culturalheritagedigital/Cindymill/README.md

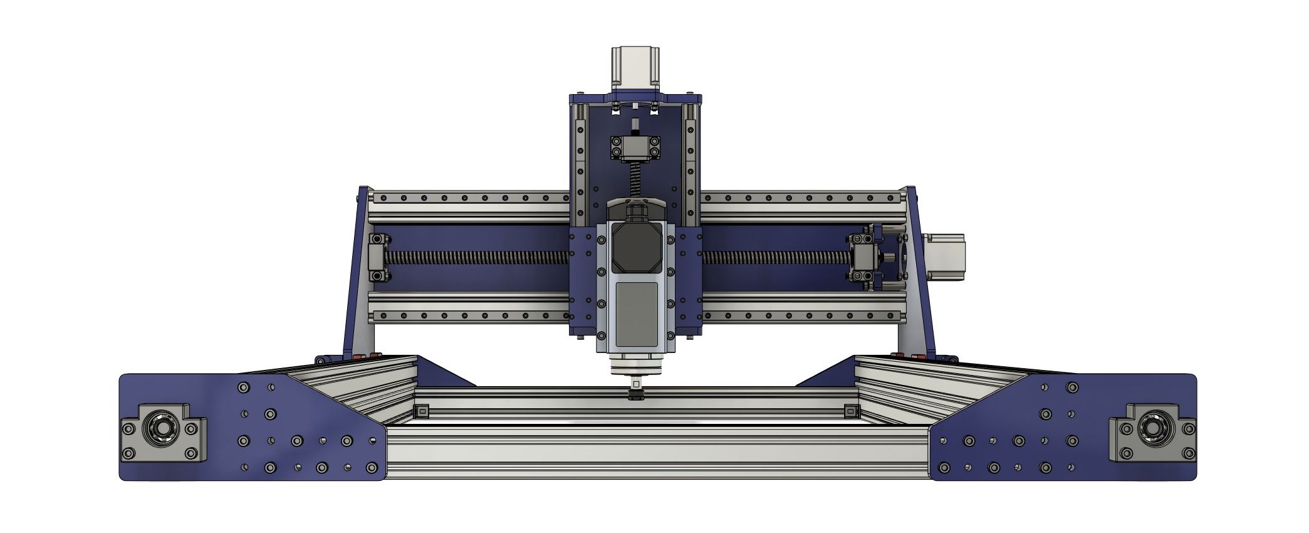
[picture p1: cindymill_front_1.jpg]
Cindymill


# Cindymill
**A gentle way to start CNC milling.**

Cindymill is a DIY CNC milling machine. It is supposed to be a good introduction to the world of milling. As you build the machine, you learn how it works. Cindymill is open source, so you can easily adapt it to your needs. The components are affordable, but the machine is rigid enough to comfortably mill aluminum (as well as wood and plastic, of course). 

## Short Specs
- Ball screws SFU1605 on X and Y,  SFU1204 on Z.
- Extruded profile: based on 20x20 Item type.
- Rails: MGN12
- Motors: NEMA23
- Work area: 750 x 475 x 120 mm, can easily be adapted to other sizes.
- Price: approx. 1500€/$.

You will find all relevant information about parts and assembly here [www.cindymill.xyz](http://www.cindymill.xyz).

If you like the project you can tip me via . Thanks. 

This work is licensed under a
[Creative Commons Attribution-NonCommercial-ShareAlike 4.0 International License][cc-by-nc-sa].

[][cc-by-nc-sa]

[cc-by-nc-sa]: http://creativecommons.org/licenses/by-nc-sa/4.0/
[cc-by-nc-sa-image]: https://licensebuttons.net/l/by-nc-sa/4.0/88x31.png
[cc-by-nc-sa-shield]: https://img.shields.io/badge/License-CC%20BY--NC--SA%204.0-lightgrey.svg

Cite the project in academics:
