culturalheritagedigital/Cindymill/Accessories/Readme.md

## Accessories

This section covers various (mostly printed) accessories which make the machine more convenient to use.

You will find descriptions about the individual parts here:

[http://www.cindymill.xyz/accessories](http://www.cindymill.xyz/addons)
