culturalheritagedigital/Cindymill/Tools/Readme.md

## Tools

These tools help you to align the portal and Z axis rails.

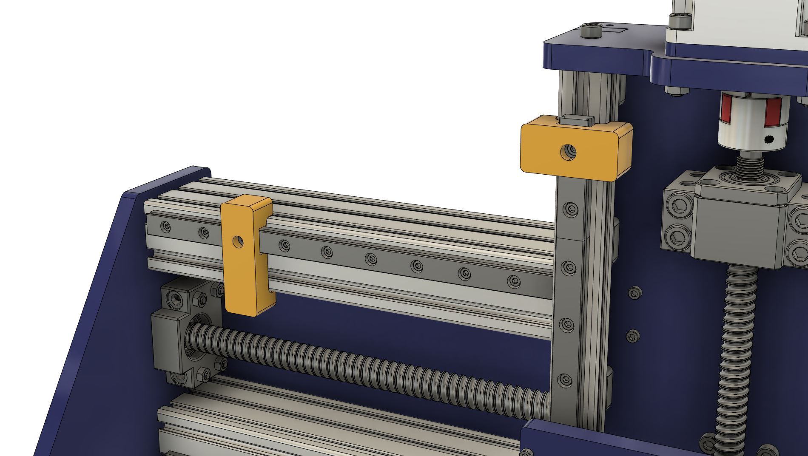
[picture p2: Tools/alignment_tools.jpg]
alignment_tools


[www.cindymill.xyz](http://www.cindymill.xyz)
