culturalheritagedigital/Cindymill/model/Accessories/Readme.md

## Accessories

This section covers various (mostly printed) accessories which make the machine more convenient to use.

You will find descriptions about the individual parts here:

[Accessories page on the Cindymill website](https://culturalheritagedigital.github.io/Cindymill/accessories.html)
