culturalheritagedigital/Cindymill/10mm_Milled_Aluminum_Version/Spacers/Readme.md

## Spacers

These are spacers you can print if not possible otherwise.
If so, print them really heavy. I did 5 perimeters in all directions, 25% infill.

[www.cindymill.xyz](http://www.cindymill.xyz)
