culturalheritagedigital/Cindymill/files.md

---
title: "Files"
layout: page
introduction: |
  You can download or fork all project files for the Cindymill from Github: 
actions:
  - label: "Download project files"
    icon: github
    url: "https://github.com/culturalheritagedigital/Cindymill"
---

In case you are new to Github:
- To download the project click the green "Code" button,
- click "Download ZIP".

download

---

If you want to adapt Cindymill to your needs you can download the __complete model as one step file__ here: 

<!-- <a href="{{ '/assets/cad/2021_09_22_Cindymill_Complete_Model.zip' | relative_url }}">Download Model</a> -->

<a href="{{ '/assets/cad/2021_09_22_Cindymill_Complete_Model.zip' | relative_url }}">
Step File
</a>

Current version: 2021_09_22

---

If you want to compare the target and actual dimensions of your machined plates, you can download __drawings with marked dimensions__ [here]({{ '/assets/cad/Cindymill_Drawings.zip' | relative_url }}).

<br>

<a rel="license" href="https://creativecommons.org/licenses/by-nc-sa/4.0/">Creative Commons License</a><br />This work is licensed under a <a rel="license" href="https://creativecommons.org/licenses/by-nc-sa/4.0/">Creative Commons Attribution-NonCommercial-ShareAlike 4.0 International License</a>.
