culturalheritagedigital/Cindymill/gallery.md

---
title: "Gallery"
layout: page

image: 
  path: /assets/images/gallery/frame_bw.jpg
  thumbnail: /assets/images/gallery/frame_bw.jpg

introduction: |
  A growing collection of Cindymill related images and videos. Enjoy!
---

## Frame

<figure class="align-center">
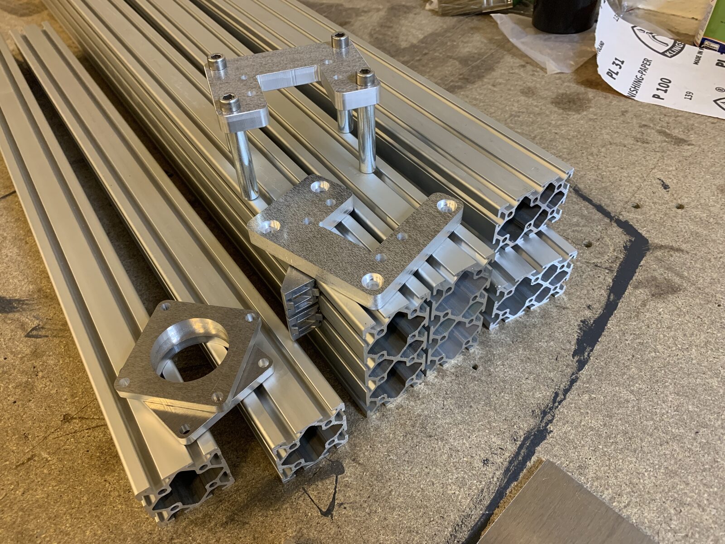
[picture p3: assets/images/gallery/frame/frame2.jpg]
  
  <figcaption>Frame profiles</figcaption>
</figure> 

<figure class="align-center">
  
  <figcaption>Thread cutting</figcaption>
</figure> 

<figure class="align-center">
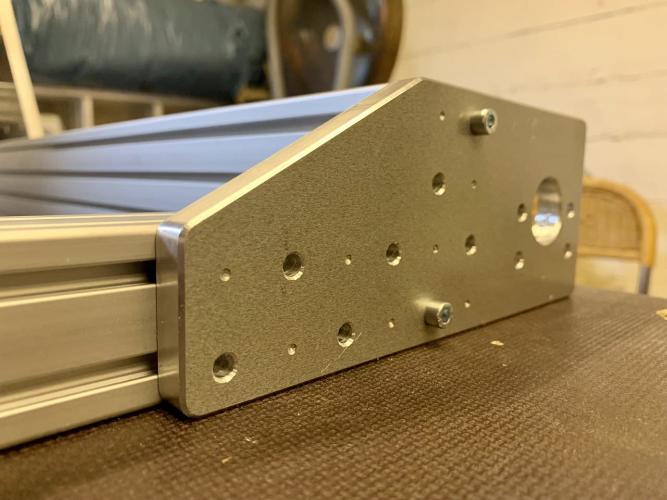
[picture p4: assets/images/gallery/frame/frame10.jpg]
  
  <figcaption>Frame assembly</figcaption>
</figure> 

<figure class="align-center">
  
  <figcaption>Indymill comparison</figcaption>
</figure> 

<figure class="align-center">
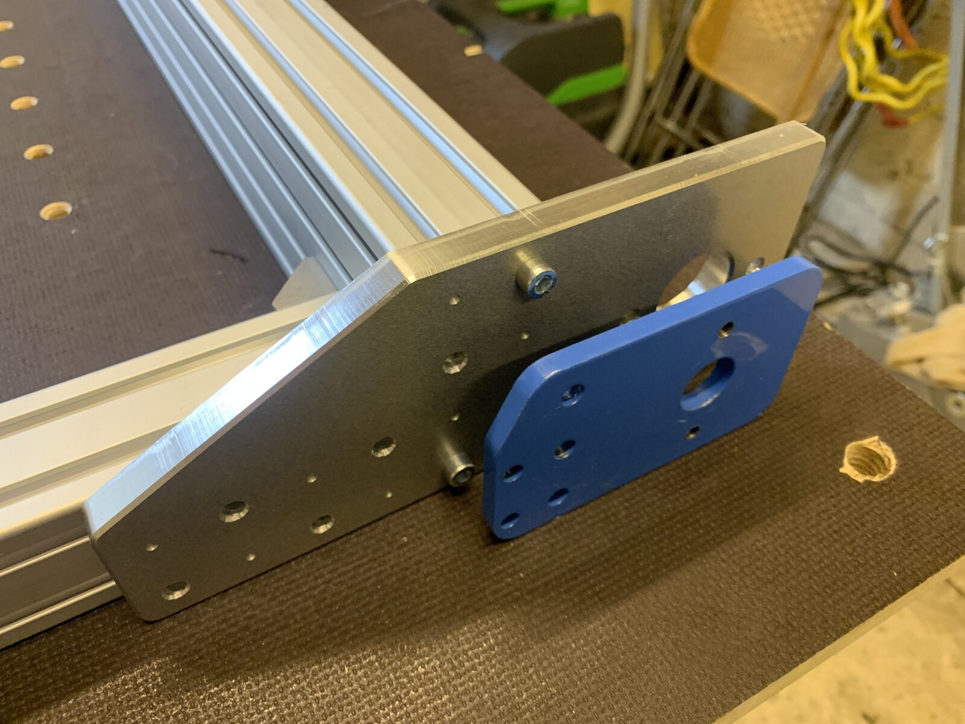
[picture p5: assets/images/gallery/frame/frame12.jpg]
  
  <figcaption>Indymill comparison</figcaption>
</figure> 

<figure class="align-center">
  
  <figcaption>Frame assembly</figcaption>
</figure> 

<figure class="align-center">
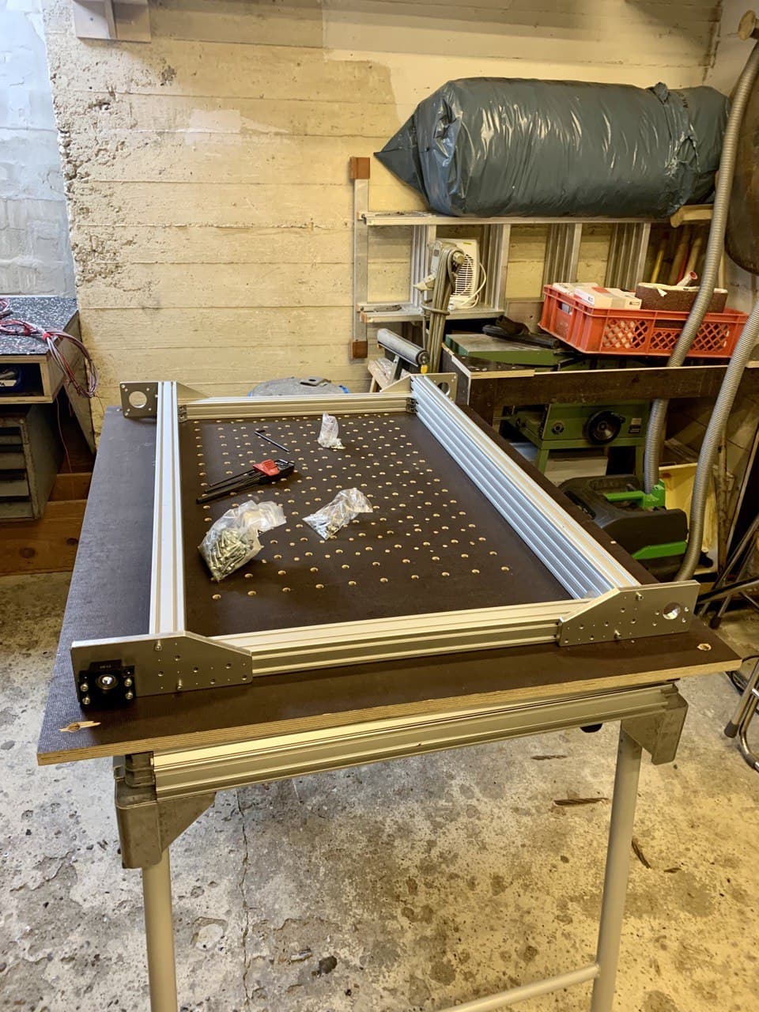
[picture p6: assets/images/gallery/frame/frame8.jpg]
  
  <figcaption>Frame assembly</figcaption>
</figure> 

<figure class="align-center">
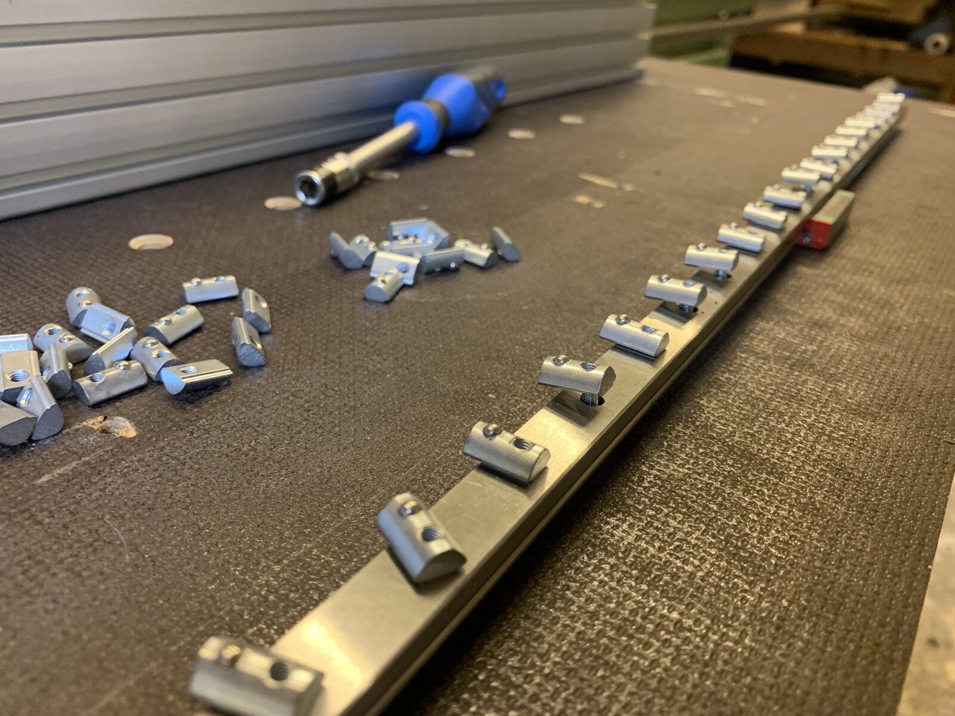
[picture p7: assets/images/gallery/frame/frame14.jpg]
  
  <figcaption>Frame assembly</figcaption>
</figure> 

<figure class="align-center">
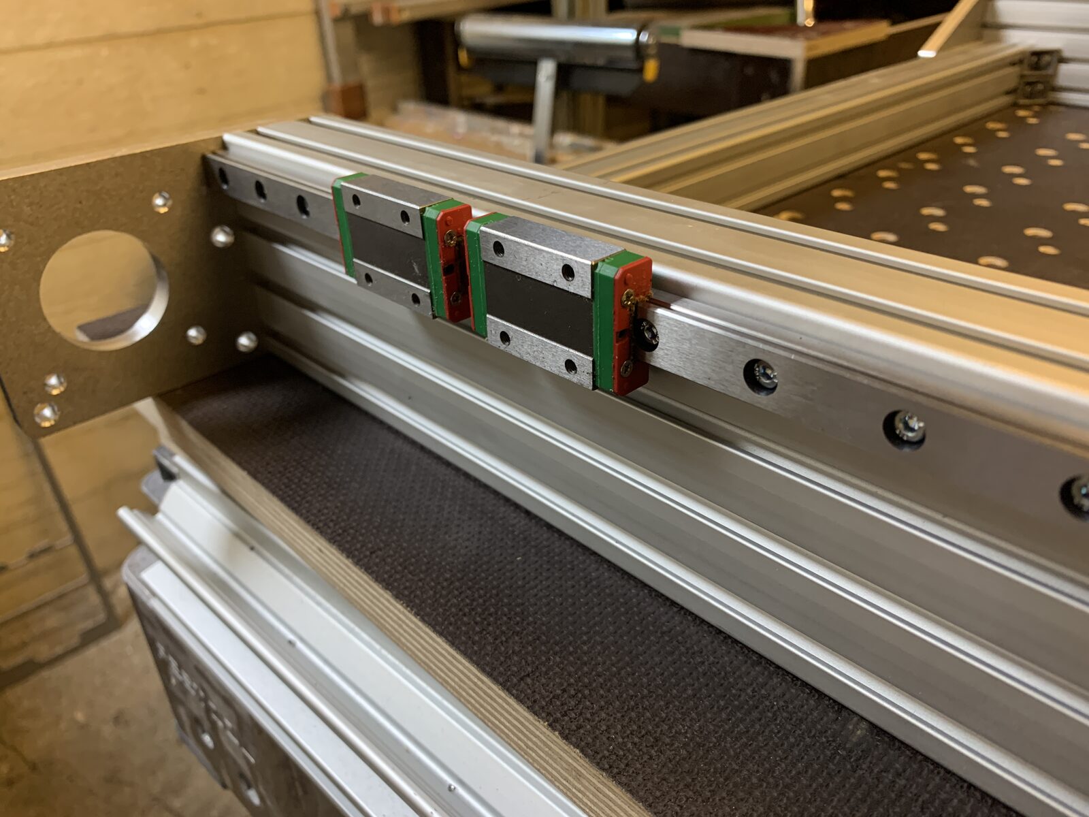
[picture p8: assets/images/gallery/frame/frame15.jpg]
  
  <figcaption>Frame assembly</figcaption>
</figure> 

<figure class="align-center">
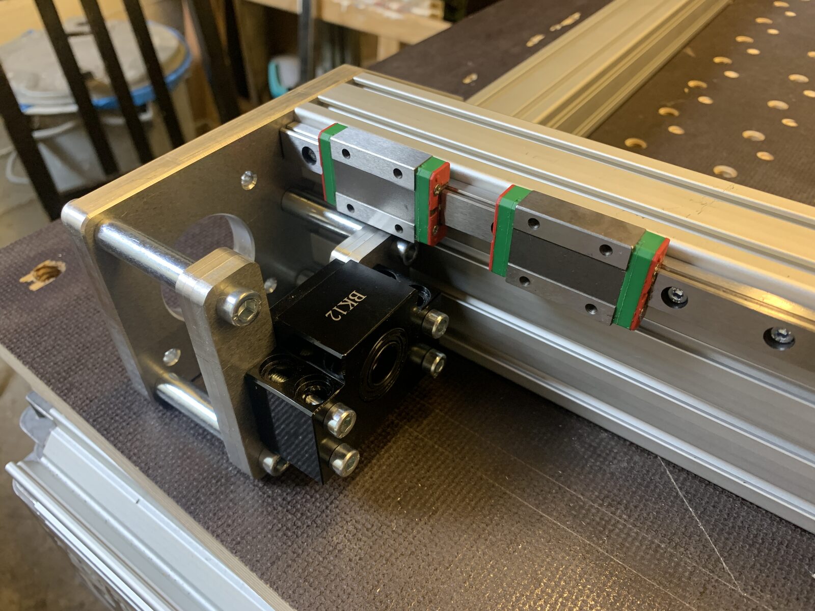
[picture p9: assets/images/gallery/frame/frame18.jpg]
  
  <figcaption>Frame assembly</figcaption>
</figure> 

<figure class="align-center">
  
  <figcaption>Frame assembly</figcaption>
</figure> 

<figure class="align-center">
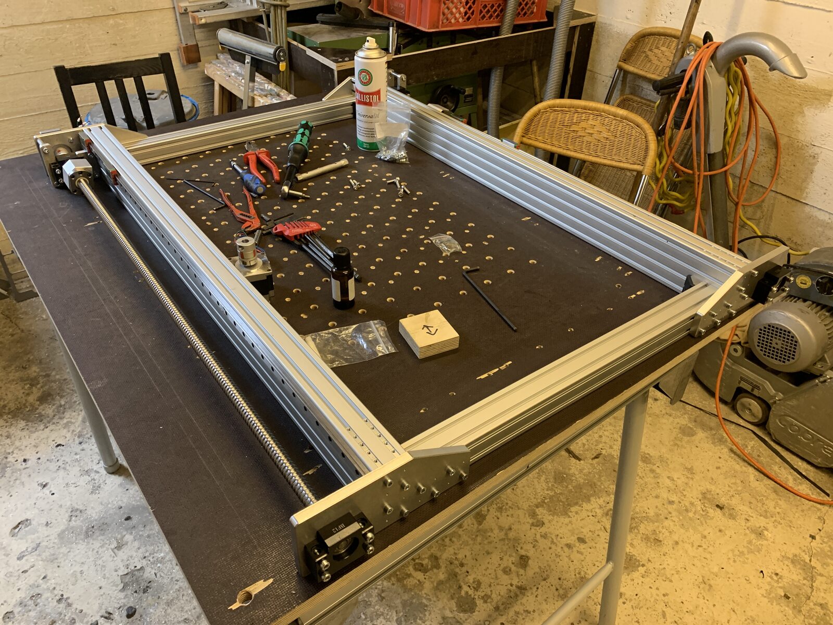
[picture p10: assets/images/gallery/frame/frame22.jpg]
  
  <figcaption>Frame assembly</figcaption>
</figure> 

<figure class="align-center">
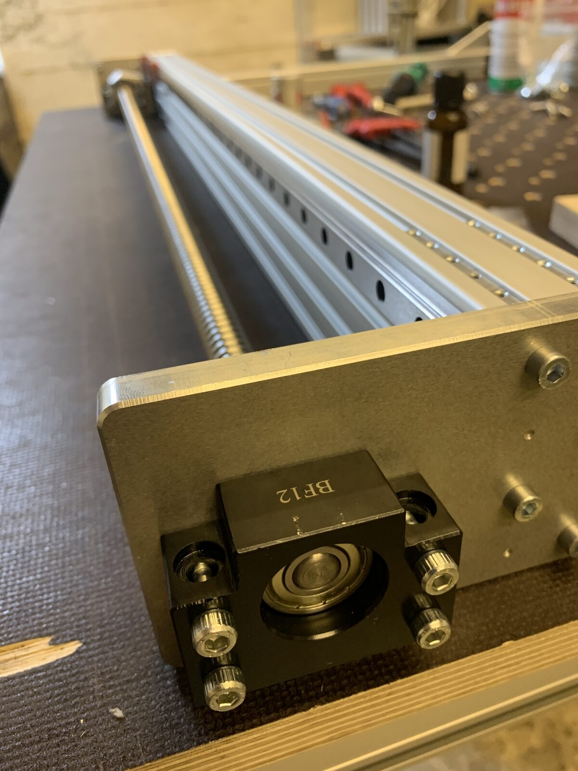
[picture p11: assets/images/gallery/frame/frame23.jpg]
  
  <figcaption>Frame assembly</figcaption>
</figure> 

<figure class="align-center">
  
  <figcaption>Frame assembly</figcaption>
</figure> 

<figure class="align-center">
  
  <figcaption>Frame assembly</figcaption>
</figure> 

<figure class="align-center">
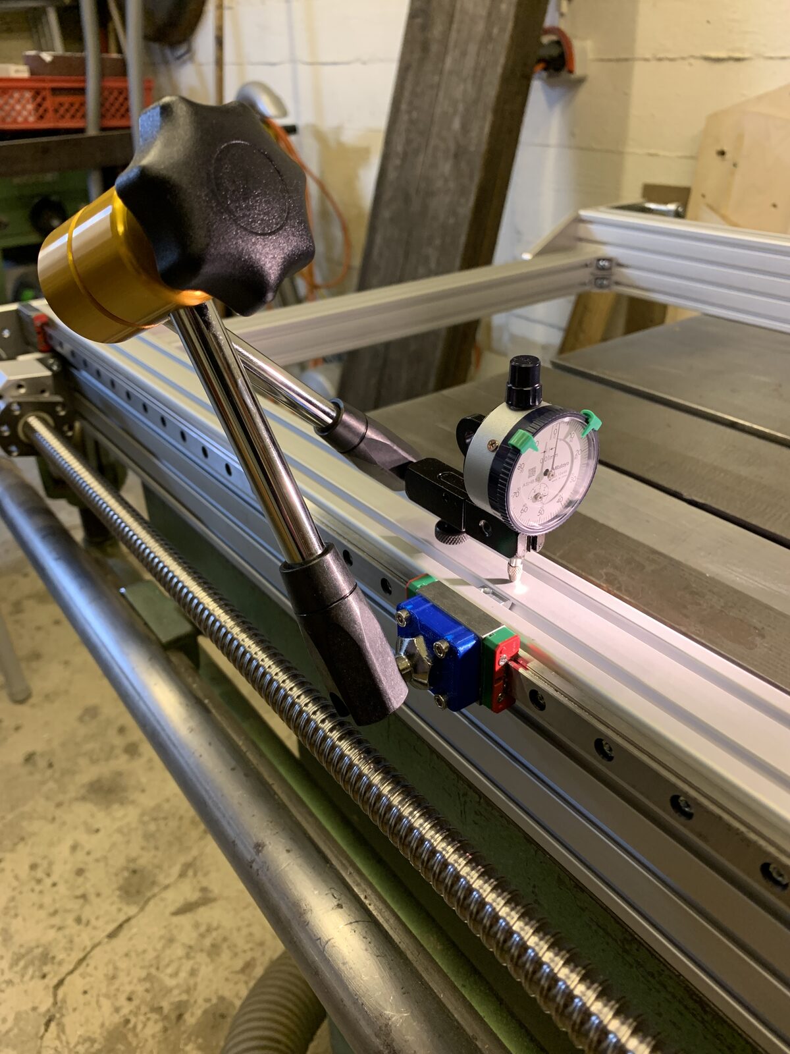
[picture p12: assets/images/gallery/frame/frame_alignment1.jpg]
  
  <figcaption>Rail alignment</figcaption>
</figure> 

<!-- <figure class="align-center">
  <a href="#"><img src="{{ '/assets/images/gallery/frame/plates2.jpg' | relative_url }}" alt=""></a>
  <figcaption>Testing threaded steel sockets</figcaption>
</figure>  -->

<!-- <figure class="align-center">
  <a href="#"><img src="{{ '/assets/images/gallery/frame/frame3.jpg' | relative_url }}" alt=""></a>
  <figcaption>Testing threaded steel sockets</figcaption>
</figure>  -->

<!-- ################################################################################################################ -->

## Portal

<figure class="align-center">
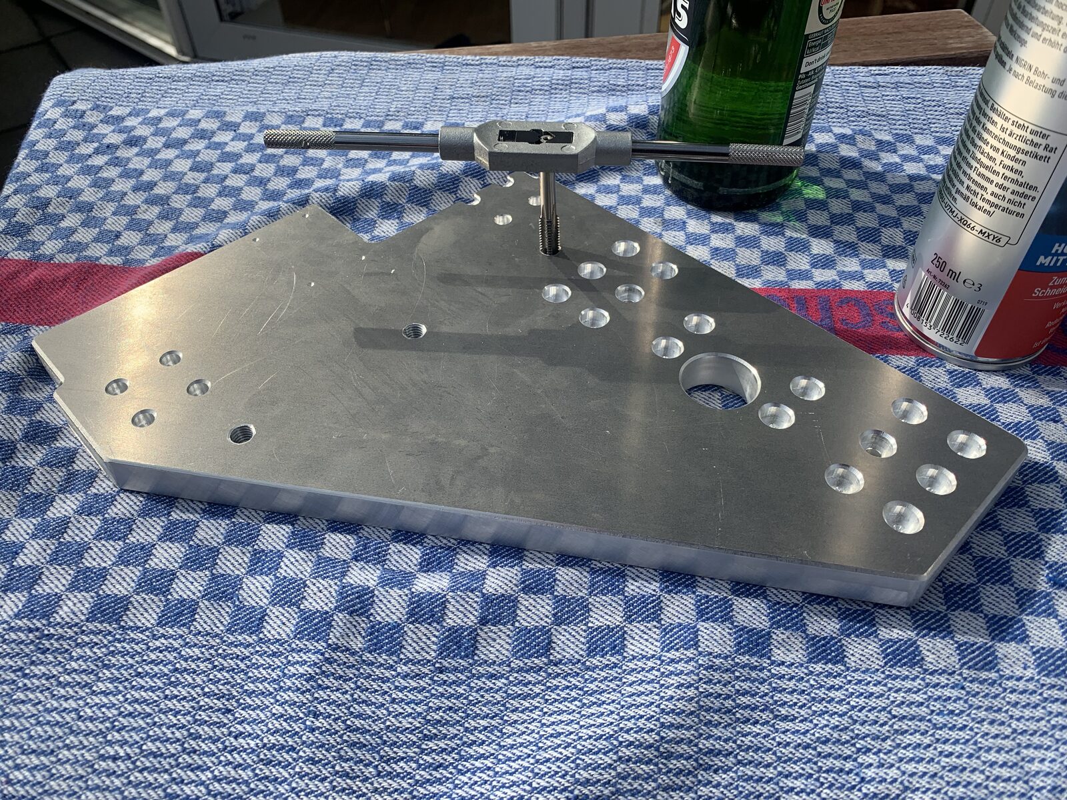
[picture p13: assets/images/gallery/portal/plates8.jpg]
  
  <figcaption>Thread cutting</figcaption>
</figure> 

<figure class="align-center">
  
  <figcaption>Portal assembly</figcaption>
</figure> 

<figure class="align-center">
  
  <figcaption>Portal assembly</figcaption>
</figure> 

<figure class="align-center">
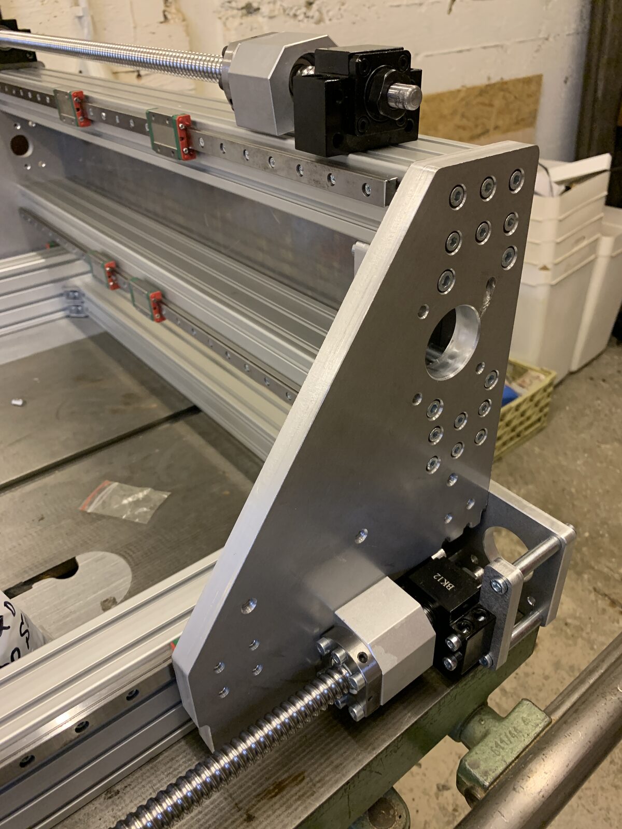
[picture p14: assets/images/gallery/portal/IMG_3700.JPG]
  
  <figcaption>Portal assembly</figcaption>
</figure> 

<figure class="align-center">
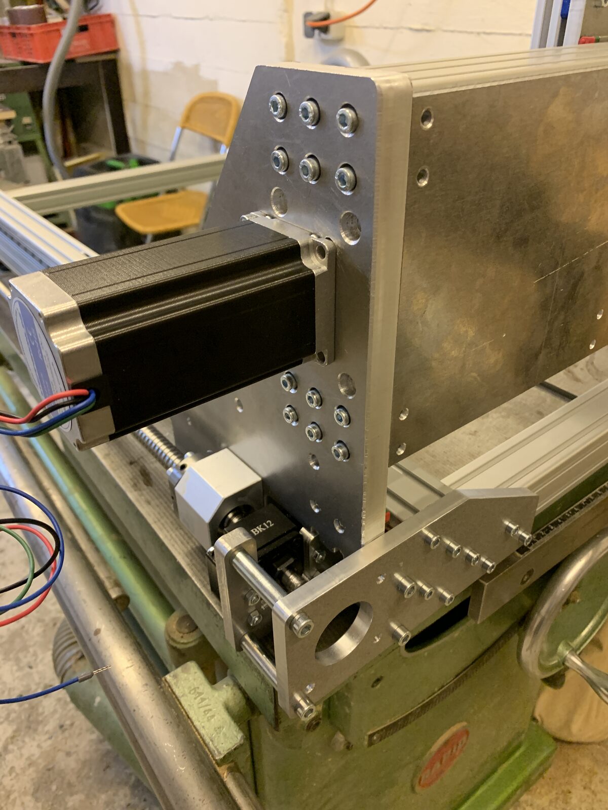
[picture p15: assets/images/gallery/portal/IMG_3696.JPG]
  
  <figcaption>Portal assembly</figcaption>
</figure> 

<!-- <figure class="align-center">
  <a href="#"><img src="{{ '/assets/images/gallery/portal/IMG_3702.JPG' | relative_url }}" alt=""></a>
  <figcaption>Portal assembly</figcaption>
</figure>  -->

<figure class="align-center">
  
  <figcaption>Portal assembly</figcaption>
</figure> 

<figure class="align-center">
  
  <figcaption>Portal assembly</figcaption>
</figure> 

<figure class="align-center">
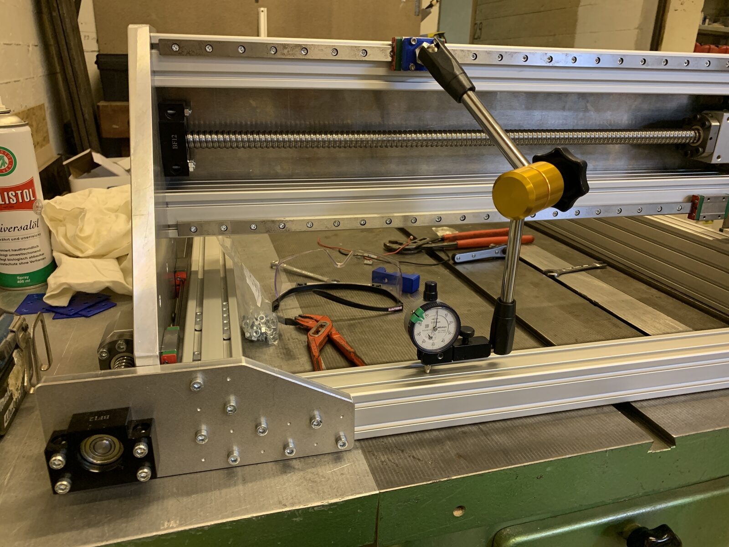
[picture p16: assets/images/gallery/portal/IMG_3705.JPG]
  
  <figcaption>Portal rail alignment</figcaption>
</figure> 

<!-- <figure class="align-center">
  <a href="#"><img src="{{ '/assets/images/gallery/portal/portal1.jpg' | relative_url }}" alt=""></a>
  <figcaption>Portal assembly</figcaption>
</figure> 

<figure class="align-center">
  <a href="#"><img src="{{ '/assets/images/gallery/portal/portal2.jpg' | relative_url }}" alt=""></a>
  <figcaption>Portal assembly</figcaption>
</figure> 

<figure class="align-center">
  <a href="#"><img src="{{ '/assets/images/gallery/portal/portal3.jpg' | relative_url }}" alt=""></a>
  <figcaption>Portal assembly</figcaption>
</figure>  -->

<figure class="align-center">
  
  <figcaption>Comparison with Indymill</figcaption>
</figure> 

<!-- ################################################################################################################ -->

## Z Axis

<figure class="align-center">
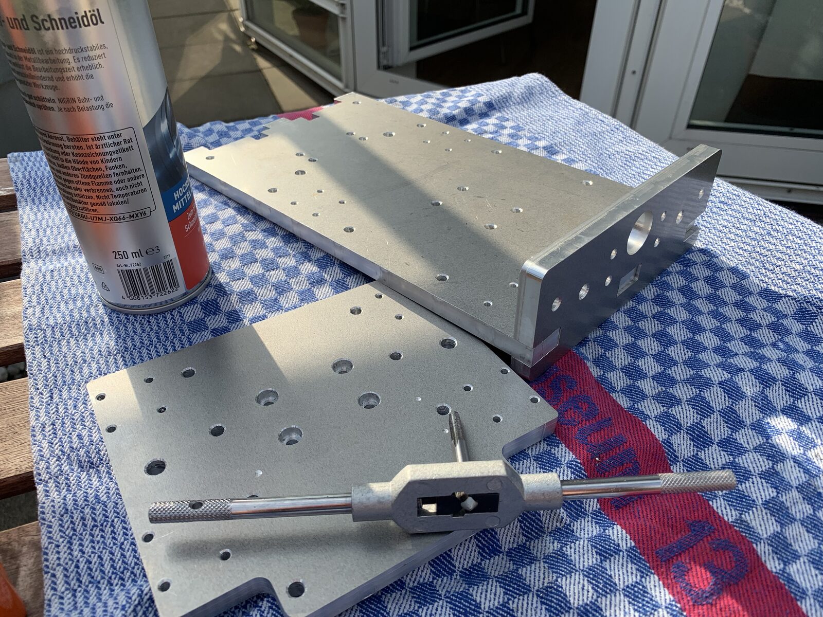
[picture p17: assets/images/gallery/zaxis/plates7.jpg]
  
  <figcaption>Thread cutting</figcaption>
</figure> 

<figure class="align-center">
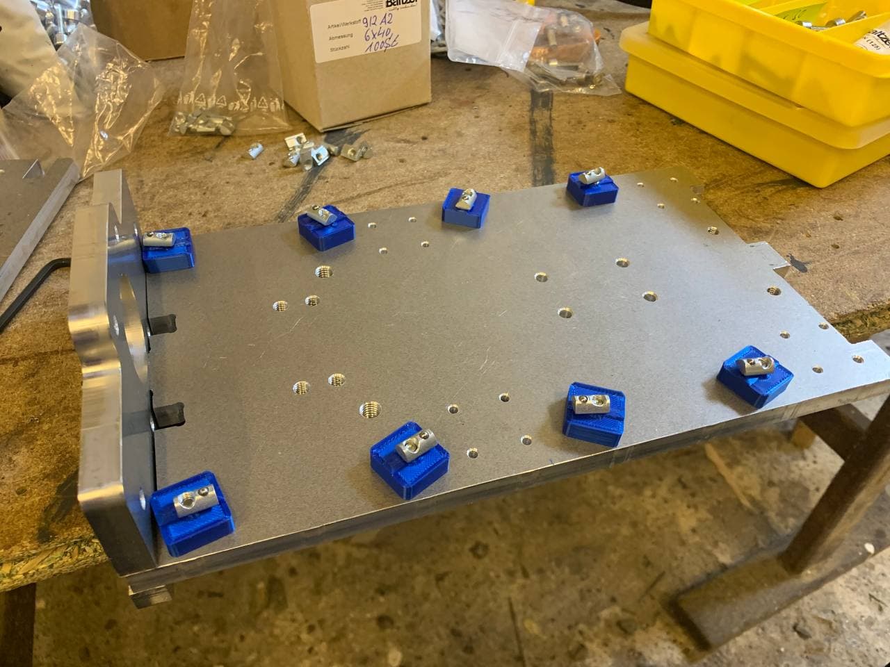
[picture p18: assets/images/gallery/zaxis/zaxis4.jpg]
  
  <figcaption>Z axis assembly</figcaption>
</figure> 

<figure class="align-center">
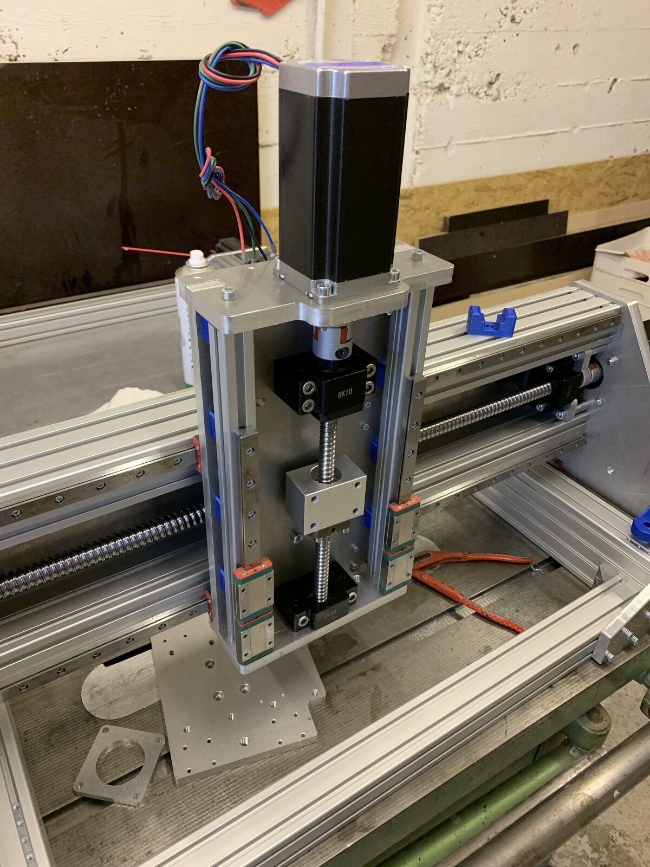
[picture p19: assets/images/gallery/zaxis/IMG_3723.JPG]
  
  <figcaption>Z axis assembly</figcaption>
</figure> 

<figure class="align-center">
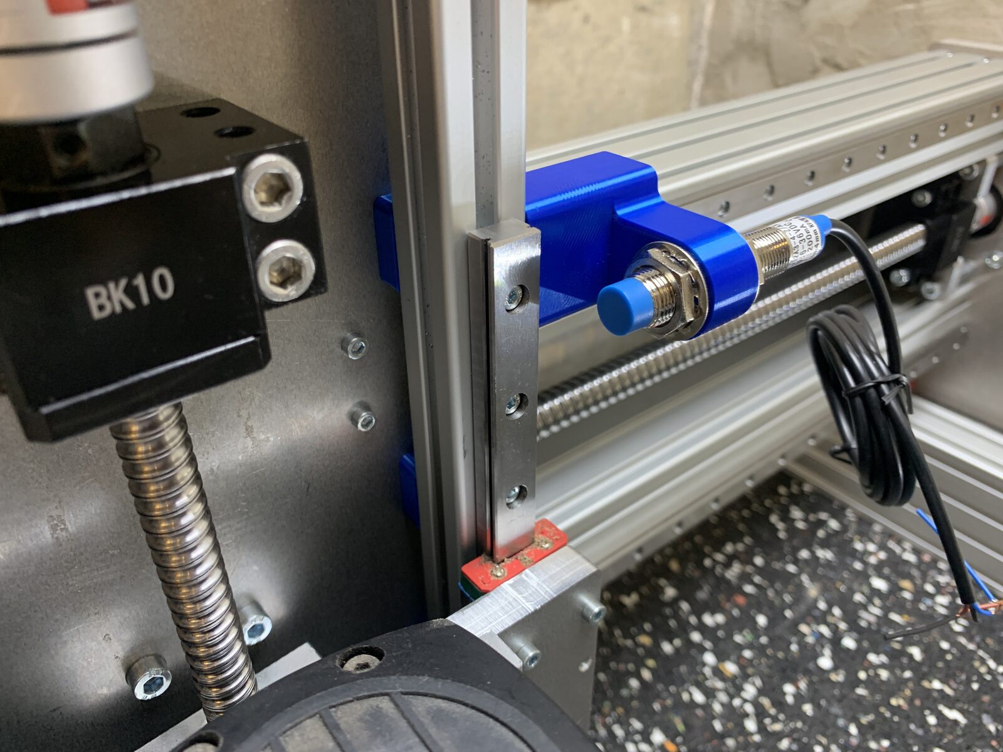
[picture p20: assets/images/gallery/zaxis/IMG_3743.JPG]
  
  <figcaption>Z axis limit switch</figcaption>
</figure> 

<figure class="align-center">
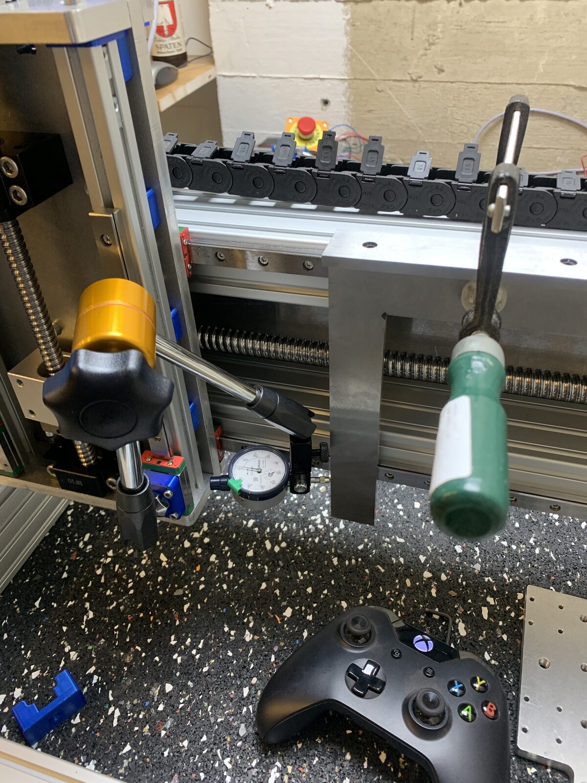
[picture p21: assets/images/gallery/zaxis/IMG_3753.JPG]
  
  <figcaption>Z axis alignment</figcaption>
</figure> 

<figure class="align-center">
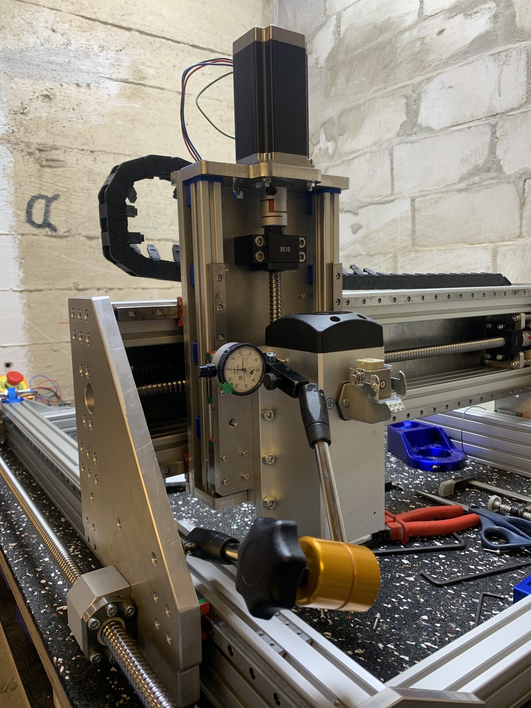
[picture p22: assets/images/gallery/zaxis/IMG_3757.JPG]
  
  <figcaption>Spindle alignment</figcaption>
</figure> 

<figure class="align-center">
  
  <figcaption>Yeah!</figcaption>
</figure> 

<figure class="align-center">
  
  <figcaption>Yeah!</figcaption>
</figure> 

<!-- <figure class="align-center">
  <a href="#"><img src="{{ '/assets/images/gallery/zaxis/zaxis1.jpg' | relative_url }}" alt=""></a>
  <figcaption>Z axis assembly</figcaption>
</figure> 

<figure class="align-center">
  <a href="#"><img src="{{ '/assets/images/gallery/zaxis/zaxis3.jpg' | relative_url }}" alt=""></a>
  <figcaption>Z axis assembly</figcaption>
</figure>  -->

<!-- ################################################################################################################ -->

## Electronics

<figure class="align-center">
  
  <figcaption>Finished soldering the shield</figcaption>
</figure> 

<figure class="align-center">
  
  <figcaption>Backside of the shield</figcaption>
</figure> 

<figure class="align-center">
  
  <figcaption>It works!</figcaption>
</figure> 

<!-- ################################################################################################################ -->

## Ball Screw Preparation

<figure class="align-center">
  
  <figcaption>Degreasing ball screw nuts</figcaption>
</figure> 

<figure class="align-center">
  
  <figcaption>Degreasing ball screw nuts</figcaption>
</figure> 

<figure class="align-center">
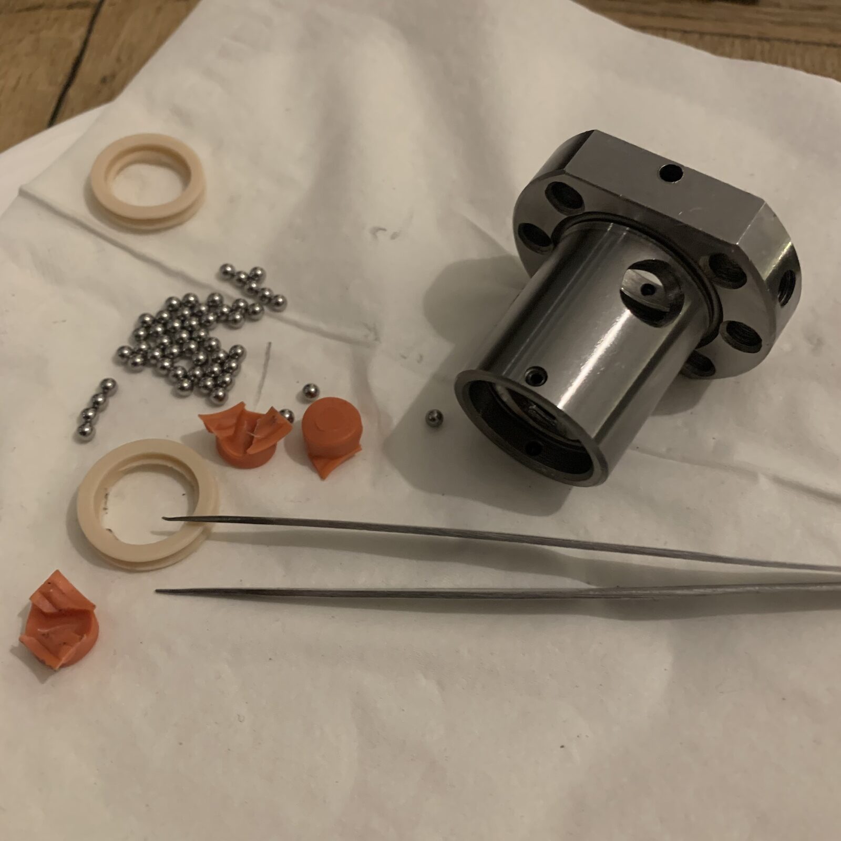
[picture p23: assets/images/gallery/ballscrew/ballscrew1.jpg]
  
  <figcaption>Ball screw nut parts</figcaption>
</figure> 

<figure class="align-center">
  
  <figcaption>Nut assembly</figcaption>
</figure> 

<figure class="align-center">
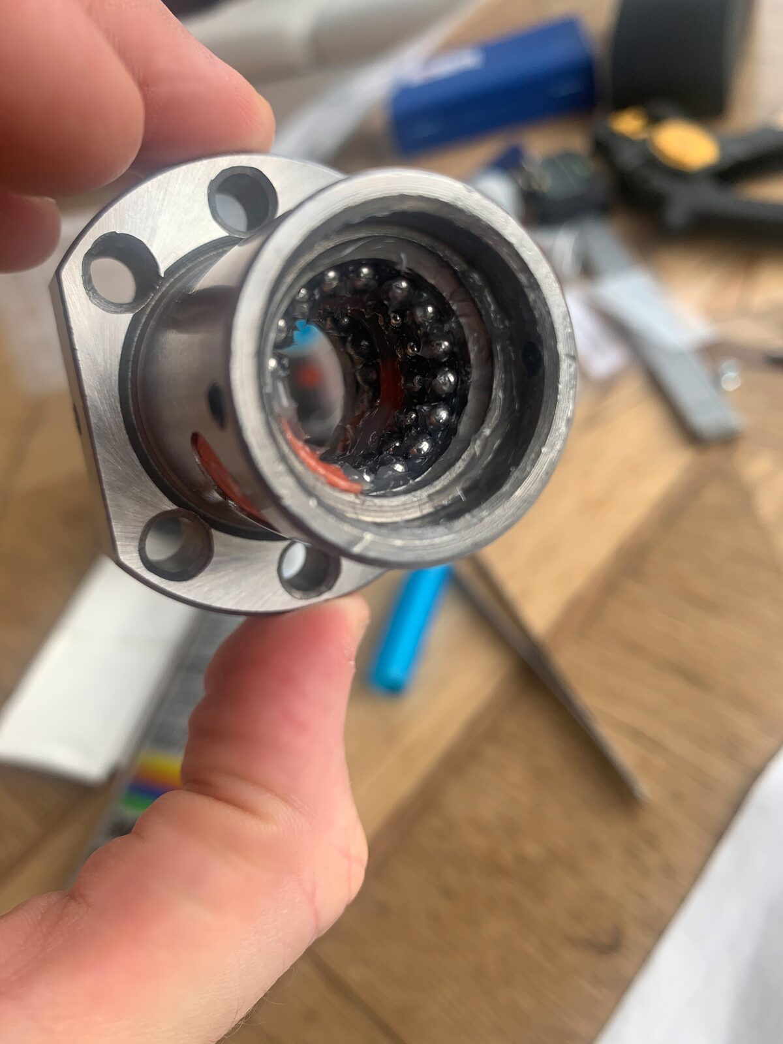
[picture p24: assets/images/gallery/ballscrew/ballscrew2.jpg]
  
  <figcaption>Fresh!</figcaption>
</figure> 

<!-- ################################################################################################################ -->

## Milling

<figure class="align-center">
  
  <figcaption>Milling frame plates</figcaption>
</figure> 

<figure class="align-center">
  
  <figcaption>Milling frame plates</figcaption>
</figure> 

<figure class="align-center">
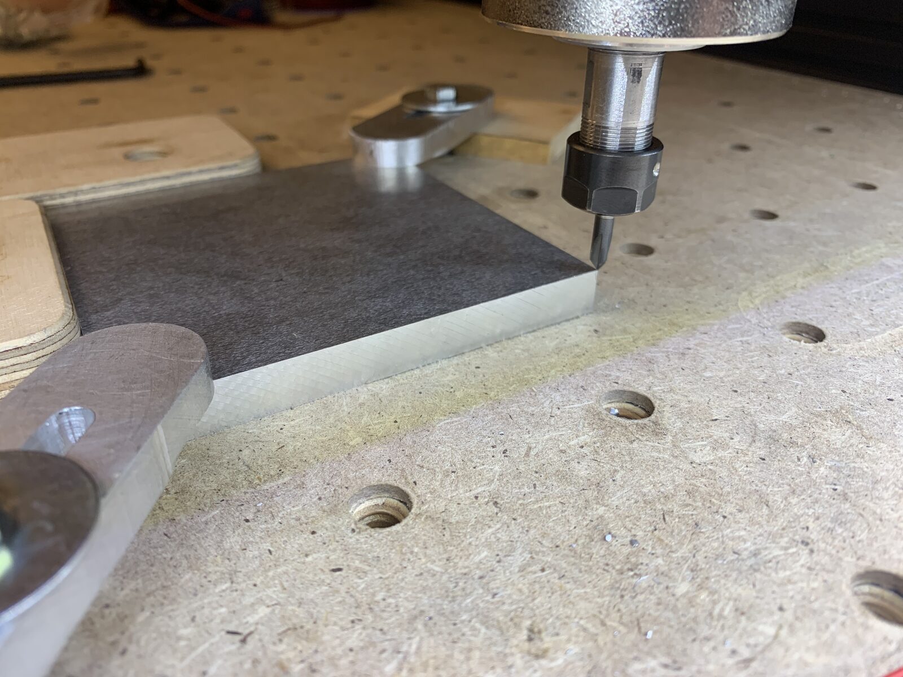
[picture p25: assets/images/gallery/milling/milling1.jpg]
  
  <figcaption>Milling aluminum</figcaption>
</figure> 

<figure class="align-center">
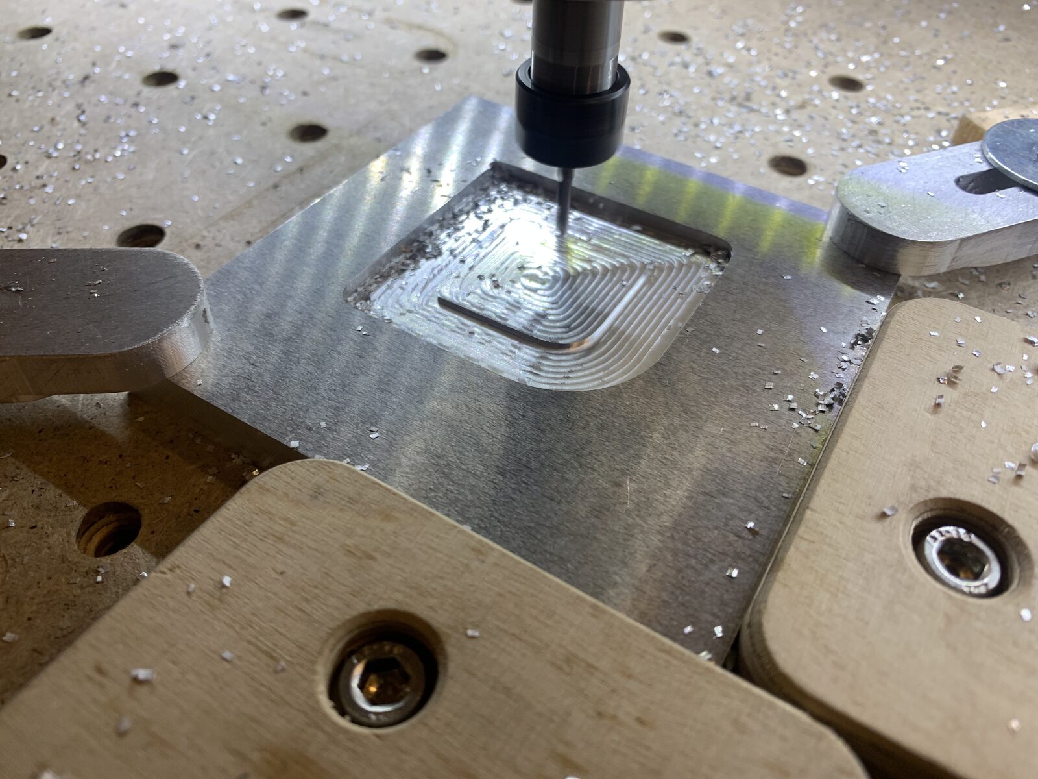
[picture p26: assets/images/gallery/milling/milling2.jpg]
  
  <figcaption>Milling aluminum</figcaption>
</figure> 

<figure class="align-center">
  
  <figcaption>Milling aluminum</figcaption>
</figure> 

<figure class="align-center">
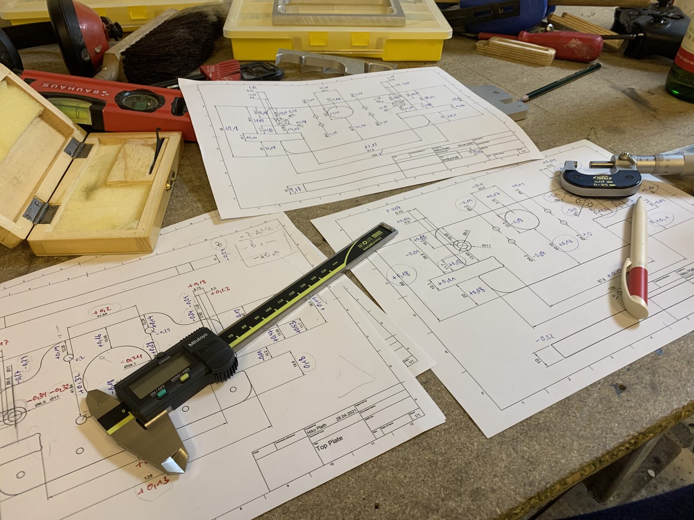
[picture p27: assets/images/gallery/milling/measurements5.jpg]
  
  <figcaption>Measurements</figcaption>
</figure> 

<figure class="align-center">
  
  <figcaption>Milling acrylic</figcaption>
</figure> 

<figure class="align-center">
  
  <figcaption>Milling acrylic</figcaption>
</figure> 

<figure class="align-center">
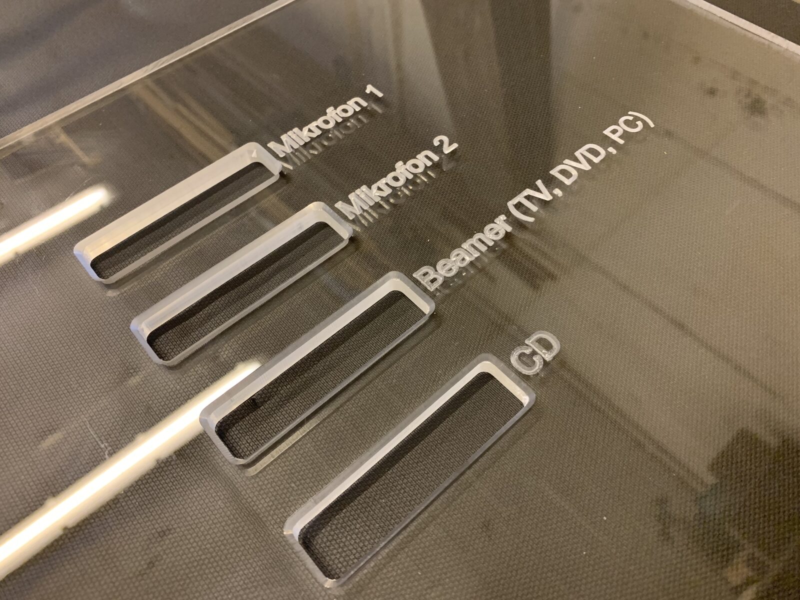
[picture p28: assets/images/gallery/milling/acrylic3.jpg]
  
  <figcaption>Milling acrylic</figcaption>
</figure> 

<!-- ################################################################################################################ -->

## Stuff

<figure class="align-center">
  
  <figcaption>Inductive limit switches</figcaption>
</figure> 

<figure class="align-center">
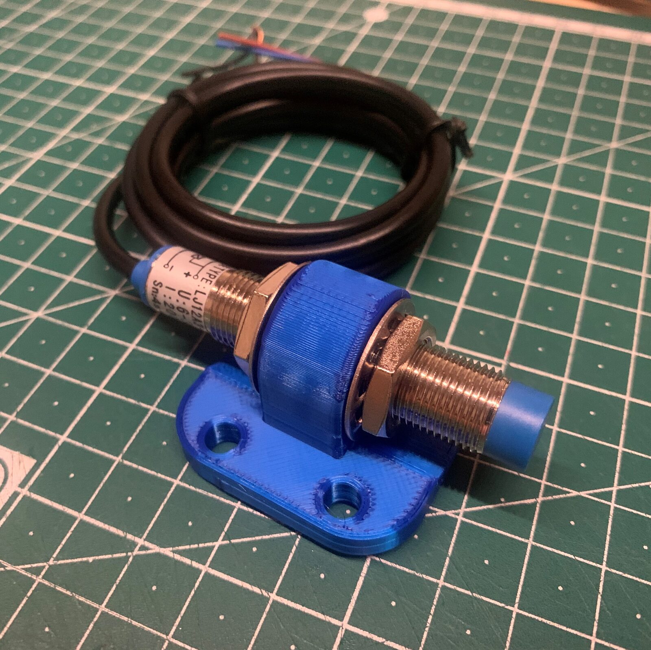
[picture p29: assets/images/gallery/stuff/limitswitches2.jpg]
  
  <figcaption>Limit switch holder</figcaption>
</figure> 

<figure class="align-center">
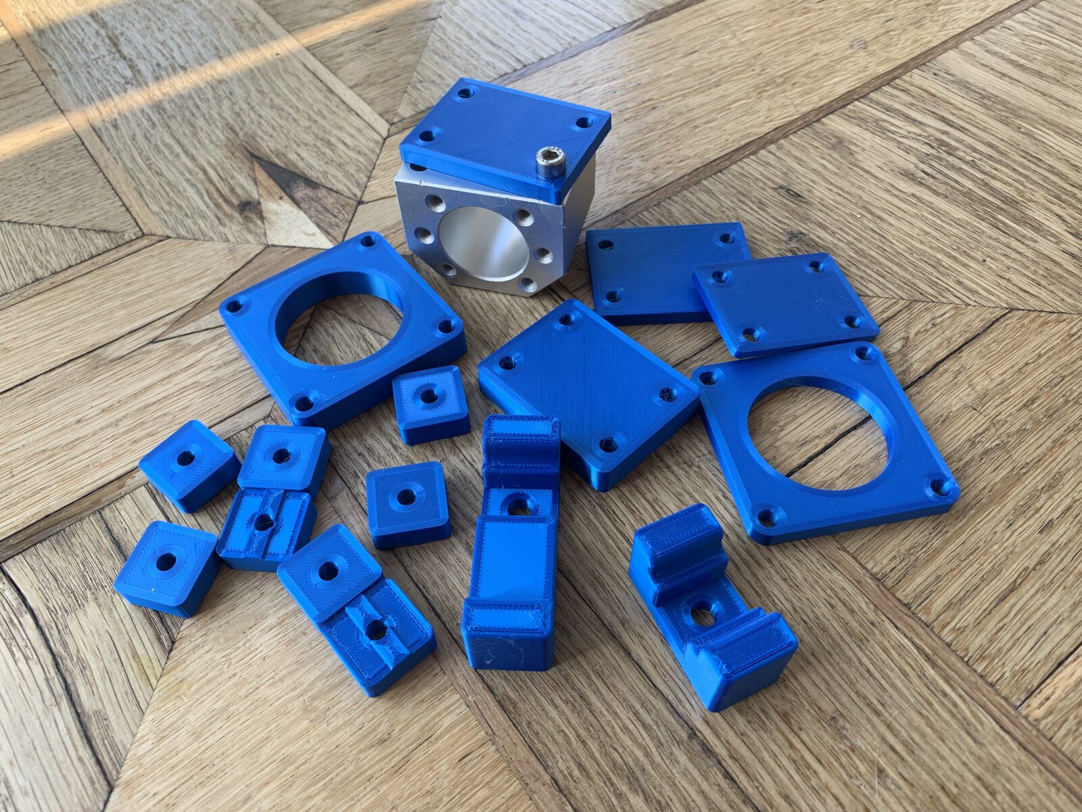
[picture p30: assets/images/gallery/stuff/printed1.jpg]
  
  <figcaption>Printed parts</figcaption>
</figure> 

<figure class="align-center">
  
  <figcaption>Table for the machine</figcaption>
</figure> 

<figure class="align-center">
  
  <figcaption>Table for the machine</figcaption>
</figure> 

<figure class="align-center">
  
  <figcaption>Vacuum cleaner holder for 1.5kW spindle</figcaption>
</figure> 

<figure class="align-center">
  
  <figcaption>Vacuum cleaner holder for 1.5kW spindle</figcaption>
</figure> 

<figure class="align-center">
  
  <figcaption>Vacuum cleaner holder for 1.5kW spindle</figcaption>
</figure>
