culturalheritagedigital/Cindymill/_posts/2021-08-15-Gallery.md

---
title: "Gallery added!"
read_time: true
layout: post
categories:
  - start
tags:
  - content
image: "/assets/images/frame_bw.jpg"
---
I added a gallery with a (growing) collection of Cindymill related images: assembly process, tools, parts, measurements, failures and successes. [Feel free to take a look around!]({{ '/gallery.html' | relative_url }}){:target="_blank"}
