culturalheritagedigital/Cindymill/_posts/2021-09-27-Accessories.md

---
title: "Accessories section added!"
read_time: true
layout: post
categories:
  - start
tags:
  - content
image: "/assets/images/Accessories_Post_Title1.jpg"
---
I added a new section with accessories for the Cindymill: limit switches, cable chains, and a vacuum cleaner holder so far.
All files can be downloaded (in stl and step format) from Github.
[Take a look around!]({{ '/accessories.html' | relative_url }}){:target="_blank"}
