culturalheritagedigital/Cindymill/assets/images/badges/README.txt

Badges — lokal ausgeliefert statt von Fremdservern (AP 5, Befund L)
==================================================================

Diese drei Dateien wurden am 30.07.2026 einmalig von ihren Ursprungs-Hosts
geladen und liegen seitdem im Repository. Der Grund ist Datenschutz: jeder
Abruf eines Bildes von einem fremden Host uebertraegt die IP-Adresse der
Besucherin oder des Besuchers dorthin — ohne Einwilligung und ohne dass es
im Seiteninhalt sichtbar waere. Es ist dieselbe Ueberlegung, aus der in
AP 4 die Google Fonts self-hosted wurden.

Die verlinkten Ziele (PayPal, Creative Commons, Zenodo-DOI) sind unveraendert
geblieben — nur die Bilder kommen jetzt aus dem eigenen Repo.

  paypal-tip-me.svg
    https://img.shields.io/badge/PayPal-tip%20me-green.svg?logo=paypal
    109x20 px. shields.io stellt seine Badges unter CC0 1.0 bereit.
    Das PayPal-Logo steckt als data:-URI im SVG, es gibt keine
    externen Referenzen darin.

  cc-by-nc-sa-4.0-88x31.png
    https://licensebuttons.net/l/by-nc-sa/4.0/88x31.png
    88x31 px. Byte-identisch mit dem Button von
    https://i.creativecommons.org/l/by-nc-sa/4.0/88x31.png (SHA-256
    c15eb6363ffed47e2913229559af9d19974d4dc35e97a84bac0bb3e25bdc87c8),
    deshalb bedient diese eine Datei beide bisherigen Einbindungen
    (index.html und files.md). Creative Commons stellt die Lizenz-Buttons
    ausdruecklich zur Kennzeichnung der eigenen Werke bereit; die
    CC-Marken bleiben Eigentum von Creative Commons.

  zenodo-doi-5118794.svg
    https://zenodo.org/badge/DOI/10.5281/zenodo.5118794.svg
    184x20 px. Zeigt den DOI 10.5281/zenodo.5118794.

Der Preis dieser Entscheidung: die Badges sind jetzt Standbilder. Der
Zenodo-Badge wuerde eine neue DOI-Version nicht mehr selbst nachziehen —
bei einem neuen Release ist diese Datei zu ersetzen. Genutzt wurde diese
Aktualisierbarkeit ohnehin nie: die DOI steht seit 2021 unveraendert im
Quelltext.
