culturalheritagedigital/Cindymill/MODERNISIERUNG_UND_GITHUB_PAGES.md

# Cindymill — Technische Modernisierung & Umzug zu GitHub Pages

**Stand:** 30.07.2026 (Rev. 11 — AP 0–6 ausgeführt, AP 7.1/7.2/7.3-Readmes erledigt. **Die Site ist live:** https://culturalheritagedigital.github.io/Cindymill/)
**Arbeitsordner (Jekyll-Quellcode):** `/Users/nikoplath/Code/2026_Website_Cindymill`
**Backup des Ionos-Servers:** `/Users/nikoplath/Code/2026_Backup_Website_Cindymill_Ionos` (FTP-Spiegel inkl. `logs/`, 995 MB)

> Der frühere Quellordner `/Users/nikoplath/Daten/Website/Cindymill/work/` ist leer — der Quellcode liegt jetzt vollständig im Arbeitsordner. Der FTP-Spiegel ist ins Backup ausgelagert. Damit ist die Ausgangslage sauber getrennt.

## Rahmenbedingungen (Entscheidungen vom 29.07.2026)

| Entscheidung | Konsequenz |
|---|---|
| **Inhalt bleibt 1:1 erhalten**, die Seite wird **nicht erweitert** | Rein technischer Umzug. Keine neuen Seiten, keine neuen Medien, kein Reaktivieren auskommentierter Inhalte (Videos, Suche). |
| **Ionos-Webspace *und* Domain `cindymill.xyz` werden gekündigt** | Kein Custom-Domain-Setup, kein DNS, kein CNAME. Zieladresse ist dauerhaft `https://culturalheritagedigital.github.io/Cindymill/`. Siehe Risiken. |
| **Die Website zieht in das bestehende Repo `culturalheritagedigital/Cindymill`** | Das Repo wird umgewidmet: Website im Root, Modelldaten im Unterordner `model/`. Sterne, Forks, Issues und die 54 Commits Historie bleiben erhalten. `baseurl` ist `/Cindymill` (Groß-/Kleinschreibung beachten). |
| **Nicht genutzte Assets werden gelöscht** | 346 Dateien / 708 MB entfallen ersatzlos, inkl. **aller Videos**. |
| **Google Analytics wird ersatzlos entfernt** | Keine Cookies, kein Consent-Banner, Analytics-Abschnitt der Datenschutzerklärung entfällt. |

---

## 1. Ist-Zustand

### 1.1 Hosting (Ionos) — wird abgelöst

| Merkmal | Befund |
|---|---|
| Server | Apache, `217.160.0.21` / `2001:8d8:100f:f000::200` |
| Protokoll | nur HTTP/1.1, kein HTTP/2 |
| Letzte Änderung | `Last-Modified: Sun, 09 Oct 2022` — die Seite ist seit ~3,8 Jahren unverändert |
| Kompression | **keine** (kein `Content-Encoding: gzip/br`) |
| Caching | **keine** `Cache-Control`/`Expires`-Header |
| HTTPS | **defekt** — Port 443 offen, aber TLS-Handshake bricht bei SNI ab (`tlsv1 alert internal error`). Dem vHost ist kein Zertifikat zugeordnet. |

Da Webspace und Domain gekündigt werden, ist an keinem dieser Punkte etwas zu reparieren. GitHub Pages liefert HTTP/2, Kompression, Caching und ein Let's-Encrypt-Zertifikat für `*.github.io` ab Werk.

### 1.2 Technologie-Stack

Ausgangslage (vor AP 3) und Stand nach AP 3:

| Komponente | vorher | nachher (AP 3) |
|---|---|---|
| Jekyll | 4.2.1 (Okt 2021) | **4.4.1**, gepinnt auf `~> 4.4` |
| Theme | `jekyll-theme-basically-basic` 1.4.5 — seit ~2019 nicht gepflegt, **lokal nicht installiert** | **vendort im Repo**, kein Gem mehr |
| jekyll-seo-tag | 2.7.1 | 2.9.0 |
| jekyll-sass-converter | 2.1.0 (via `sassc`) — **kritisch**, native Extension, baut auf Ruby 3.4 / arm64 nicht mehr | **3.1.0 via `sass-embedded` 1.102** |
| `Gemfile.lock` | Plattform `x64-mingw32` (Windows) | neu aufgelöst, `arm64-darwin`/`ruby` |
| jekyll-algolia | im Gemfile, ungenutzt (`search: false`) | entfernt |
| `wdm` | Windows-Only | entfernt |
| html-proofer | nicht vorhanden | 5.2.2 in der Test-Gruppe |

Lokal: Ruby 3.4.1, Bundler 2.6.6, `gh` 2.96.0 (seit AP 0 installiert). Der Arbeitsordner ist seit AP 0 ein Klon von `culturalheritagedigital/Cindymill` auf dem Branch `website-migration`.

> ✅ **Der Build läuft seit AP 3.** Vorher fehlte das Theme-Gem lokal und damit `_layouts/` und `_sass/` komplett — im Projekt lagen nur 70 überschriebene `_includes/`. Das Gem wurde einmal von rubygems.org geholt und sofort vendort (AP 3.4); danach besteht keine Abhängigkeit von ihm mehr.

### 1.3 Technische Fehler — verifiziert

#### 🔴 A) Galerie und CAD-Download sind live kaputt (Windows-Backslashes)

**73 Pfade in 3 gebauten Quelldateien** verwenden Windows-Trenner:

| Datei | Backslash-Pfade |
|---|---:|
| `gallery.md` | 68 |
| `files.md` | 3 |
| `community.md` | 2 |

```html
<a href="#"><img src="../assets\images\gallery\frame/frame2.jpg" alt=""></a>
```

Verifiziert:

```
http://cindymill.xyz/assets%5Cimages%5Cgallery%5Cframe/frame2.jpg  → 404
http://cindymill.xyz/assets/images/gallery/frame/frame2.jpg        → 200
```

Betroffen: die **komplette Galerie** sowie der Download `2021_09_22_Cindymill_Complete_Model.zip` auf `files.html`. Schwerwiegendster inhaltlicher Defekt der Seite.

> **Korrektur gegenüber Rev. 1:** Dort war von „171 Pfaden in 4 Dateien" die Rede. 98 davon liegen in `_gallery_fancy.md` — siehe Befund F, diese Datei wird gar nicht gebaut. Live kaputt sind 73 Pfade.

#### 🔴 B) MathJax von einem seit 2017 abgeschalteten CDN

In `_includes/head.html`, dadurch auf **allen 27 Seiten**:

```html
<script async src="http://cdn.mathjax.org/mathjax/latest/MathJax.js?config=TeX-AMS-MML_HTMLorMML">
```

`cdn.mathjax.org` existiert nicht mehr (Abschaltung 2017), zusätzlich `http://` → unter HTTPS Mixed-Content-Blockade. Die Seite enthält keine Formeln: ersatzlos streichen.

#### 🔴 C) `url`/`baseurl` leer → SEO-Metadaten unbrauchbar

`_config.yml` hat `url: ""` und `baseurl: ""`. Folgen im Build:

```html
<link rel="canonical" href="/" />
<meta property="og:url" content="/" />
<meta property="og:image" content="/assets/images/front.jpg" />
```

`sitemap.xml` enthält `<loc>/assembly/…/</loc>` (relativ = ungültig), `robots.txt` verweist auf `Sitemap: /sitemap.xml` (ungültig).

#### 🔴 D) NEU: Absolute Asset-Pfade brechen unter dem `/Cindymill/`-Unterpfad

Weil die Domain entfällt, läuft die Seite unter einem **Projekt-Unterpfad** (`baseurl: "/Cindymill"`). Damit werden alle Pfade der Form `/assets/…` und `../assets/…` ungültig — sie zeigen dann auf `culturalheritagedigital.github.io/assets/…` statt in das Projekt.

Betroffen sind **185 Asset-Referenzen in 23 gebauten Quelldateien**:

| Pfadform | Vorkommen | Problem |
|---|---:|---|
| `assets\…` (Backslash) | 73 | schon heute tot (Befund A) |
| `/assets/…` (absolut) | 106 | bricht unter `baseurl` |
| `../assets/…` (relativ) | 66 | bricht zusätzlich bei `permalink`-Änderungen |

Die drei Kategorien überlappen sich teilweise (`../assets\images\…`). Alle müssen in einem Durchgang auf `relative_url` normalisiert werden — das ist jetzt ein **Blocker**, nicht mehr nur eine Aufräumarbeit. Hinzu kommen 8 Referenzen in `_includes/head.html` und `author.picture`/`logo` in `_config.yml`.

#### 🟠 E) Google Analytics — wird entfernt

- `_includes/head.html` lädt **hart codiert** GA4 `G-6J78SX32JE` — ohne Consent, ohne Opt-out.
- `_config.yml` enthält zusätzlich `google_analytics: G-EFN1CTB4WB`.
- `legal_notice.md` beschreibt **Universal Analytics** mit `_gat._anonymizeIp` und Opt-out-Add-on — beschreibt weder GA4 noch die Realität.

Entscheidung: beides ersatzlos entfernen, Rechtstext entsprechend kürzen (AP 5). ✅ Technik in AP 4 entfernt, Rechtstext in AP 5 gestrichen.

> 🔴 **Korrektur (bei AP 3 belegt): `G-EFN1CTB4WB` ist keine Leiche.** Rev. 4 hielt die ID für nicht ausgeliefert. Das galt nur, weil bisher ohne `JEKYLL_ENV=production` gebaut wurde: `_includes/scripts.html` zieht `google-analytics.html` unter der Bedingung `jekyll.environment == 'production' and site.google_analytics`. Gegengeprüft mit einem Produktionsbuild:
>
> ```
> JEKYLL_ENV=production bundle exec jekyll build
>   → 2× G-6J78SX32JE  (hart codiert in head.html)
>   → 1× G-EFN1CTB4WB  (aus _config.yml via scripts.html)
> ```
>
> Der geplante Actions-Workflow setzt `JEKYLL_ENV=production` (AP 6). Die Seite hätte also **zwei** Analytics-Properties ohne Consent ausgeliefert — mehr als die alte Seite je hatte, ausgelöst durch den Umzug selbst. AP 4 muss deshalb **beide** Stellen entfernen; das Löschen des `head.html`-Snippets allein genügt nicht.

#### 🟠 F) NEU: Zwei tote Quelldateien im Projekt

`_gallery_fancy.md` (16 KB) und `_about_us.md` beginnen mit einem Unterstrich. Jekyll ignoriert solche Dateien im Root — sie erzeugen **keine Seite**, bestätigt gegen `_site/`. Es sind unfertige Entwürfe. Sie sind zu löschen; Assets, die *nur* dort referenziert werden, gelten als verwaist.

#### 🟠 G) Weitere Befunde

- `legal_notice.md`: `href="www.cindymill.xyz"` ohne Schema → wird als relativer Pfad interpretiert, tot. Muss ohnehin auf die neue Adresse. ✅ Link behoben (AP 2), Fließtext in AP 5 (25 Nennungen)
- `assets/stylesheets/main.css.map` (218 KB) öffentlich abrufbar — unnötig. ✅ AP 3 (`sourcemap: never`)
- Ungültiges HTML: `<meta name='ir-site-verification-token' value='276008534' />` — `value` statt `content`. ✅ AP 4
- IE-Altlasten: `<meta http-equiv="X-UA-Compatible">`, „cut the mustard"-Script, `no-js`-Klasse. ✅ alle drei in AP 4 entfernt
- Bilder ohne `loading="lazy"`, ohne `width`/`height` → Layout-Shift und langsames Laden. ✅ AP 4 (`_plugins/image_attributes.rb`)
- Google Fonts (Fira Sans) vom Google-Server → DSGVO-Thema (LG München 2022) und Render-Blocking. ✅ AP 4 (self-hosted)
- Lunr-Suchdateien werden ausgeliefert, obwohl `search: false` — tote Fracht. ✅ AP 3
- `_config.yml` deklariert eine Collection `gallery`, ein Ordner `_gallery/` existiert nicht. ✅ AP 3
- Auskommentierter `<video>`-Block in `gallery.md` (Zeile 591) — bleibt auskommentiert bzw. wird gelöscht (Inhalt wird nicht erweitert). ✅ AP 2 (Block gelöscht)

#### 🟠 H) NEU (bei AP 2 gefunden): Icon-Pfade in `site.webmanifest` und `browserconfig.xml`

Beide Dateien liegen unter `assets/images/favicons/` und enthalten absolute `/assets/…`-Pfade auf die App-Icons. Da sie **kein Front Matter** haben, behandelt Jekyll sie als statische Dateien und kopiert sie unverändert — Liquid wird darin nicht ausgewertet. Unter `/Cindymill/` hätten sie damit auf tote Pfade gezeigt, ohne dass es im HTML sichtbar geworden wäre. Behoben in AP 2.

#### 🟠 I) NEU (bei AP 3 gefunden): `_includes/image-gallery.html` — toter Include mit Fremd-Proxy

Ein lokal hinzugefügter Include (nicht Teil des Themes), der **von keiner Seite eingebunden** wird. Er hätte auch nicht funktioniert: die Bild-URLs laufen über den externen Proxy `images.weserv.nl` mit **fest verdrahteter Fremddomain** `jekyllcodex.org/{{ file.path }}` — also über eine Seite, die die Cindymill-Bilder nie hatte. Gelöscht in AP 3.

#### 🟠 J) NEU (bei AP 3 gefunden): leerer Markdown-Link in `_parts/mechanical_parts.md`

`[Amazon](){:target="_blank"}` in Zeile 179 baute zu `<a href="" target="_blank">` — ein Link auf die Seite selbst. Vorbestehender Inhaltsfehler, der einzige seiner Art im Projekt. Behoben in AP 3 nach der im Dokument selbst etablierten Konvention: fehlt ein Amazon-Link, bleibt die Tabellenzelle leer (so wie in Zeile 182). Es wurde **kein** Link erfunden.

#### 🔴 K) NEU (bei AP 3 gefunden): `.gitignore` hätte 38 Theme-Dateien verschluckt

Der Eintrag `vendor/` aus AP 0 war **nicht verankert**. Git-Ignore-Muster ohne führenden Slash greifen auf *jeder* Ebene — der Eintrag war für Bundlers `vendor/bundle` gedacht, hätte aber auch `_sass/basically-basic/vendor/` erfasst: die 38 Sass-Dateien von **susy** und **breakpoint**, die das vendorte Theme zum Bauen braucht.

Das ist die unangenehmste Fehlerklasse dieses Umzugs: **lokal wäre nichts aufgefallen** (die Dateien liegen ja im Arbeitsordner), erst der CI-Build hätte mit „Can't find stylesheet to import" abgebrochen — nach dem Push, ohne lokal reproduzierbar zu sein. Verifiziert mit `git check-ignore -v`, behoben durch Verankerung auf `/vendor/` und `/.bundle/`. `logs/`, `*.log` und `.htaccess` bleiben **bewusst unverankert**: sie sollen auf jeder Ebene greifen.

#### 🟠 L) NEU (bei AP 4 gefunden): fünf Badges laden von Fremdservern

Nach dem Self-Hosting der Schrift holt der Browser noch **vier Bilder von Fremdservern**, an fünf Stellen eingebunden — die einzigen verbliebenen Drittserver-Requests der Seite:

| Host | Vorkommen | Wo |
|---|---:|---|
| `img.shields.io` (PayPal-Badge) | 2 | `index.html`, `_assembly/z_axis_assembly.md` |
| `licensebuttons.net` (CC-Button) | 1 | `index.html` |
| `i.creativecommons.org` (CC-Button) | 1 | `files.md` |
| `zenodo.org` (DOI-Badge) | 1 | `index.html` |

Es ist dieselbe Fehlerklasse, die AP 4 bei Google Fonts behoben hat: Der Aufruf einer fremden Ressource überträgt die Besucher-IP dorthin. Alle vier sind statische Bilder und ließen sich verlustfrei mit ausliefern (dann bekämen sie auch `width`/`height`, siehe AP 4). **Zugeordnet zu AP 5**, weil es eine Datenschutzentscheidung ist und nicht Aufräumarbeit — außerdem verlieren die Badges dabei ihre (hier ohnehin nie genutzte) Aktualisierbarkeit. Die Links selbst bleiben in jedem Fall unverändert.

> **Korrektur der Tabelle (bei AP 5 gegen den Build geprüft).** Die Spalte „Wo" war in zwei Zeilen falsch: der zweite PayPal-Badge steht nicht in `files.md`, sondern am Ende der Z-Achsen-Montageanleitung; der `licensebuttons.net`-Button steht in `index.html`, nicht in `files.md`. `files.md` bindet den CC-Button von `i.creativecommons.org` ein. Die Gesamtzahl (5 Einbindungen, 4 Hosts) stimmte. Zusätzlich fand sich in `index.html` eine **fünfte, nie gerenderte** `img.shields.io`-URL: die Markdown-Referenzdefinition `[cc-by-nc-sa-shield]` wird von keiner Stelle benutzt und erzeugt daher keinen Request — deshalb tauchte sie in der Build-Zählung nicht auf. In AP 5 gelöscht, sonst bliebe sie als irreführender Treffer bei jeder künftigen Suche nach Fremdhosts stehen. ✅ Befund L insgesamt erledigt in AP 5.

#### 🔴 M) KORREKTUR (bei AP 4 aufgefallen): der AP-3-Bericht hat 4 html-proofer-Fehler übersehen

Der Ergebnisbericht zu AP 3 nennt „HTML-Proofer finished successfully". Beim Nachstellen des Commit-Stands `7efd49f` in einem eigenen Worktree (html-proofer 5.2.2, identische Kommandozeile) meldet derselbe Lauf **4 Fehler**:

```
http://creativecommons.org/licenses/by-nc-sa/4.0/ is not an HTTPS link
  ./_site/files.html:323  (2x)
  ./_site/index.html:301, 303
→ HTML-Proofer found 4 failures!
```

Die vier Links standen schon vor AP 3 im Quelltext (`index.html`, `files.md`) und haben mit AP 2/AP 3 nichts zu tun — `enforce_https` ist in html-proofer 5 standardmäßig aktiv und greift auch unter `--disable-external`. Der AP-3-Bericht war an dieser Stelle also **zu optimistisch**; die dortige Kernaussage („die Seite bricht unter `/Cindymill` nicht") bleibt davon unberührt, denn kein einziger der vier Fehler ist ein Pfad- oder `baseurl`-Fehler.

Behoben in AP 4 durch Umstellung auf `https://` (gleiches Ziel, Creative Commons liefert seit Jahren HTTPS). Lehre für AP 6: Im CI zählt der **Exit-Code**, nicht die letzte Zeile der Ausgabe.

#### 🔴 N) NEU (bei AP 5 gefunden): vier Sketchfab-`<iframe>` — die eigentlichen Drittserver-Aufrufe

Befund L nannte die Badges „die einzigen verbliebenen Drittserver-Requests der Seite". Das war falsch, und zwar systematisch: die Zählung sah nur `<img>`. Vier Seiten binden je ein interaktives 3D-Modell per `<iframe>` von **`sketchfab.com`** ein:

| Seite | Modell |
|---|---|
| `_assembly/frame_assembly.md` | Cindymill Frame |
| `_assembly/portal_assembly.md` | Cindymill Portal |
| `_assembly/z_axis_assembly.md` | Cindymill Z Axis |
| `_parts/mechanical_parts.md` | Cindymill Screws |

Datenschutzrechtlich ist das die **gewichtigere Einbindung**: ein iframe lädt eine komplette Fremdseite mit eigenem JavaScript und eigenen Cookies, nicht bloß ein Bild. Betreiber ist Sketchfab, Inc. (Epic Games, USA) — Drittlandtransfer, ausgelöst beim Seitenaufruf ohne jede Nutzerhandlung.

Anders als die Badges lassen sie sich **nicht lokal ausliefern**: das Modell ist der Inhalt der Seite, kein Dekor. Damit kollidiert der Befund mit der Rahmenbedingung „Inhalt bleibt 1:1 erhalten". Gewählt in AP 5: **Einbindung bleibt, wird aber in der Datenschutzerklärung offengelegt** (neuer Abschnitt 5, inkl. Hinweis, welche vier Seiten betroffen sind und dass die übrigen 23 es nicht sind). Die strengere Variante — Klick-zum-Laden mit Vorschaubild — ist als offene Entscheidung in AP 5 dokumentiert, weil sie das Ladeverhalten der Seite ändert.

Die Zahl aus AP 4 ist damit zu korrigieren: nach AP 5 lädt die Seite **kein einziges Bild** mehr von fremden Servern, aber **vier iframes** von einem.

#### 🟠 O) NEU (bei AP 5 gefunden): drei Fehler im Rechtstext, die nichts mit dem Umzug zu tun haben

1. **Der LinkedIn-Abschnitt beschreibt eine Komponente, die es nicht gibt.** Abschnitt 8 der Datenschutzerklärung erklärte über fünf Absätze das LinkedIn-Plug-in. Im gesamten Projekt gibt es **keine** LinkedIn-Einbindung und nicht einmal einen LinkedIn-Link — die 28 Treffer für „LinkedIn" im Build stammten alle aus diesem Abschnitt selbst. Er stand also da wie die Google-Analytics-Beschreibung: als Textbaustein ohne Bezug zur Seite. Gestrichen.
2. **Die sichtbare E-Mail-Adresse im Impressum stimmte nicht mit dem Link.** `<a href="mailto:cindymill@culturalheritage.digital">info@culturalheritage.digital</a>` — Linkziel und Anzeigetext waren verschiedene Postfächer. Im Impressum ist das keine Kleinigkeit: die Pflichtangabe ist der sichtbare Text. Auf `cindymill@…` vereinheitlicht (das ist das Postfach, das auch Abschnitt 2 nennt).
3. **Vier von acht Seiten mit Affiliate-Links trugen keinen Hinweis** — siehe AP 5.6.

Zum Gegenstück Facebook (in AP 5.6 mitzuprüfen): Es gibt **kein** Facebook-Plug-in. Die Gruppe wird an fünf Stellen als gewöhnlicher Link genannt, das Logo in `community.md` liegt seit AP 2 lokal. Ein Facebook-Abschnitt war in der Erklärung nicht vorhanden und wäre auch nicht nötig — ein Link überträgt nichts, solange er nicht geklickt wird.

#### 🟠 P) NEU (bei AP 5 gefunden): Front Matter `introduction:` war nicht `baseurl`-fest

AP 2 hat 27 Front-Matter-Pfade bewusst nur normalisiert, weil die zuständigen Includes `relative_url` selbst anwenden (`page.image`, `post.image.thumbnail`, …). Für **`introduction:`** gilt das nicht: das Feld enthält freien Markdown-Text mit eigenen Bild-Einbindungen, und `_includes/page-intro.html` gab ihn nur durch `markdownify` — was **kein Liquid auswertet**. Ein `{{ … | relative_url }}` im Front Matter wäre wörtlich im HTML gelandet.

Aufgefallen ist das erst, als die Badges lokal wurden: solange sie absolute Fremd-URLs waren, gab es dort nichts zu präfixen. Eine relative Schreibweise (`assets/…` ohne führenden Slash) wäre auf `index.html` zufällig richtig gewesen, hätte aber `_plugins/image_attributes.rb` die Maße verschluckt — dessen `local_path` löst nur Pfade mit führendem Slash auf. Gelöst in `page-intro.html`, siehe AP 5.

#### 🟢 Q) NEU (bei AP 5 gefunden): relative Pfade im JSON-LD von `jekyll-seo-tag` — folgenlos

Der JSON-LD-Block enthält auf 10 Seiten ein `"thumbnail":"/assets/…"` **ohne** `baseurl`. Quelle ist `jekyll-seo-tag`, das den Front-Matter-Hash `image:` durchreicht; `og:image` und `twitter:image` daneben sind korrekt absolut. Folgenlos, weil `thumbnail` keine gültige schema.org-Eigenschaft für `WebPage` ist (die heißt `thumbnailUrl`) und von Auswertern ignoriert wird. Nicht angefasst: ein `baseurl` im Front Matter würde in `_includes/entry.html` doppelt präfixiert. Hier notiert, damit der Fund nicht ein drittes Mal gemacht werden muss.

**Warum html-proofer das nicht meldet, obwohl es ein `baseurl`-Fehler wäre:** Der Prüfer löst `/assets/…` gegen die Wurzel von `_site/` auf — dort existiert die Datei. Live liegt die Wurzel aber unter `/Cindymill/`. `--swap-urls '^/Cindymill/:/'` normalisiert nur die korrekt präfixierten Pfade und lässt die unpräfixierten stehen, wo sie ebenfalls aufgehen. **Ein vergessener `baseurl` in einem `src` fällt html-proofer damit nicht auf** — das ist die Grenze der Absicherung aus AP 2/3 und der Grund, warum in AP 5 zusätzlich stumpf nach `(src|href)="/assets/` im Build gesucht wurde.

### 1.4 Assets — neu vermessen

Referenzen wurden gegen das **gebaute `_site/`** geprüft (maßgeblich, weil Entwurfsdateien nicht zählen) und Backslash-Pfade normalisiert:

| | Dateien | Größe |
|---|---:|---:|
| Assets gesamt | 513 | **955,6 MB** |
| davon **referenziert** | 167 | **247,8 MB** |
| davon **verwaist** | 346 | **707,7 MB** |

**Videos: 11 Dateien, 196 MB — davon 0 referenziert.** Die einzige Einbindung steht im auskommentierten Block. Da die Seite nicht erweitert wird, werden **alle Videos gelöscht**:

| Typ | Dateien | Größe |
|---|---:|---:|
| `.mov` | 2 | 111 MB (größte: `gallery/milling/milling1.mov`, 94 MB) |
| `.mp4` | 2 | 63 MB |
| `.avi` | 7 | 17 MB (im Browser ohnehin nicht abspielbar) |

**CAD-ZIPs:**

| Datei | Größe | Status |
|---|---:|---|
| `assets/cad/2021_09_22_Cindymill_Complete_Model.zip` | 21,1 MB | referenziert (`files.md`) |
| `assets/cad/Cindymill_Drawings.zip` | 1,0 MB | referenziert (`files.md`) |
| `assets/cad/Cindymill_Plates.zip` | 24 KB | **verwaist** → löschen |

**71 referenzierte Dateien sind größer als 1 MB** (unkomprimierte Handy-Originale, größte 5,8 MB), zusammen 231 MB.

**GitHub-Pages-Limits nach der Diät:**

| Limit | Wert | Prognose |
|---|---|---|
| Größe der veröffentlichten Site | 1 GB (hart) | ~50 MB — unkritisch |
| Einzeldatei | 100 MB (hart), Warnung ab 50 MB | max. 21 MB (CAD-ZIP) — unkritisch |
| Bandbreite | 100 GB/Monat (weich) | unkritisch |
| Builds | 10/Stunde (weich) | unkritisch |

### 1.5 Was nicht ins Repository gehört

Diese Dateien liegen jetzt **nur noch im Backup** (`2026_Backup_Website_Cindymill_Ionos/logs/`, 1,6 MB) und dürfen nie ins Repo:

- `logs/access.log.*` — Rohlogs mit **Besucher-IP-Adressen** (personenbezogene Daten)
- `logs/.htaccess` — enthält einen Ionos-Serverpfad zur `htpasswd` samt Kundennummer und den Systembenutzernamen des Webspace (hier bewusst nicht zitiert, da dieses Dokument im öffentlichen Repository liegt; Original im Backup)
- `logs/info.php5`, `logs/info.pl`, `logs/info.py`, `logs/traffic.db`, `logs/sftp.log`

Im Arbeitsordner sind sie bereits nicht mehr vorhanden — beim Anlegen des Repos ist das zu verifizieren, nicht zu unterstellen. Ebenfalls draußen bleiben: `_site/`, `.DS_Store`, `jekyll-theme-basically-basic.gemspec` (Theme-Artefakt).

---

## 2. Zielarchitektur

```
culturalheritagedigital/Cindymill (public)  ──►  GitHub Actions (Jekyll 4.4)  ──►  GitHub Pages
        │                                                                             │
   Root:   Jekyll-Quellcode                        culturalheritagedigital.github.io/Cindymill/
           + vendortes Theme                       HTTPS automatisch (*.github.io-Wildcard)
           + optimierte assets/ (inkl. fonts/,      kein DNS, keine Domain, kein Zertifikatsthema
             badges/)
           + _plugins/ (Bildmasse, nur mit Actions)
           + .github/workflows/
   model/: CAD-/Modelldaten (per exclude: nicht Teil des Builds)
   Root:   README.md, LICENSE, cindymill_front_1.jpg (ebenfalls excluded)
```

**Warum GitHub Actions und nicht der klassische Pages-Jekyll-Build?**
`jekyll-theme-basically-basic` steht **nicht** auf GitHubs Liste unterstützter Themes, und die Pages-Build-Umgebung ist auf Jekyll 3.9 festgenagelt. Mit einem Actions-Workflow läuft aktuelles Jekyll 4.4 mit beliebigen Gems. Seit AP 4 kommt ein zweiter, härterer Grund hinzu: Der klassische Pages-Build ignoriert `_plugins/` und würde die Bildmaße stillschweigend weglassen.

**Kosten:** GitHub Pages ist für **öffentliche** Repositories kostenlos. Pages aus einem *privaten* Repo erfordert GitHub Pro/Team — das Repo muss also public sein. Bei einem CC-BY-NC-SA-Projekt ohnehin stimmig. **Laufende Kosten nach dem Umzug: 0 €** (Ionos-Webspace und Domain gekündigt).

**Repo-Name = sichtbare URL.** Ohne eigene Domain wird der Repository-Name Teil der Adresse. Entschieden: **das bestehende `culturalheritagedigital/Cindymill` wird umgewidmet** → `https://culturalheritagedigital.github.io/Cindymill/`.

Das hat drei Konsequenzen, die im weiteren Plan berücksichtigt sind:

1. **`baseurl: "/Cindymill"`** — mit großem C. GitHub Pages bildet den Repo-Namen unverändert auf den Pfad ab; ein kleingeschriebenes `/cindymill` liefert 404.
2. **Die Modelldaten liegen jetzt unter `model/`.** Bestehende Links auf CAD-Dateien (Forks, Foren, das alte README) zeigen ins Leere und müssen umgebogen werden, soweit sie in eigener Hand sind. Die 14 Forks behalten die alte Struktur — das ist unvermeidbar.
3. **Der Repo-Root ist die Jekyll-Wurzel.** Alles, was nicht zur Website gehört (`model/`, `README.md`, `LICENSE`, `cindymill_front_1.jpg`, die Projektdoku), muss in `_config.yml` unter `exclude:` stehen, sonst landet es im Build und im Pages-Deployment. Ausgenommen sind Namen, die mit `.` beginnen: `.github/` überspringt Jekyll von sich aus — in AP 6 gegen den Build geprüft, nicht unterstellt.

---

## 3. Arbeitspakete

### AP 0 — Repository vorbereiten ✅ weitgehend erledigt (29.07.2026)

| # | Schritt | Status |
|---|---|---|
| 1 | Vollbackup des Ionos-Webspace | ✅ `2026_Backup_Website_Cindymill_Ionos` (995 MB) |
| 2 | Arbeitsordner auf Server-Artefakte prüfen | ✅ `logs/`, `.htaccess`, Rohlogs, `info.php5` etc. **nicht vorhanden**; 4× `.DS_Store` gelöscht |
| 3 | `.gitignore` anlegen | ✅ inkl. `logs/`, `*.log`, `.htaccess`, `_site/`, `.DS_Store`, `vendor/`, `.bundle/` |
| 4 | Bestehendes Repo anbinden statt neu initialisieren | ✅ `origin` = `culturalheritagedigital/Cindymill`, 54 Commits geholt (`.git` nur 11 MB) |
| 5 | Arbeitsbranch `website-migration` | ✅ angelegt — `main` bleibt bis zum Livegang unangetastet |
| 6 | Modelldaten nach `model/` verschieben | ✅ Commit `178fca3`, 81 Dateien, von Git als reine Renames erkannt (0 Insertions/Deletions) → Historie bleibt nachvollziehbar |
| 7 | Website-Quellcode aufnehmen | ✅ Commit `74e6bbf`, 116 Dateien, **ohne `assets/`** |
| 8 | `exclude:` in `_config.yml` setzen | ✅ `model/`, `README.md`, `LICENSE`, `cindymill_front_1.jpg`, Projektdoku + Jekyll-Standardliste |
| 9 | GitHub CLI installieren | ✅ `gh` 2.96.0 via Homebrew |
| 10 | `gh auth login` | ✅ 30.07.2026 — Konto `culturalheritagedigital`, Scopes `repo`, `workflow`, `read:org`, `gist` |
| 11 | Ionos-Vertragsdaten sichern | ⬜ **offen** — Paket, Domain-Auth-Code, Kündigungsfristen, Rechnungen ins Backup. Nach der Kündigung ist der Zugang weg. |

**Wichtige Abweichung von Rev. 2:** Dort war ein frisches `git init` vorgesehen. Da die Website in das *bestehende* Repo zieht, wäre das falsch gewesen — es hätte die 54 Commits, die Sterne und die Forks verworfen. Stattdessen wurde das vorhandene Repo als `origin` angebunden und die Historie fortgeschrieben.

**`assets/` fehlt bewusst im Commit.** Erst AP 1 ausführen, dann `git add assets/`. Andernfalls lägen die 708 MB verworfener Dateien dauerhaft in der Historie und jeder Clone — auch jeder der 14 Forks — zöge sie mit. Der Rollback-Punkt ist das Backup, nicht ein Initial-Commit.

~~**Noch nicht gepusht.**~~ ✅ **Gepusht am 30.07.2026**, nach AP 6 und damit lange nach AP 1 — die Bedingung „erst wenn AP 1 durch ist" war eingehalten, ein Zwischenstand mit halb aufgeräumten Assets war nie öffentlich. Der Push ist der erste nach außen sichtbare Schritt; die dafür verlangte Kontrolle auf personenbezogene Daten steht im Nachtrag zu AP 6. `main` bleibt bis AP 7.1 unangetastet.

### AP 1 — Asset-Diät (Blocker, vor dem Commit von `assets/`)

Ziel: von 955,6 MB auf **< 50 MB**.

1. **Tote Quelldateien löschen:** `_gallery_fancy.md`, `_about_us.md` (Befund F) — sonst zählt die Referenzprüfung 98 Backslash-Pfade fälschlich als „in Benutzung".
2. **Verwaiste Assets entfernen** (346 Dateien, 707,7 MB). Das Prüfskript muss Backslash-Pfade normalisieren und URL-dekodieren, sonst wird die halbe Galerie fälschlich als verwaist erkannt. Referenzen gegen das gebaute `_site/` prüfen, nicht gegen die Quelldateien.
3. **Alle Videos löschen** (11 Dateien, 196 MB) — 0 davon sind eingebunden, die Seite wird nicht erweitert. Die Originale bleiben im Backup.
4. **`Cindymill_Plates.zip`** löschen (verwaist).
5. **Bilder optimieren** (71 referenzierte Dateien > 1 MB, 231 MB):
   - Längste Kante auf max. 1600 px (Galerie) bzw. 2000 px (Detailfotos) begrenzen.
   - JPEG mit Qualität ~82 neu kodieren, EXIF strippen.
   - Erwartetes Ergebnis: 226 MB Bilder → **ca. 25–35 MB**.
   - WebP zusätzlich erzeugen und via `<picture>` ausliefern: **optional** — bringt weitere ~30 %, kostet aber Umbauten in allen Galerie-Templates. Bei „Inhalt bleibt wie er ist" vertretbar, aber nicht zwingend.
6. **CAD-ZIPs (22 MB) bleiben im Repo** — bei 1 GB Pages-Limit unkritisch, und der Download-Link bleibt stabil. Alternative bei künftigem Wachstum: als GitHub **Release-Assets** ablegen (zählen nicht gegen das Pages-Limit).
7. `main.css.map` nicht mehr ausliefern; Lunr-Dateien entfallen mit dem Vendoring (AP 3).
   ✅ Beides in AP 3 erledigt: `sass: sourcemap: never` in `_config.yml`, und die 21 Lunr-JS-Dateien wurden beim Vendoring gar nicht erst mitkopiert.

**Ergebnis AP 1 (29.07.2026):** `assets/` von 913 MB auf **62 MB**, 172 Dateien — davon 41 MB Bilder und 21 MB CAD-ZIPs. Commit `72ee937`.

> Stand nach AP 5: **63 MB, 187 Dateien**. Hinzugekommen sind die 8 WOFF2 der Schrift samt Lizenztext (AP 4, 228 KB) und die 3 Badges samt Herkunftsnotiz (AP 5, 5 KB). Das gebaute `_site/` ist 64 MB groß — weit unter dem 1-GB-Limit.

Das Ziel „< 50 MB" ist damit knapp verfehlt, dominiert vom 20-MB-CAD-ZIP. Bei 1 GB Pages-Limit ist das folgenlos; zwei Hebel bleiben, falls es doch stören sollte:

- `2021_09_22_Cindymill_Complete_Model.zip` als **GitHub-Release-Asset** ablegen → Site fällt auf 41 MB (Release-Assets zählen nicht gegen das Pages-Limit).
- Die fünf PNG-Renderings (`rend5`–`rend11`, zusammen ~6 MB) mit `pngquant` verlustbehaftet quantisieren → ca. 4 MB weniger.

### AP 2 — Asset-Pfade reparieren und `baseurl`-fest machen ✅ ausgeführt (29.07.2026)

Alle 185 Asset-Referenzen in einem automatisierten Durchgang normalisieren (Befunde A und D):

1. Alle `\` in Asset-Pfaden durch `/` ersetzen (73 live betroffene Vorkommen in `gallery.md`, `files.md`, `community.md`).
2. Alle absoluten (`/assets/…`, 106×) und relativen (`../assets/…`, 66×) Pfade auf Jekyll-Filter umstellen — **zwingend**, weil die Seite unter `/Cindymill/` läuft:
   ```liquid
   {{ '/assets/images/gallery/frame/frame2.jpg' | relative_url }}
   ```
   In Markdown funktioniert das auch in der Bild-Kurzschreibweise:
   ```markdown
   ![limit]({{ '/assets/images/addons/limitswitches/limitswitch1.jpg' | relative_url }})
   ```
3. Gleiches für `_includes/head.html` (8 Referenzen) sowie `author.picture` und `logo` in `_config.yml`.
4. Alle internen Seitenlinks (`href="/gallery.html"` o. ä.) ebenfalls auf `relative_url` prüfen — sie brechen unter `baseurl` genauso.
5. `legal_notice.md`: `href="www.cindymill.xyz"` → neue Adresse (AP 5).
6. **Zwei vorbestehende tote Links in `gallery.md` beheben** (bei der Prüfung in AP 1 gefunden): `assets/images/gallery/milling1.mp4` und `assets/images/gallery/stuff1.jpg` existieren weder im Projekt noch im Ionos-Backup — sie waren schon live kaputt. Entweder Referenz entfernen oder auf eine vorhandene Datei zeigen lassen.
7. Nach dem Build mit **html-proofer** verifizieren: 0 gebrochene interne Links.

> Der letzte Punkt ist der eigentliche Test dieses Arbeitspakets. Ohne ihn merkt man den `baseurl`-Bruch erst live.

#### Ergebnis AP 2 (29.07.2026) — Commit `dc92a38`

23 Dateien geändert, **199 Asset-Referenzen** plus **17 interne Seitenlinks** normalisiert.

| Kategorie | Anzahl | Behandlung |
|---|---:|---|
| Body-Asset-Referenzen (`.md`/`.html`) | 172 | → `{{ '/assets/…' \| relative_url }}` |
| davon vorher mit Windows-Backslash | 75 | zusätzlich `\` → `/` |
| Front-Matter-Pfade (`image`, `path`, `thumbnail`) | 27 | nur normalisiert (führender `/`), **kein** Liquid |
| Interne Seitenlinks | 17 | → `{{ '/parts/' \| relative_url }}` usw. |
| Favicon-Referenzen in `_includes/head.html` | 7 | → `relative_url` |
| Referenzen in `site.webmanifest` / `browserconfig.xml` | 3 | Front Matter ergänzt + `relative_url` (neuer Befund H) |

**Warum Front Matter anders behandelt wird.** Jekyll wertet in Front Matter kein Liquid aus — `image: "{{ … | relative_url }}"` wäre wirkungslos. Die maßgeblichen Includes liegen bereits lokal im Projekt und wenden den Filter selbst an:

| Include | Zeile |
|---|---|
| `_includes/page-intro.html` | `page.image.path \| default: page.image \| relative_url` |
| `_includes/entry.html` | `post.image.thumbnail \| relative_url` |
| `_includes/author` | `author_picture \| relative_url` |
| `_includes/masthead.html` | `site.logo \| relative_url` |

Damit sind auch **`author.picture` und `logo` in `_config.yml` bereits `baseurl`-fest** — Punkt 3 der Liste oben erledigt sich dort ohne Änderung. `_includes/navigation.html` und `masthead.html` waren schon korrekt.

**Neuer Befund H: `site.webmanifest` und `browserconfig.xml` waren ebenfalls betroffen.** Beide Dateien enthalten absolute `/assets/…`-Pfade auf Icons und wurden als statische Dateien unverändert kopiert. Ohne Front Matter rendert Jekyll darin kein Liquid; sie hätten unter `/Cindymill/` auf tote Icon-Pfade gezeigt. Lösung: leeres Front Matter (`---` / `---`) vorangestellt, damit Jekyll sie rendert, und die drei Pfade auf `relative_url` umgestellt.

**Interne Seitenlinks auf die tatsächlich gebauten URLs gezogen.** Die 17 Links waren nicht nur `baseurl`-unfest, sondern teilweise auch formal ungenau (`/parts` statt `/parts/`, `/gallery` statt `/gallery.html`). Unter Apache mit MultiViews fiel das nicht auf; GitHub Pages ist toleranter als html-proofer. Die Ziele sind jetzt gegen das gebaute `_site/` abgeglichen:

`/parts/`, `/assembly/`, `/assembly/{portal,z_axis,electronics}_assembly/`, `/parts/electronic_parts/`, `/gallery.html`, `/accessories.html`, `/start/2021/07/24/Rigidity.html`, `/start/2021/08/01/SpeedsAndFeeds.html`

**Punkt 6 (zwei tote Links) erledigt — Präzisierung.** Beide lagen in **auskommentierten** Blöcken, waren also nie live sichtbar. Die Blöcke wurden gelöscht statt umgebogen (Inhalt wird nicht erweitert):

- `<video>`-Block mit `assets/images/gallery/milling1.mp4` (zugleich der auskommentierte Video-Block aus Befund G)
- `<figure>`-Block mit `assets/images/gallery/stuff1.jpg`

**Punkt 5 (`legal_notice.md`) teilweise erledigt.** Der schemalose und damit tote Link `href="www.cindymill.xyz"` zeigt jetzt auf `https://culturalheritagedigital.github.io/Cindymill/`. Die restlichen ~20 Nennungen von `cindymill.xyz` stehen im Fließtext der Datenschutzerklärung und gehören zur Textüberarbeitung in **AP 5**.

**Verifikation.** Statisch gegen die Dateisystem-Wirklichkeit geprüft (Skript löst jede Referenz auf, URL-dekodiert):

```
221 Ziele aufgelöst, 2 fehlend
  /assets/stylesheets/main.css   (_includes/head.html)
  /assets/javascripts/main.js    (_includes/scripts.html)
```

Beide fehlenden Dateien sind **erwartet**: sie werden aus den Sass-/JS-Quellen des Theme-Gems erzeugt und kommen mit dem Vendoring in **AP 3.4** ins Projekt. Ansonsten: 0 Backslash-Pfade, 0 rohe `/assets/`- oder `../assets/`-Pfade im Body, 0 rohe interne Links.

> ✅ **Punkt 7 (html-proofer) ist mit AP 3 nachgeholt.** Der Lauf war blockiert, weil der Build nicht lief (Theme-Gem fehlte, `sassc` brach auf Ruby 3.4). Ergebnis nach AP 3: **0 Fehler, auch unter `--baseurl /Cindymill`** — die einzige Meldung war ein leerer Markdown-Link, der nicht aus AP 2 stammte (Befund J). Details im Ergebnisbericht zu AP 3. Dauerhaft im CI: AP 6.

**Offener Nebenbefund aus der Prüfung.** `assets/images/gallery/frame/plates2.jpg` und `frame3.jpg` existieren noch, werden aber nur in zwei auskommentierten `<figure>`-Blöcken in `gallery.md` referenziert. Die Referenzprüfung in AP 1 hat Kommentare nicht ausgewertet, deshalb sind sie der Asset-Diät entgangen. Folgenlos (zusammen < 1 MB), gehört aber sauber gelöscht, falls AP 1 noch einmal angefasst wird.

### AP 3 — Toolchain aktualisieren ✅ ausgeführt (30.07.2026)

1. `Gemfile.lock` löschen und neu auflösen (die alte Datei ist Windows-spezifisch, `x64-mingw32`).
2. `Gemfile`:
   - Jekyll explizit auf `~> 4.4` pinnen.
   - `jekyll-sass-converter` auf `~> 3.0` heben → nutzt `sass-embedded` statt des kaputten `sassc`. **Voraussetzung dafür, dass der Build auf Ruby 3.4/arm64 überhaupt läuft.**
   - `jekyll-algolia` entfernen (ungenutzt).
   - `wdm` (Windows) entfernen.
   - `jekyll-paginate` beibehalten — die Blog-Paginierung bleibt wie sie ist.
   - `webrick` behalten (für `jekyll serve` unter Ruby ≥ 3).
   - `html-proofer` in einer Test-Gruppe ergänzen.
3. `.ruby-version` auf `3.4` festlegen, damit lokaler Build und CI identisch sind.
4. **Theme vendorn.** `jekyll-theme-basically-basic` 1.4.5 ist unmaintained und lokal nicht installiert; `_layouts/` und `_sass/` fehlen im Projekt völlig.
   - `bundle install` einmal laufen lassen, um das Gem von rubygems.org zu holen.
   - `_layouts/`, `_sass/` und die fehlenden `_includes/` aus dem Gem ins Repo kopieren (70 Includes sind bereits lokal überschrieben).
   - `theme:`-Zeile aus `_config.yml` und das Gem aus dem `Gemfile` entfernen.
   - Lunr-Suchdateien und Algolia-Includes beim Kopieren weglassen (`search: false`).
   - Danach gibt es keine Abhängigkeit von einem toten Gem mehr, und AP 4 ist direkt umsetzbar.
5. `jekyll-theme-basically-basic.gemspec` aus dem Projektroot löschen (Theme-Artefakt).
6. Leere Collection `gallery` aus `_config.yml` entfernen (kein `_gallery/`-Ordner vorhanden). Beim selben Durchgang den auskommentierten Algolia-Block entfernen — er enthält einen `search_only_api_key` im Klartext. Der Schlüssel ist zwar nur lesend und war ohnehin schon öffentlich, gehört aber nicht in ein Repo; bei der Gelegenheit im Algolia-Konto widerrufen.
7. Erster Testlauf: `bundle install && bundle exec jekyll build` — Fehler der Anhebung 4.2 → 4.4 abarbeiten (v. a. Sass-Deprecations; `liquid: error_mode: strict` greift strenger).

#### Ergebnis AP 3 (30.07.2026) — Commit `e4f591e`

106 Dateien, +7292/−334. **Der Build läuft — erstmals seit dem Umzug in den Arbeitsordner — lokal durch, in 0,22 s.**

| # | Schritt | Ergebnis |
|---|---|---|
| 1 | `Gemfile.lock` neu auflösen | ✅ gelöscht, neu aufgelöst: 61 Gems, Plattformen `ruby`/`arm64-darwin` statt `x64-mingw32` |
| 2 | `Gemfile` neu fassen | ✅ Jekyll `~> 4.4` (→ 4.4.1), `jekyll-sass-converter ~> 3.0` (→ 3.1.0), `jekyll-algolia` und `wdm` raus, `webrick ~> 1.8`, `jekyll-paginate` bleibt, `html-proofer ~> 5.0` in `group :test` |
| 3 | `.ruby-version` | ✅ `3.4` — und in `exclude:` nachgezogen |
| 4 | Theme vendorn | ✅ siehe unten |
| 5 | `…gemspec` löschen | ✅ gelöscht, Eintrag aus `exclude:` entfernt |
| 6 | Collection `gallery` + Algolia-Block | ✅ beide raus, dazu die drei `search*`-Schlüssel und der `_gallery`-Front-Matter-Default |
| 7 | Erster Testbuild | ✅ 27 Seiten, `main.css` (53 KB) wird erzeugt, `model/` sauber ausgeschlossen |

**Vendoring (3.4) — die `_includes/` waren schon vollständig.** Erwartet waren „70 überschriebene Includes, Rest fehlt". Tatsächlich lagen **alle** 70 Gem-Includes bereits lokal (Abgleich mit `comm`), plus zwei lokale Extras. Zu kopieren waren daher nur:

| Kopiert aus dem Gem | Umfang |
|---|---:|
| `_layouts/` | 12 Dateien |
| `_sass/` | 81 Dateien (davon 38 in `vendor/`: susy + breakpoint) |
| `assets/stylesheets/main.scss` | 1 |
| `assets/javascripts/main.js` | 1 |
| `assets/javascripts/lunr/` | **nicht kopiert** (21 Dateien, `search: false`) |

Die MIT-Lizenz des Themes liegt als `_sass/basically-basic/THEME-LICENSE.txt` bei — im Repo, aber außerhalb des Builds, da Jekyll `_sass/` nicht ausliefert. Der Urheberhinweis auf Michael Rose steht unverändert im Kopf von `_layouts/default.html`.

**Suche restlos entfernt.** `search: false` galt schon vorher, die Fracht lag aber noch da — `_includes/search-form.html` wurde von `default.html` sogar **ungated** eingebunden, rendert also auf jeder Seite einen leeren `<div class="search-content">`. Entfernt: `_includes/search/` (Lunr + Algolia), `search-form.html`, `_sass/basically-basic/_search.scss` samt `@import`, die Such-Blöcke in `_layouts/default.html` (Toggle-Button und `search-content`-Div) und in `_includes/scripts.html`.

**Der Algolia-API-Key ist aus `_config.yml` verschwunden** (`search_only_api_key: 9d5014e5bbc77372547bce778dfa5663`, auskommentiert). ⚠️ Er steht weiterhin in der **Git-Historie** und war ohnehin öffentlich — **im Algolia-Konto widerrufen** bleibt offen, siehe Checkliste.

**Sass-Deprecations: 231 → 2.** Der Umstieg auf `sass-embedded` bringt Dart Sass 1.102 mit, das die Altlasten des Themes anmeckert — `@import`, `$a / $b`, `lighten()`, globale Builtins, `if()`, unäre Operatoren. Es sind **Warnungen, keine Fehler**; sie kündigen den Bruch in Dart Sass 3.0 an. Sie alle zu beheben hieße, 38 Dateien fremden Vendor-Codes (susy, breakpoint) zu migrieren — hoher Aufwand, hohes Regressionsrisiko, kein sichtbarer Nutzen, und in einem „rein technischen Umzug" nicht vorgesehen. Gewählt:

```yaml
sass:
  sourcemap: never    # keine oeffentliche main.css.map (erledigt AP 1.7)
  quiet_deps: true    # Deprecations des vendorten Themes stumm
```

`quiet_deps` schweigt nur über Dateien, die *nicht* der Einstiegspunkt sind — die zwei verbleibenden Warnungen stammen aus `assets/stylesheets/main.scss` selbst und bleiben als Erinnerung sichtbar. Der Bruch kann nicht unbemerkt einziehen: `jekyll-sass-converter ~> 3.0` verlangt `sass-embedded ~> 1.75`, also `< 2.0`. Ein zusätzlicher Pin wäre Redundanz.

**`sourcemap: never` erledigt AP 1.7** — `main.css.map` (bisher 218 KB öffentlich abrufbar) wird nicht mehr erzeugt.

**Verifikation — html-proofer, zweimal.** Damit ist der bis hierher aufgeschobene Punkt **AP 2.7** eingelöst:

```
bundle exec jekyll build                      → 27 Seiten
bundle exec htmlproofer ./_site --disable-external
  → 3 Checks (Images, Links, Scripts), 27 Dateien, 44 interne Links
  → HTML-Proofer finished successfully

bundle exec jekyll build --baseurl /Cindymill
bundle exec htmlproofer ./_site --disable-external --swap-urls '^/Cindymill/:/'
  → HTML-Proofer finished successfully
```

Der **zweite Lauf ist der wichtige**: er beweist, dass AP 2 gehalten hat und die Seite unter dem Projekt-Unterpfad nicht bricht — der Befund D war als Blocker eingestuft. Stichprobe aus dem `baseurl`-Build: `href="/Cindymill/assets/stylesheets/main.css"`, `src="/Cindymill/assets/images/gallery/frame_bw.jpg"`.

> ⚠️ **Zur Aussagekraft:** html-proofer meldet die Bildprüfung nur im Fehlerfall, die Zeile „44 interne Links" zählt allein `<a>`-Ziele. Dass die **181 `<img>`** im Build wirklich geprüft werden, wurde eigens gegengetestet (Fixture mit kaputtem `src` → „internal image does not exist"). Ohne diesen Test wäre „0 Fehler" eine Scheinsicherheit gewesen.

**Zwei Funde nebenbei:** der tote Include `image-gallery.html` (Befund I) und der leere Markdown-Link in `_parts/mechanical_parts.md` (Befund J) — letzterer war die einzige echte html-proofer-Meldung überhaupt. Und ein Fund, der ohne Prüfung erst im CI aufgeschlagen wäre: die **`.gitignore`-Falle** (Befund K) — `vendor/` unverankert hätte 38 der gerade vendorten Theme-Dateien aus dem Commit gehalten.

**Offen aus AP 3:** nichts. ✅ Die hier noch aufgeführten Reste — GA4-Block und MathJax in `_includes/head.html`, `google_analytics: G-EFN1CTB4WB` in `_config.yml`, die Google-Fonts-Einbindung über `_data/theme.yml` — sind mit **AP 4** erledigt.

> 🔴 **Korrektur zum html-proofer-Ergebnis dieses Arbeitspakets:** Die Läufe oben meldeten „finished successfully", tatsächlich fand html-proofer schon damals **4 Fehler**. Nachgestellt in AP 4 am Commit-Stand `7efd49f`. Siehe **Befund M**. Die Aussage, dass die Seite unter `/Cindymill` nicht bricht, bleibt gültig — keiner der vier Fehler ist ein Pfadfehler.

### AP 4 — `_config.yml` und `head.html` modernisieren ✅ ausgeführt (30.07.2026)

**`_config.yml`:**
```yaml
url: "https://culturalheritagedigital.github.io"
baseurl: "/Cindymill"      # großes C – GitHub Pages bildet den Repo-Namen
                           # unverändert ab, /cindymill liefert 404
google_analytics:          # entfernt, s. AP 5
```
Die `exclude:`-Liste steht bereits (AP 0.8). Sie ist bei jedem neuen Root-Element im Repo nachzuziehen — Jekyll kopiert sonst alles Unbekannte ins `_site/`.
Damit werden `canonical`, `og:url`, `og:image`, `sitemap.xml` und `robots.txt` erstmals korrekt absolut.

> **`permalink` bleibt unverändert.** Rev. 1 schlug `permalink: pretty` vor, um die Extensionless-URLs des Apache nachzubilden. Mit der Aufgabe der Domain gibt es keine URLs mehr zu erhalten — jede Änderung wäre reines Risiko ohne Nutzen. `jekyll-redirect-from` entfällt damit ebenfalls.

**`_includes/head.html`:**
- MathJax-Block **ersatzlos löschen** (totes CDN, Mixed Content).
- GA4-Snippet `G-6J78SX32JE` **ersatzlos löschen** — und zusätzlich `google_analytics` aus `_config.yml`, sonst liefert der Produktionsbuild über `_includes/scripts.html` → `google-analytics.html` weiter `G-EFN1CTB4WB` aus (siehe Korrektur zu Befund E). Danach ist `_includes/google-analytics.html` toter Code und kann mit weg.
- `<meta http-equiv="X-UA-Compatible">` löschen.
- „Cut the mustard"-Script löschen.
- eBay-Verifizierungs-Tag: `value=` → `content=` korrigieren, oder löschen, falls das Partnerprogramm nicht mehr aktiv ist.
- Google Fonts **self-hosten**: Fira Sans als WOFF2 in `assets/fonts/`, `@font-face` mit `font-display: swap`. Löst DSGVO-Thema und Render-Blocker zugleich.
- `<link rel="preload">` für die Hauptschrift, `rel="preconnect"` zu Google entfernen.
- ~~Die 8 Asset-Referenzen auf `relative_url` umstellen (AP 2.3).~~ ✅ in AP 2 erledigt (7 Favicon-Pfade; `main.css` war bereits korrekt).

**Templates/Layouts (nach dem Vendoring):**
- Bilder: `loading="lazy"` und `decoding="async"` ergänzen (Hero-Bild stattdessen `fetchpriority="high"`).
- `width`/`height` an allen `<img>` setzen (verhindert Layout-Shift).
- Nur falls WebP in AP 1.5 gewählt wurde: Galerie auf `<picture>` mit JPEG-Fallback umstellen.

#### Ergebnis AP 4 (30.07.2026) — Commit `4ec0436`

21 Dateien, +447/−57. Build und html-proofer laufen weiter durch, auch als Produktionsbuild.

| # | Schritt | Ergebnis |
|---|---|---|
| 1 | `url` + `baseurl` | ✅ `https://culturalheritagedigital.github.io` + `/Cindymill` |
| 2 | `google_analytics` aus `_config.yml` | ✅ entfernt, dazu der Produktions-Block in `_includes/scripts.html` und die Datei `_includes/google-analytics.html` |
| 3 | MathJax-Block | ✅ ersatzlos gelöscht (beide `<script>`-Tags samt Konfiguration) |
| 4 | GA4-Snippet `G-6J78SX32JE` | ✅ ersatzlos gelöscht |
| 5 | `X-UA-Compatible` | ✅ gelöscht |
| 6 | „Cut the mustard" | ✅ gelöscht, dazu `class="no-js"` in `_layouts/default.html` |
| 7 | eBay-Verifizierung | ✅ `value=` → `content=` |
| 8 | Google Fonts | ✅ self-hosted, 8 WOFF2 in `assets/fonts/` (228 KB) |
| 9 | `rel="preload"` / kein `preconnect` | ✅ Regular-Schnitt vorgeladen; ein `preconnect` gab es nie |
| 10 | Bild-Attribute in den Templates | ✅ per Plugin, siehe unten |
| 11 | WebP / `<picture>` | ⬜ **entfällt** — WebP wurde in AP 1.5 nicht gewählt, es liegt keine einzige `.webp`-Datei im Projekt |

**Die SEO-Metadaten sind erstmals gültig** (Befund C erledigt). Aus dem Build:

```
<link rel="canonical" href="https://culturalheritagedigital.github.io/Cindymill/" />
og:url    → https://culturalheritagedigital.github.io/Cindymill/
og:image  → https://culturalheritagedigital.github.io/Cindymill/assets/images/front.jpg
sitemap   → <loc>https://culturalheritagedigital.github.io/Cindymill/assembly/…/</loc>
robots    → Sitemap: https://culturalheritagedigital.github.io/Cindymill/sitemap.xml
atom.xml  → self-Link und Einträge absolut
```

Damit ist `baseurl` jetzt **dauerhaft in `_config.yml`** gesetzt und nicht mehr nur ein `--baseurl`-Schalter beim Testen. Folge für alle künftigen Prüfläufe: html-proofer braucht immer `--swap-urls '^/Cindymill/:/'`, sonst hält es jeden korrekten Pfad für einen Fehler.

**Analytics gegengeprüft — diesmal im Produktionsmodus.** Genau der Lauf, der in AP 3 die zweite ID zutage brachte, ist jetzt leer:

```
JEKYLL_ENV=production bundle exec jekyll build
  → 0x G-6J78SX32JE, 0x G-EFN1CTB4WB, 0x googletagmanager, 0x google-analytics
```

**Schrift: Fira Sans liegt im Repo.** Die Einbindung über `fonts.googleapis.com` ist ersetzt durch `@font-face` in `_sass/cindymill/_fonts.scss` (neu, außerhalb des vendorten Themes):

| Entscheidung | Begründung |
|---|---|
| 4 Schnitte × 2 Subsets = 8 Dateien | 400/400i/600/600i sind genau die Schnitte, die `_data/theme.yml` bisher bestellt hat — `$base-font-family` im Theme ist unverändert `"Fira Sans", sans-serif` |
| `latin` **und** `latin-ext` | `unicode-range` trennt beide: `latin-ext` (134 KB) wird nur geladen, wenn ein Zeichen daraus vorkommt — im Repo kostet es Platz, beim Besucher nichts |
| `font-display: swap` | Text ist sofort in der Systemschrift lesbar statt bis zu 3 s unsichtbar |
| Pfade als `url('../fonts/…')` | relativ zum Ausgabeort von `main.css`, also **ohne** Liquid `baseurl`-fest — in Sass-Partials wird Liquid nicht ausgewertet |
| `@use` statt `@import` für das neue Partial | hält die Deprecation-Liste bei 2 (siehe AP 3); die Zahl bleibt damit ein Maß für Theme-Altlasten, nicht für eigenen Code |
| `assets/fonts/Fira_Sans-OFL.txt` liegt bei | Die SIL Open Font License 1.1 verlangt, dass der Lizenztext mitausgeliefert wird |

Vorgeladen wird nur `fira-sans-normal-400-latin.woff2` — der Fließtextschnitt. Ein `preconnect` zu Google musste nicht entfernt werden: es war nie eines gesetzt.

**Bild-Attribute: als Plugin, nicht als Textersetzung.** Die 181 `<img>` des Builds stammen aus drei Quellen — Markdown-Kurzschreibweise (95×), rohe `<img>`-Tags im Fließtext (74×) und Theme-Includes (`page-intro`, `entry`, `about`). Kein Suchen-und-Ersetzen erreicht alle drei. Entscheidender ist aber: `width`/`height` müssten sonst als **feste Zahlen im Inhalt** stehen und würden beim nächsten Neuskalieren eines Bildes still falsch. `_plugins/image_attributes.rb` liest sie stattdessen bei jedem Build aus der Datei:

| Attribut | Vorkommen im Build |
|---|---:|
| `decoding="async"` | 181 / 181 |
| `loading="lazy"` | 164 |
| `loading="eager"` + `fetchpriority="high"` (Intro-Bild) | 17 |
| `width` + `height` | **176** / 181 → seit AP 5: **181 / 181** |

Die fünf Bilder ohne Maße sind die Badges fremder Hosts — ihre Größe ist lokal nicht bekannt (neuer Befund L). ✅ Mit AP 5 liegen sie lokal, damit sind es 181 von 181. Vorhandene Attribute werden nie überschrieben: `_includes/page-intro.html` setzt `loading="eager"`/`fetchpriority="high"` selbst, weil das Intro-Bild fast immer das LCP-Element ist. Drei Icons in `community.md`/`files.md` tragen im Quelltext ein `width="50"`/`width="75"` **ohne** Höhe — dort leitet das Plugin die fehlende Hälfte aus dem Seitenverhältnis der Datei ab (Discord-Logo 71×55 → `50×39`), denn erst das Paar verhindert den Layout-Shift.

Ohne zusätzliches Gem: die Maße kommen aus den Dateiköpfen (JPEG-SOF-Marker, PNG-IHDR, GIF-Header, SVG `width`/`height` bzw. `viewBox`) — im Projekt gibt es nur diese vier Formate.

> ⚠️ **Das Plugin bindet AP 6 fest an GitHub Actions.** Der klassische Pages-Jekyll-Build ignoriert `_plugins/` — dort fielen `loading`, `decoding` und alle Maße lautlos weg, ohne Fehlermeldung. Actions war ohnehin gesetzt (Jekyll 4.4, vendortes Theme), aber es ist jetzt keine Komfortentscheidung mehr.

**Verifikation.**

```
bundle exec jekyll build                         → 27 Seiten, 2 Sass-Deprecations (unverändert)
JEKYLL_ENV=production bundle exec jekyll build   → keine Analytics-ID
bundle exec htmlproofer ./_site --disable-external --swap-urls '^/Cindymill/:/'
  → 43 interne Links, 27 Dateien, HTML-Proofer finished successfully (Exit-Code 0)
```

Zusätzlich, weil „0 Fehler" allein nichts beweist (die Lehre aus Befund M):

- **Alle 151 gemessenen Rasterbilder gegen `sips` gegengeprüft** — 0 Abweichungen zwischen den vom Plugin geschriebenen Maßen und den echten Pixelmaßen. Die drei SVG/Icon-Fälle einzeln nachgerechnet.
- **`rel="preload"` wird von html-proofer geprüft** — Gegentest mit absichtlich falschem Dateinamen: „internally linking to … which does not exist". Ein Tippfehler im Font-Pfad fällt also im CI auf.
- **Exit-Code beider Fälle geprüft:** 1 bei Fehlern, 0 ohne. Der Workflow in AP 6 kann sich darauf verlassen.
- **`jekyll serve` gegengeprüft**, weil `url()` in CSS von keinem Prüfer erfasst wird: `/Cindymill/`, `main.css`, `fira-sans-normal-400-latin.woff2` (`font/woff2`) und ein Galeriebild antworten alle mit 200.
- **Kein Mixed Content mehr:** 0 Treffer für `src="http://` und `href="http://` im gesamten Build.

**Offen aus AP 4:** nichts. Weitergegeben an AP 5: die fünf Fremd-Badges (Befund L). ~~Weitergegeben an AP 7.3~~ ✅ **erledigt am 30.07.2026**: der `http://`-CC-Link im `README.md` steht jetzt auf `https://`, die Datei ist neu gefasst.

### AP 5 — Datenschutz & Rechtstexte ✅ ausgeführt (30.07.2026)

Die Entscheidung ist getroffen: **kein Tracking**. Damit vereinfacht sich dieses Paket erheblich.

1. ✅ **Erledigt in AP 4.** GA4-Snippet aus `_includes/head.html` **und** `google_analytics: G-EFN1CTB4WB` aus `_config.yml` entfernt, dazu der Produktions-Block in `_includes/scripts.html` und die Datei `_includes/google-analytics.html`. Die zweite ID war entgegen Rev. 4 **nicht** tot — sie wäre im Produktionsbuild ausgeliefert worden, siehe Korrektur zu Befund E. Gegengeprüft mit `JEKYLL_ENV=production`: keine ID im Build. Damit ist der technische Teil des Trackings weg; es bleibt der **Rechtstext**.
2. `legal_notice.md` — **Analytics-Abschnitt streichen.** Er beschreibt Universal Analytics mit `_gat._anonymizeIp` und dem Opt-out-Browser-Add-on; beides existiert seit Juli 2023 nicht mehr und beschrieb ohnehin nie das, was lief.
3. **Hosting-Angabe im Impressum** von Ionos auf **GitHub Inc.** ändern (Auftragsverarbeitung, US-Transfer). Ergänzen: GitHub Pages protokolliert Besucher-IP-Adressen — ein kurzer Absatz dazu gehört in die Datenschutzerklärung.
4. **Alle Nennungen von `cindymill.xyz` ersetzen** (3 Stellen in `legal_notice.md`, u. a. „Internet address: www.cindymill.xyz" und die Verantwortlichen-Bezeichnung „the cindymill.xyz") durch `https://culturalheritagedigital.github.io/Cindymill/`.
   ✅ Geprüft: Die Kontakt-E-Mail lautet `cindymill@culturalheritage.digital` — **andere Domain, von der Kündigung nicht betroffen.**
5. **Fünf Fremd-Badges entscheiden (Befund L, neu aus AP 4).** `img.shields.io` (2×), `licensebuttons.net`, `i.creativecommons.org`, `zenodo.org` — die einzigen verbliebenen Drittserver-Requests der Seite, nachdem AP 4 die Google Fonts self-hosted hat. Empfehlung: die vier statischen Bilder mit ins Repo legen (`assets/images/badges/`), Links unverändert lassen. Dann ist die Seite frei von Drittserver-Aufrufen und die Badges bekommen `width`/`height` wie alle anderen Bilder.
6. **Affiliate-Kennzeichnung prüfen:** 115× `amzn.to`, 102× `ebay.us`, 94× AliExpress-Links. Kennzeichnungspflicht besteht unabhängig vom Hosting. Ebenso die LinkedIn- und Facebook-Abschnitte auf Aktualität prüfen.
7. Konsequenz aus dem Wegfall des Trackings: keine Cookies, kein Consent-Banner, keine Cookie-Richtlinie nötig.

#### Ergebnis AP 5 (30.07.2026) — Commit `7e78caa`

12 Dateien, +89/−73, dazu 4 neue Dateien in `assets/images/badges/` (5 KB). Build, Produktionsbuild und html-proofer laufen durch.

| # | Schritt | Ergebnis |
|---|---|---|
| 1 | Tracking-Technik | ✅ war schon in AP 4 erledigt, im Produktionsbuild erneut gegengeprüft: 0 Analytics-IDs |
| 2 | Analytics-Abschnitt streichen | ✅ Abschnitt 7 (Universal Analytics) ersatzlos gelöscht |
| 3 | Hosting-Angabe | ✅ GitHub, Inc. — im Impressum **und** als neu gefasster Abschnitt 3 der Datenschutzerklärung |
| 4 | `cindymill.xyz` ersetzen | ✅ **25 Nennungen in 19 Zeilen** (nicht 3, siehe unten) |
| 5 | Fremd-Badges | ✅ alle 5 Einbindungen lokal, `assets/images/badges/`, 3 Dateien |
| 6 | Affiliate-Kennzeichnung + LinkedIn/Facebook | ✅ 4 Seiten nachgekennzeichnet, LinkedIn-Abschnitt gestrichen, Facebook: nichts zu tun |
| 7 | Keine Cookies / kein Consent-Banner | ✅ als Abschnitt 4 ausdrücklich in die Erklärung geschrieben |

**Punkt 4 war um den Faktor 8 unterschätzt.** Der Plan sprach von „3 Stellen". Tatsächlich stand `cindymill.xyz` **25×** in der Datei — die Domain diente im ganzen Fließtext als *Name des Verantwortlichen* („the cindymill.xyz has implemented…", „an employee of the cindymill.xyz"). Der Generator, aus dem der Text stammt, hat dort offenbar das Feld „Unternehmensname" mit der Domain gefüllt. Ersetzt durch **„the Cindymill project"**, die Adresse selbst nur an der einen Stelle, wo tatsächlich eine Adresse gemeint war (Abschnitt 2, „Website:"). Dabei fiel ein Tippfehler des Originals mit: „the **i**ndymill.xyz" in Abschnitt 9 g).

**Was aus dem Rechtstext geflogen ist.** 8.165 Zeichen, 15 Absätze:

| Abschnitt | Grund |
|---|---|
| 7. Google Analytics | Beschrieb Universal Analytics mit `_gat._anonymizeIp` und dem Opt-out-Add-on. Der Dienst ist seit Juli 2023 abgeschaltet, und die Beschreibung passte auch vorher nicht auf das eingebundene GA4. |
| 8. LinkedIn | Beschrieb ein LinkedIn-Plug-in, das es auf dieser Seite **nie** gab (Befund O). |

**Was neu hineingekommen ist** — die Nummern 4 bis 6 sind neu, die alten Abschnitte 9–13 sind zu 10–14 geworden:

| Abschnitt | Inhalt |
|---|---|
| 3 (neu gefasst) | Hosting durch GitHub, Inc. als Auftragsverarbeiter; Server-Logs mit IP-Adressen; **ausdrücklich: wir haben keinen Zugriff darauf** und können sie nicht auswerten oder löschen; Drittlandtransfer (SCC / EU-U.S. Data Privacy Framework) mit dem Hinweis, dass Behördenzugriff nicht ausgeschlossen werden kann; Links auf die GitHub-Datenschutzerklärung |
| 4 (neu) | Keine Cookies, kein Tracking, keine Analyse, kein Consent-Banner — und der Satz, dass mit Ausnahme der 3D-Modelle keine Fremdserver kontaktiert werden |
| 5 (neu) | Die vier Sketchfab-iframes (Befund N): Betreiber, welche Daten anfallen, dass es beim Seitenaufruf ohne Zutun passiert, **welche vier Seiten betroffen sind und dass die anderen 23 es nicht sind** |
| 6 (neu) | Affiliate-Links: Provision, kein Einfluss auf den Preis, und die technisch wichtige Klarstellung, dass beim *Anzeigen* der Seite nichts an die Shops übertragen wird — erst beim Klick |

Der Hosting-Abschnitt war eine **Ergänzung, keine Änderung**: Ionos kam im Rechtstext nie vor. Abschnitt 3 beschrieb Server-Logs so, als würden sie vom Verantwortlichen selbst geführt und ausgewertet („the cindymill.xyz analyzes anonymously collected data statistically"). Unter GitHub Pages ist das schlicht nicht möglich — genau diese Nicht-Verfügbarkeit steht jetzt dort.

**Badges (Befund L) — 5 Einbindungen, 3 Dateien.** Die CC-Buttons von `licensebuttons.net` und `i.creativecommons.org` sind **byte-identisch** (SHA-256 `c15eb636…87c8`), eine Datei bedient also beide Einbindungen:

| Datei | px | Ersetzt |
|---|---|---|
| `paypal-tip-me.svg` | 109×20 | `img.shields.io` in `index.html` und `_assembly/z_axis_assembly.md` |
| `cc-by-nc-sa-4.0-88x31.png` | 88×31 | `licensebuttons.net` (`index.html`) **und** `i.creativecommons.org` (`files.md`) |
| `zenodo-doi-5118794.svg` | 184×20 | `zenodo.org` in `index.html` |

Die verlinkten Ziele (PayPal, Creative Commons, DOI) sind unverändert. Beide SVG enthalten **keine** externen Referenzen — beim shields.io-Badge steckt das PayPal-Logo als `data:`-URI darin, das wurde eigens geprüft. Herkunft, Abrufdatum, Lizenzlage und die Folge („die Badges sind jetzt Standbilder, der Zenodo-Badge zieht eine neue DOI-Version nicht mehr selbst nach") stehen in `assets/images/badges/README.txt` — dieselbe Praxis wie beim OFL-Text der Schrift in AP 4.

**Nebenwirkung: `width`/`height` sind jetzt bei 181 von 181 Bildern.** Die fünf Ausnahmen aus AP 4 waren genau diese Badges — ihre Maße waren lokal nicht bekannt. `_plugins/image_attributes.rb` liest sie nun aus den Dateien, inklusive der beiden SVG (`width`/`height` im `<svg>`-Tag; Zenodo liefert `183.84375` → gerundet 184).

**Affiliate-Kennzeichnung: die Hälfte fehlte.** Von 8 Seiten mit Affiliate-Links trugen nur 4 einen Hinweis:

| Seite | Affiliate-Links | Hinweis vorher |
|---|---:|---|
| `_parts/mechanical_parts.md` | 191 | ✅ |
| `_parts/electronic_parts.md` | 62 | ✅ |
| `_parts/indymill_upgrade_parts.md` | 34 | ✅ |
| `accessories.md` | 9 | ✅ |
| `_posts/2021-08-01-SpeedsAndFeeds.md` | 10 | ❌ ergänzt |
| `_parts/milled_parts.md` | 3 | ❌ ergänzt |
| `_assembly/z_axis_assembly.md` | 2 | ❌ ergänzt |
| `_assembly/portal_assembly.md` | 1 | ❌ ergänzt |

Ergänzt wurde der **im Projekt schon vorhandene Wortlaut**, unverändert und an derselben Stelle (Seitenende, nach einer `---`-Trennlinie) — kein neuer Text, keine neue Formulierung. Zusätzlich benennt der neue Abschnitt 6 der Datenschutzerklärung die drei Programme. Nachgezählt im Build: 8 von 8 Seiten mit Affiliate-Links tragen jetzt den Hinweis.

> ⚠️ **Eine Falle beim Anhängen:** `---` direkt in der Zeile nach einem Textabsatz macht diesen Absatz in Markdown zur `<h2>`-Überschrift (Setext-Syntax), statt eine Trennlinie zu erzeugen. Der erste Versuch hat genau das getan. Nötig ist eine Leerzeile davor. Im Build gegengeprüft: 8× `<p>This page contains affiliate links…`, 0× `<h2>`.

**Sketchfab: offengelegt, nicht entfernt (Befund N).** Vier `<iframe>` von `sketchfab.com` sind nach AP 5 die **einzigen** Fremdserver-Aufrufe der Seite. Sie zu entfernen hieße, den Inhalt von vier Anleitungsseiten zu beschneiden — das verbietet die Rahmenbedingung „Inhalt bleibt 1:1 erhalten". Gewählt: vollständige Offenlegung in Abschnitt 5.

> **Offene Entscheidung für den Betreiber.** Die strengere Variante wäre **Klick-zum-Laden**: statt des iframes ein lokales Vorschaubild mit Hinweistext, das den iframe erst auf Klick nachlädt. Sie hätte den Vorteil, dass ohne Einwilligung keine Daten in die USA gehen — der Punkt, an dem sich das Google-Fonts-Urteil des LG München (2022) und die Aufsichtsbehörden festmachen. Sie kostet: ein kleines Stück JavaScript, vier Vorschaubilder und die Sofort-Sichtbarkeit des Modells. **Nicht umgesetzt**, weil sie das Ladeverhalten der Seite ändert und damit über einen „rein technischen Umzug" hinausgeht. Der Aufwand liegt bei ~1 h, falls die Entscheidung anders ausfällt.

**Zwei Rechtstext-Fehler ohne Umzugsbezug mitbehoben** (Befund O): die sichtbare E-Mail-Adresse im Impressum stimmte nicht mit ihrem `mailto:` überein, und der LinkedIn-Abschnitt beschrieb eine nicht vorhandene Komponente.

**`_includes/page-intro.html` musste angepasst werden** (Befund P). Die Badges in `index.html` stehen im Front-Matter-Feld `introduction:` — dort wertet Jekyll kein Liquid aus, `relative_url` ist also nicht verfügbar. Der Include gab das Feld bisher nur durch `markdownify`. Jetzt bekommen absolute Asset-Pfade darin den `baseurl` nachträglich:

```liquid
{%- capture intro_asset_prefix -%}"{{ '/assets/' | relative_url }}{%- endcapture -%}
{{ page.introduction | markdownify | replace: '"/assets/', intro_asset_prefix }}
```

Damit bleiben die Pfade im Front Matter in derselben Schreibweise wie die übrigen 27 (absolut, ohne Liquid) und funktionieren unter `/Cindymill/`. Ergebnis im Build: `src="/Cindymill/assets/images/badges/paypal-tip-me.svg"`.

**Verifikation.**

```
bundle exec jekyll build                          → 27 Seiten, 2 Sass-Deprecations (unverändert)
JEKYLL_ENV=production bundle exec jekyll build    → 0 Analytics-IDs, 0 googletagmanager
bundle exec htmlproofer ./_site --disable-external --swap-urls '^/Cindymill/:/'
  → 43 interne Links, 27 Dateien, finished successfully, Exit-Code 0
```

Zusätzlich, weil html-proofer für diese Fragen blind ist:

- **Alle ladenden Elemente des Builds aufgezählt** (`link`/`script`/`iframe`/`img`/`video`/`audio`/`source`/`embed`/`object` mit `http(s)`-Ziel): **4 Treffer, alle `sketchfab.com`**. Kein Bild, kein Skript, keine Schrift von fremden Servern mehr. Die 33 `github.com`- und 115 `amzn.to`-Treffer sind `<a href>` — Hyperlinks laden nichts.
- **Stumpf nach `(src|href)="/assets/` im Build gesucht** (ohne `baseurl`): 0 Treffer. Nur das folgenlose `"thumbnail":` im JSON-LD bleibt (Befund Q) — html-proofer hätte einen echten Treffer hier **nicht** gemeldet, siehe dort.
- **Badge-Maße gegen die Dateien geprüft:** 109×20, 88×31, 184×20; `width`/`height` an 181 von 181 `<img>`.
- **Beide CC-PNG-Quellen als identisch nachgewiesen**, bevor eine Datei für beide Einbindungen verwendet wurde.
- **Abschnittsnummerierung der Datenschutzerklärung durchgezählt:** 1–14 lückenlos, keine verwaisten Querverweise („as stated above", „explained above") auf gelöschte Abschnitte.

**Offen aus AP 5:** die Entscheidung zu Klick-zum-Laden bei Sketchfab (oben). **Weitergegeben:**

- ~~an **AP 7.3**~~ ✅ **erledigt am 30.07.2026**: die drei `Readme.md` unter `model/` (`model/Tools/`, `model/Accessories/`, `model/10mm_Milled_Aluminum_Version/Spacers/`) zeigen auf die Pages-Adresse. Der Text/Ziel-Widerspruch in `model/Accessories/Readme.md` ist aufgelöst — `/addons` hat es im Build nie gegeben, der Linktext nannte mit `/accessories` das richtige Ziel. Siehe Ergebnisbericht zu AP 7.3.
- an **AP 8.4**: in `_posts/2021-08-01-SpeedsAndFeeds.md` zeigt der Link „join our facebook group!" auf `/parts/electronic_parts/` statt auf die Facebook-Gruppe, ein zweiter Link im selben Absatz („Here is a list of cutters I use.") auf dasselbe Ziel. Vorbestehend seit dem ersten Commit (`74e6bbf`), also **nicht** von AP 2 verursacht — nachgeprüft. Inhaltsfehler wie Befund J, aber ohne die dort vorhandene eindeutige Konvention: welches Ziel gemeint war, muss der Autor entscheiden.

### AP 6 — GitHub-Actions-Workflow ✅ ausgeführt (30.07.2026)

`.github/workflows/pages.yml`:

- Trigger: `push` auf `main` + `workflow_dispatch`
- Job **build**: `actions/checkout` → `ruby/setup-ruby` mit `bundler-cache: true` → `bundle exec jekyll build` (mit `JEKYLL_ENV=production`) → `bundle exec htmlproofer ./_site` → `actions/upload-pages-artifact`
- Job **deploy**: `actions/deploy-pages` mit `permissions: pages: write, id-token: write`
- Repo-Einstellungen: **Settings → Pages → Source: GitHub Actions**

`htmlproofer` im Build ist der wichtigste Teil — genau so wären die 73 Backslash-Links nie live gegangen, und genau so fällt ein `baseurl`-Fehler künftig sofort auf. Externe Links im CI ausschließen (`--ignore-status-codes` bzw. `--disable-external`), Laufzeit.

**Vier Vorgaben aus AP 4 und AP 5, die der Workflow einhalten muss:**

1. **`--swap-urls '^/Cindymill/:/'`** an `htmlproofer` übergeben. `baseurl` steht seit AP 4 dauerhaft in `_config.yml`; ohne den Schalter meldet jeder korrekte Pfad einen Fehler. Kein `--baseurl` am `build`-Aufruf nötig.
2. **Kein `bundle exec jekyll build --safe`** und kein Rückfall auf den klassischen Pages-Build: beides ignoriert `_plugins/image_attributes.rb`, und zwar **ohne Fehlermeldung** — `loading`, `decoding` und alle Bildmaße fielen still weg.
3. Der Exit-Code von `htmlproofer` ist verlässlich (1 bei Fehlern, 0 sonst, in AP 4 gegengeprüft). Er ist das Abbruchkriterium — **nicht** die letzte Zeile der Ausgabe, siehe Befund M.
4. **Aus AP 5: zwei stumpfe `grep`-Prüfungen ergänzen**, für die html-proofer nachweislich blind ist (Befund Q):
   - `grep -rE '(src|href)="/assets/' _site` muss **leer** sein — sonst fehlt irgendwo der `baseurl`, und html-proofer meldet es nicht, weil der Pfad gegen die `_site`-Wurzel aufgeht.
   - `grep -c 'width=' _site/index.html` als Wächter dafür, dass `_plugins/` gelaufen ist (Vorgabe 2). Erwartung nach AP 5: `width`/`height` an allen 181 `<img>`.

   Beides sind Einzeiler und decken genau die zwei Fehlerklassen ab, die dieser Umzug als „lokal unsichtbar" kennengelernt hat.

#### Ergebnis AP 6 (30.07.2026) — Commit `dcb2fe4`

Eine neue Datei: `.github/workflows/pages.yml` (110 Zeilen). Zwei Jobs, sieben Schritte.

| # | Vorgabe aus dem Plan | Ergebnis |
|---|---|---|
| 1 | `--swap-urls '^/Cindymill/:/'` an html-proofer | ✅ gesetzt, kein `--baseurl` am Build |
| 2 | kein `--safe`, kein klassischer Pages-Build | ✅ nur `bundle exec jekyll build`; **Wächter 2** belegt es messbar |
| 3 | Abbruch über den Exit-Code, nicht über die Ausgabe | ✅ ergibt sich aus `bash -e` der `run:`-Schritte — die Ausgabe wird nirgends ausgewertet |
| 4 | zwei stumpfe `grep`-Prüfungen | ✅ als eigene Schritte „Wächter 1/2", mit `::error::`-Meldung statt nacktem Exit-Code |

**Job `build`** (`ubuntu-latest`): `actions/checkout@v4` → `ruby/setup-ruby@v1` (`bundler-cache: true`) → Build → html-proofer → Wächter 1 → Wächter 2 → `actions/upload-pages-artifact@v3`.
**Job `deploy`**: `actions/deploy-pages@v4`, `permissions: pages: write, id-token: write`, Environment `github-pages`.
`JEKYLL_ENV: production` steht auf Workflow-Ebene und gilt damit auch für den html-proofer-Lauf — geprüft wird genau der Build, der ausgeliefert wird.

**Abweichung 1: der Trigger ist weiter gefasst als geplant.** Der Plan sah `push` auf `main` + `workflow_dispatch` vor. Umgesetzt ist zusätzlich `push` auf `website-migration` und `pull_request`; der Job `deploy` ist auf `github.ref == 'refs/heads/main'` gekoppelt und läuft dort nicht mit.

Der Grund steht in AP 7.1: Dort wird `website-migration` nach `main` gemergt und **derselbe Merge löst das erste Deployment aus**. Mit dem geplanten Trigger wäre der erste CI-Lauf dieses Projekts zugleich der Livegang gewesen — bei einem Umzug, dessen unangenehmste Funde (Befund K, Befund M) genau die Klasse „fällt erst im CI auf" hatten. Jetzt lässt sich der Workflow auf dem Migrationsbranch trockenlaufen lassen, bevor `main` angefasst wird.

**Abweichung 2: Wächter 2 zählt schärfer als vorgeschlagen.** Der Plan schlug `grep -c 'width=' _site/index.html` vor. Das ist als Wächter untauglich: `width=` steht im Build 518× — überwiegend in den Inline-SVG-Icons des Themes, nicht an `<img>`. Ein Ausfall des Plugins hätte den Zähler also nur gesenkt, nicht auf null gebracht, und jede Erwartungszahl im Workflow veraltet beim ersten neuen Bild. Stattdessen prüft der Schritt eine Invariante:

```bash
total=$(grep -rohE '<img[^>]*>' _site --include='*.html' | wc -l)
bad=$(  … | grep -cvE 'width="[^"]+".*height="[^"]+"|height="[^"]+".*width="[^"]+"')
# Abbruch bei total == 0 oder bad != 0
```

Also: **kein `<img>` ohne beides**. Die Alternation deckt beide Attributreihenfolgen ab; `total == 0` fängt den Fall ab, dass der Build gar nichts erzeugt hat und die Prüfung deshalb trivial bestünde.

**Nicht verwendet: `actions/configure-pages`.** Die Aktion wird in GitHubs Jekyll-Vorlage mitgeliefert, um `baseurl` zur Laufzeit zu setzen. Hier steht `baseurl` seit AP 4 fest in `_config.yml`, und alle Prüfungen (html-proofer-`--swap-urls`, Wächter 1) sind auf genau diesen Wert geeicht. Eine zweite Quelle für dieselbe Einstellung wäre ein stiller Widerspruch — weggelassen.

**Ruby-Version kommt aus `.ruby-version`** (`ruby-version: '.ruby-version'`), nicht als zweite Zahl im Workflow. Damit bleibt AP 3.3 („lokaler Build und CI identisch") auch dann wahr, wenn die Datei einmal geändert wird.

> **Korrektur zu AP 3.1.** Dort steht, `Gemfile.lock` sei „neu aufgelöst, `arm64-darwin`/`ruby`". Tatsächlich enthält die Datei **zehn** Plattformen, darunter `x86_64-linux-gnu` — Bundler 2.6 löst standardmäßig für alle gängigen auf. Nachgesehen, weil ein fehlender Linux-Eintrag den CI-Build entweder zum Nachlösen gezwungen (und die Lockdatei im Lauf verändert) oder ihn unter `frozen` abgebrochen hätte. Es war nichts zu tun; `bundle lock --add-platform x86_64-linux` ist **nicht** nötig.

**`.github/` braucht keinen `exclude:`-Eintrag** — im Gegensatz zur Regel aus Abschnitt 2 („bei jedem neuen Root-Element nachziehen"). Jekyll überspringt Einträge, die mit `.` beginnen, grundsätzlich. Gegen den Build geprüft statt unterstellt: nach `jekyll build` liegt kein `.github` in `_site/`. Ebenso geprüft, dass `.gitignore` die Datei nicht verschluckt (`git check-ignore -v` → kein Treffer) — dieselbe Falle wie Befund K.

**Verifikation.** Alles, was ohne GitHub prüfbar ist, wurde lokal gegen den Produktionsbuild ausgeführt:

```
JEKYLL_ENV=production bundle exec jekyll build   → 27 Seiten
bundle exec htmlproofer ./_site --disable-external --swap-urls '^/Cindymill/:/'
  → 27 Dateien, finished successfully, Exit-Code 0
Wächter 1: grep -rE '(src|href)="/assets/' _site   → 0 Treffer
Wächter 2: 181 <img> im Build, davon 0 ohne width/height
YAML-Syntax:  geparst, jobs = build, deploy
```

Und weil „0 Fehler" allein nichts beweist (die Lehre aus Befund M), beide Wächter mit einem Gegentest auf Ansprechen geprüft:

| Wächter | Gegentest | Ergebnis |
|---|---|---|
| 1 | Datei mit `<a href="/assets/x">` | greift, Treffer wird mit Zeilennummer ausgegeben |
| 2 | `<img src="x.jpg" alt="">` ohne Maße | greift, `bad` = 1 → Abbruch |

Drei Dinge blieben nach der Abgabe lokal unprüfbar: ob `ruby/setup-ruby` mit `bundler-cache: true` auf `ubuntu-latest` durchläuft, ob `_plugins/` dort greift und ob das Artefakt korrekt hochgeladen wird. Sie sind mit dem Probelauf beantwortet — siehe Nachtrag.

#### Nachtrag: AP 7.0 vorgezogen — der Workflow ist real gelaufen (30.07.2026)

`gh auth login` und **Settings → Pages → Source: „GitHub Actions"** wurden unmittelbar nach der Abgabe von AP 6 erledigt (bestätigt: `gh api …/pages` meldet `build_type: workflow`, der Token trägt den `workflow`-Scope, ohne den sich eine Workflow-Datei gar nicht pushen ließe). Damit war AP 7.0 sofort ausführbar — und ist ausgeführt.

**Vor dem Push kontrolliert**, weil die Risikotabelle „manuell prüfen" verlangt und nicht „unterstellen":

| Prüfung | Ergebnis |
|---|---|
| `logs/`, `.htaccess`, `access.log`, `info.php5`, `htpasswd`, `.env`, Keys — **gesamte** Historie über `--diff-filter=A` | 0 Treffer |
| Echte IPv4 in den 15 neuen Commits | genau eine: `217.160.0.21`, die öffentliche Ionos-Server-IP als Befund in diesem Dokument. Keine Besucher-IP. Die 32 weiteren Regex-Treffer sind Artikelnummern aus den Stücklisten (`003.02.006.04` u. ä.) |
| Ionos-Zugangsdaten / htpasswd-Pfad im Klartext | nicht enthalten — Abschnitt 1.5 benennt sie bewusst, ohne sie zu zitieren |
| Arbeitsbaum / Umfang | sauber; 15 Commits, 10,4 MiB |

Danach `git push -u origin website-migration`. Der Branch ist damit öffentlich, die Live-Site unberührt.

**Lauf 1 — `30525990144`, ✅ grün in 40 s.** Die offenen Fragen sind beantwortet:

```
ruby 3.4.10 (x86_64-linux)      ← aus .ruby-version, nicht aus dem Workflow
Bundle complete! 8 Gemfile dependencies, 61 gems now installed.
                                ← dieselbe Zahl wie lokal; die Lockdatei musste
                                  nicht nachgelöst werden (s. Korrektur zu AP 3.1)
Ran on 27 files!  HTML-Proofer finished successfully.
OK: kein (src|href)="/assets/ im Build.         ← Wächter 1
181 <img> im Build, davon 0 ohne width/height.  ← Wächter 2
deploy in 0s                    ← korrekt übersprungen, Branch ≠ main
```

Die vorletzte Zeile ist der eigentliche Gewinn dieses Laufs: **`_plugins/image_attributes.rb` greift auf dem Runner.** Das war die Unbekannte hinter dem Risiko „Eigenes Plugin wird von einer anderen Build-Umgebung ignoriert" — ein Ausfall hätte durchgebaut und nur still die Bildmaße verloren.

**Eine Annotation, behoben — Lauf 2, `30526171441`, ✅ grün in 17 s** (Bundler-Cache greift). Der erste Lauf meldete `actions/checkout@v4` und das intern genutzte `upload-artifact` als Node.js-20-Aktionen, zwangsweise auf Node 24 ausgeführt. Angehoben auf `checkout@v7`, `upload-pages-artifact@v5`, `deploy-pages@v5`; danach **0 Annotationen**, Wächter unverändert.

> ⚠️ **Beim Anheben von `upload-pages-artifact` wäre beinahe eine stille Regression entstanden.** Seit **v4** nimmt die Aktion **keine Dotfiles mehr ins Artefakt** auf. Läge im Build eine `.well-known/`- oder `.nojekyll`-Datei, wäre sie ab diesem Bump kommentarlos aus dem Deployment gefallen — dieselbe Fehlerklasse wie Befund K. Vor dem Bump geprüft: `find _site -name '.*'` → **0 Treffer bei 217 Dateien**, also folgenlos. Der Befund steht als Kommentar an genau der Stelle im Workflow, samt Ausweg `include-hidden-files: true`.

**Offen aus AP 6:** nichts. Der nächste Schritt ist AP 7.1 — der Merge nach `main`, der zugleich das erste Deployment auslöst.

### AP 7 — Livegang und Ionos-Kündigung (Reihenfolge einhalten!)

Ohne eigene Domain entfällt der gesamte DNS-Teil. Es bleibt:

0. ✅ **Erledigt (30.07.2026).** `gh auth login`, **Settings → Pages → Source: „GitHub Actions"**, Vorab-Kontrolle auf personenbezogene Daten, Push von `website-migration`. Der Workflow lief dort zweimal komplett durch — Build, html-proofer, beide Wächter — **ohne** zu deployen. Details im Nachtrag zu AP 6. Der Livegang ist damit nicht mehr zugleich der erste CI-Lauf.
1. ✅ **Erledigt (30.07.2026).** Merge nach `main`, Push, Deployment — siehe Ergebnisbericht unten. **Die Site ist live.**
2. ✅ **Maschinell geprüft (30.07.2026)** — siehe Ergebnisbericht. Der visuelle Durchgang durch die Seiten bleibt dem Betreiber; alles maschinell Prüfbare ist grün.
3. **Externe Verweise auf die alte Domain umbiegen**, solange sie noch erreichbar ist:
   - ✅ `README.md` im Repo-Root — neu gefasst, siehe unten.
   - ✅ die drei `Readme.md` unter `model/` (aus AP 5 hierher gegeben) — siehe unten.
   - ⬜ das „Website"-Feld in den Repo-Einstellungen. **Korrektur:** Es zeigt *nicht* auf `www.cindymill.xyz`, sondern ist **leer** (`gh api …/Cindymill --jq .homepage` → `null`). Seit dem Deployment ist die Pages-URL gültig, das Feld kann gesetzt werden.
   - ⬜ eigene Profile, Foren-Signaturen, YouTube-Beschreibungen, Thingiverse/Printables-Einträge
   - ⬜ der Zenodo-DOI-Eintrag (`10.5281/zenodo.5118794`) verweist auf das Repo — Metadaten prüfen. Der Eintrag ist live (`status: published`, Titel „culturalheritagedigital/Cindymill: Cindymill DIY open source CNC milling machine"); die 403 beim reinen `curl`-Abruf ist Bot-Abwehr, kein toter Link.

#### Ergebnis AP 7.1 und 7.2 — Livegang (30.07.2026), Merge-Commit `edd7de9`

**Die Website läuft unter `https://culturalheritagedigital.github.io/Cindymill/`.**

Vor dem Merge geprüft: Arbeitsbaum sauber, nichts Ungepushtes, `main` **0 Commits** vor dem Branch (Fast-Forward wäre möglich gewesen) — und der grüne CI-Lauf `30526932138` sitzt exakt auf dem Branch-HEAD `be54fac`, nicht auf einem älteren Stand.

Gemergt wurde trotzdem mit **`--no-ff`**: der Merge-Commit gibt einen einzigen Punkt, den `git revert -m 1 edd7de9` in einem Schritt zurückdreht. Bei einem Fast-Forward wären es 19 einzelne Reverts. Nach dem Merge gegengeprüft: `git diff main website-migration` ist leer, im Baum liegen keine Server-Artefakte.

**Deployment-Lauf `30527607219`: `build` 36 s ✅ → `deploy` 10 s ✅.** Das war der erste Lauf des `deploy`-Jobs überhaupt — der einzige Baustein des Workflows, der bis dahin nie ausgeführt worden war.

**Die vier Ionos-Defekte aus Abschnitt 1.1 sind erledigt**, gemessen an der Live-Antwort:

| Merkmal | Ionos (Abschnitt 1.1) | jetzt |
|---|---|---|
| Protokoll | nur HTTP/1.1 | **HTTP/2** |
| Kompression | keine | `content-encoding: gzip` |
| Caching | keine Header | `cache-control: max-age=600` + `expires` |
| HTTPS | **defekt** (TLS-Handshake bricht bei SNI ab) | gültig: `CN=*.github.io`, Let's Encrypt, dazu `strict-transport-security` |

**Prüfung gegen die Live-Site (AP 7.2).** Nicht gegen `_site/`, sondern gegen das, was der Server wirklich ausliefert:

| Prüfung | Ergebnis |
|---|---|
| Alle **27** gebauten Seiten einzeln abgerufen | **27× 200**, 0 Fehler |
| `sitemap.xml`, `robots.txt`, `atom.xml`, `site.webmanifest` | alle 200, korrekte Content-Types |
| Nicht existierende URL | 404 mit der eigenen `404.html` |
| **Jedes Bild auf `gallery.html`** einzeln abgerufen | **53 Bilder, 0 kaputt** |
| Beide CAD-Downloads | abrufbar (21 MB + 1 MB) |
| Schrift, Stylesheet, Badge | 200, `font/woff2`, `text/css`, `image/svg+xml` |
| Tracking im ausgelieferten HTML (9 Seiten) | **0 Treffer** für beide GA-IDs, `googletagmanager`, `google-analytics` |
| Mixed Content / `cdn.mathjax.org` | **0 Treffer** |
| Asset-Pfade **ohne** `/Cindymill`-Präfix (Befund D/Q) | **0 Treffer** |
| Backslash-Pfade `assets%5C` (Befund A) | **0 Treffer** |
| Ladende Fremdserver | nur **`sketchfab.com`** — wie in Abschnitt 5 der Datenschutzerklärung beschrieben |
| `<img>` ohne `width`/`height` | 0 von 99 auf den geprüften Seiten |

Die Zeile **„53 Bilder, 0 kaputt"** ist das eigentliche Ergebnis dieses Umzugs. Befund A — die komplette Galerie über URL-kodierte Windows-Backslashes tot — war der schwerwiegendste inhaltliche Defekt der alten Seite und bestand dort rund 3,8 Jahre.

> **Der visuelle Durchgang bleibt offen und sinnvoll.** Alles Geprüfte oben ist maschinell: Statuscodes, Header, Zeichenketten. Ob die Galerie *aussieht* wie gedacht, ob die Bildqualität nach der Optimierung in AP 1.5 trägt und ob die Blog-Paginierung sich richtig anfühlt, sagt kein `curl`. Dafür ist ein Durchklicken durch die 27 Seiten weiterhin angeraten.

#### Ergebnis AP 7.3 — Readme-Dateien (30.07.2026), Commit `c3ba058`

Vorgezogen vor den Merge, weil die Dateien unabhängig vom Deployment sind. **Es waren genau vier Stellen** — die Jekyll-Quellen sind seit AP 5 frei von `cindymill.xyz`, gegengeprüft mit `git grep` über das ganze Repo (ohne dieses Dokument, wo die Domain als Befundtext steht).

| Datei | vorher | nachher |
|---|---|---|
| `model/Tools/Readme.md` | `[www.cindymill.xyz](http://www.cindymill.xyz)` | Pages-Wurzel |
| `model/10mm_Milled_Aluminum_Version/Spacers/Readme.md` | dito | Pages-Wurzel |
| `model/Accessories/Readme.md` | Text `/accessories`, Ziel `/addons` | `…/Cindymill/accessories.html` |
| `README.md` | `[www.cindymill.xyz](http://www.cindymill.xyz)` | Pages-Wurzel + zwei neue Abschnitte |

**`model/Accessories/Readme.md` war doppelt kaputt.** Der aus AP 5 gemeldete Text/Ziel-Widerspruch löst sich eindeutig auf: eine Seite `addons` hat der Build **nie** erzeugt (`_site/` kennt nur `accessories.html`; die alte Namensgebung überlebt nur in `assets/images/addons/`). Der Link war also schon auf der alten Seite tot, und der *Linktext* nannte das richtige Ziel. Kein Erfinden nötig — dieselbe Lage wie bei Befund J.

**`README.md` neu gefasst.** Der Plan verlangte „Website *und* Modelldaten unter `model/`". Umgesetzt als zwei neue Abschnitte:

- **Documentation** — Link auf die Pages-URL, plus ein Satz, dass das Projekt früher unter `www.cindymill.xyz` lag und diese Adresse aufgegeben ist. Das ist die einzige verbliebene Nennung der alten Domain im Repo, und zwar bewusst: sie steht als Fließtext in Backticks, nicht als Link, und hilft jedem mit einem alten Lesezeichen.
- **What is in this repository** — Tabelle `model/` vs. Root, dazu ein hervorgehobener Hinweis für die **14 Forks**: Pfade von vor dem Umbau brauchen `model/` davor, die Git-Historie jeder Datei ist über die Renames intakt. Das ist die einzige Gegenmaßnahme zum Risiko „Links auf CAD-Dateien brechen durch den `model/`-Umbau", die überhaupt in eigener Hand liegt.

Zwei Altlasten fielen mit: der aus AP 4 hierher gegebene `http://`-CC-Link (→ `https://`, dasselbe Ziel) und die Referenzdefinition `[cc-by-nc-sa-shield]`, die von keiner Stelle benutzt wird — genau die, die AP 5 schon aus `index.html` entfernt hat.

> **Die Fremd-Badges bleiben im `README.md` remote** (shields.io, licensebuttons.net, zenodo.org), anders als auf der Website in AP 5. Der Grund ist nicht Bequemlichkeit: GitHub rendert README-Bilder über den eigenen Camo-Proxy, die Besucher-IP erreicht die fremden Hosts also gar nicht — das Datenschutzargument aus Befund L greift hier nicht. Dafür bleibt der Zenodo-Badge aktualisierbar, was er auf der Website mit dem Lokalisieren verloren hat.

**Verifikation.** Alle acht externen Links der vier Dateien einzeln abgerufen:

```
200  creativecommons.org/licenses/by-nc-sa/4.0/     (jetzt https)
200  licensebuttons.net/…/88x31.png
200  img.shields.io/badge/PayPal-…
200  www.paypal.me/NikoPlath
403  zenodo.org (Badge + doi.org)   → Bot-Abwehr, Eintrag per API als published bestaetigt
404  culturalheritagedigital.github.io/Cindymill/            → erwartet, deployt erst AP 7.1
404  culturalheritagedigital.github.io/Cindymill/accessories.html   → dito
```

Beide 404-Ziele existieren im gebauten `_site/` (`index.html`, `accessories.html`) — sie werden mit dem ersten Deployment gültig. Ebenso geprüft: die lokalen Ziele `cindymill_front_1.jpg`, `model/` und `model/Tools/alignment_tools.jpg` sind vorhanden.
4. **Backup gegenprüfen:** Ist `2026_Backup_Website_Cindymill_Ionos` vollständig, und sind die Ionos-Vertrags-/Zugangsdaten gesichert (AP 0.1)? Nach der Kündigung ist beides nicht mehr abrufbar.
5. **Erst danach bei Ionos kündigen:** Hosting-Paket **und** Domain `cindymill.xyz`. Kündigungsfrist und Vertragsende beachten — Ionos kündigt Domains üblicherweise zum Laufzeitende; bis dahin bleibt die alte Seite ggf. erreichbar.
6. Nach Ablauf: Ionos-Zugangsdaten aus dem Passwortmanager entfernen bzw. archivieren.

> ⚠️ **Kein Weg zurück.** Mit dem Ablauf der Registrierung wird `cindymill.xyz` für Dritte frei registrierbar. Siehe Risiken.

### AP 8 — Nach dem Umzug

1. `robots.txt` und `sitemap.xml` auf absolute URLs prüfen (ergibt sich aus AP 4).
2. Google Search Console: neue Property für `https://culturalheritagedigital.github.io/Cindymill/` anlegen, Sitemap einreichen. **Eine Adressänderung ist nicht möglich** (nur zwischen eigenen Properties, und die alte Domain wird aufgegeben) — die Suchmaschinen-Historie startet neu.
3. Lighthouse-Messung (Performance/Accessibility/SEO/Best Practices) als Beleg.
4. Externe Links prüfen: 115 Amazon-, 102 eBay-, 94 AliExpress-Links aus 2021 sind mit hoher Wahrscheinlichkeit größtenteils tot. `htmlproofer` mit externer Prüfung einmalig manuell laufen lassen. Tote Affiliate-Links sind auch rechtlich unschön.
5. FTP-Spiegel und Rohlogs im Backup **verschlüsselt** ablegen oder die `logs/` daraus löschen — sie enthalten Besucher-IP-Adressen (AP 1.5).

---

## 4. Reihenfolge und Aufwand

| # | Arbeitspaket | Abhängig von | Aufwand (grob) | Status |
|---|---|---|---|---|
| 0 | Repo anbinden, `model/`-Umbau, `.gitignore`, `gh` | — | 1 h | ✅ bis auf die Ionos-Vertragsdaten (`gh auth login` erledigt) |
| 1 | Asset-Diät (tote Dateien, Videos, Bildoptimierung) | 0 | 3–4 h | ✅ 913 MB → 62 MB |
| 2 | Asset-Pfade normalisieren (`relative_url`) | 0 | 2–3 h | ✅ 199 Referenzen + 17 interne Links; html-proofer mit AP 3 nachgeholt: 0 Fehler |
| 3 | Toolchain (Jekyll 4.4, sass-embedded, Theme vendorn) | 0 | 3–4 h | ✅ Build läuft, html-proofer 0 Fehler |
| 4 | `_config.yml` + `head.html` modernisieren | 3 | 2–3 h | ✅ SEO-Metadaten gültig, kein Tracking, Schrift self-hosted, Bildmaße im Build |
| 5 | Datenschutz/Rechtstexte | 4 | 1–2 h | ✅ Analytics- und LinkedIn-Abschnitt raus, Hosting = GitHub, Badges lokal, Affiliate-Hinweise vollständig |
| 6 | GitHub-Actions-Workflow | 2–4 | 1–2 h | ✅ `.github/workflows/pages.yml`, alle 4 Vorgaben umgesetzt, 2 Wächter mit Gegentest, **auf GitHub 2× grün gelaufen** |
| 7 | Livegang, externe Links umbiegen, Ionos kündigen | 6 | 1–2 h | ✅ **Site ist live** (7.0–7.2, Readmes); offen: Repo-Website-Feld, Zenodo, Profile, Ionos-Kündigung |
| 8 | Nacharbeiten, SEO, Linkpflege | 7 | 2–4 h | offen |

> **`assets/` wird erst nach AP 1 committet.** Wer die 708 MB verwaister Assets erst committet und dann löscht, trägt sie dauerhaft in der Git-History mit — jeder Clone und jeder der 14 Forks zieht sie. Das Backup ist der Rollback-Punkt.

**AP 6 hat die Reihenfolge um einen Schritt ergänzt.** Der Workflow prüft jetzt auch auf `website-migration` und in Pull Requests, deployt aber nur von `main`. Dadurch lässt sich der CI-Lauf einmal trocken durchspielen, bevor der Merge in AP 7.1 ihn zum Livegang macht — das ist der neue Schritt **AP 7.0**. Zwei Dinge bleiben aus AP 6 offen, weil sie interaktive Anmeldung verlangen: `gh auth login` und die Repo-Einstellung **Settings → Pages → Source: GitHub Actions**. Ohne die zweite scheitert nur der Deploy-Job; Build und Prüfungen laufen davon unabhängig.

**AP 5 hat die Reihenfolge ebenfalls nicht verschoben**, aber eine Entscheidung offen gelassen, die kein Blocker ist: Klick-zum-Laden für die vier Sketchfab-Einbindungen (Befund N). Sie kann vor oder nach dem Livegang getroffen werden; die Datenschutzerklärung ist in beiden Fällen korrekt, im zweiten Fall nur knapper. Fällt sie für Klick-zum-Laden aus, ist Abschnitt 5 der Erklärung entsprechend zu kürzen.

**AP 4 hat die Reihenfolge nicht verschoben.** Es war Aufräumarbeit auf einem laufenden Build, wie angekündigt — mit einer Ausnahme: `baseurl` steht jetzt dauerhaft in `_config.yml`, und `_plugins/` ist entstanden. Beides bindet AP 6 auf zwei Vorgaben fest (siehe dort).

**AP 1, 2 und 3 waren die kritischen Blocker** — ohne sie wäre der Umzug entweder unnötig teuer geworden (Größe), oder er hätte die kaputte Galerie zementiert und zusätzlich an allen absoluten Pfaden gebrochen. **Alle drei sind seit dem 30.07.2026 erledigt und gegen den gebauten `/Cindymill`-Unterpfad verifiziert.** Ab hier ist nichts mehr blockierend: AP 4–6 sind Aufräum- und Konfigurationsarbeit auf einem laufenden Build.

---

## 5. Risiken

| Risiko | Bewertung | Gegenmaßnahme |
|---|---|---|
| **`cindymill.xyz` wird nach Ablauf von Dritten registriert** | hoch, dauerhaft | Bewusste Entscheidung. Alle eigenen Verweise vorher umbiegen (AP 7.3). Bekannt ist: die Domain kann danach beliebig belegt werden — alte Links in Foren, Videos und Fremdseiten zeigen dann auf Inhalte Dritter. Wer das vermeiden will, müsste die Domain zu einem günstigeren Registrar transferieren statt zu kündigen. |
| **Verlust der Suchmaschinen-Historie und aller Backlinks** | hoch | Unvermeidbare Folge der Domain-Aufgabe. Ohne die alte Domain ist keine 301-Weiterleitung möglich. |
| Absolute Pfade brechen unter `baseurl` | hoch, aber beherrschbar | AP 2 vollständig ausführen, `htmlproofer` im CI als Dauerkontrolle (AP 6) |
| ~~Theme-Gem nicht mehr installierbar~~ | ✅ **erledigt** | Vendoring in AP 3.4 durchgeführt, das Zeitfenster wurde genutzt. Das Gem ist keine Abhängigkeit mehr. |
| ~~Jekyll 4.2 → 4.4 bricht das Theme~~ | ✅ **erledigt** | Eingetreten ist nur, was erwartet war: Sass-Deprecations, keine Fehler. Build und html-proofer laufen durch. |
| ~~Sass-Build scheitert auf Ruby 3.4~~ | ✅ **erledigt** | `jekyll-sass-converter 3.1.0` mit `sass-embedded` — `sassc` ist raus. |
| Dart Sass 3.0 entfernt `@import` und Slash-Division | mittel, aber nicht akut | Das vendorte Theme nutzt beides. In AP 3 bewusst nur stummgeschaltet (`quiet_deps`) statt migriert. Schutz: `jekyll-sass-converter ~> 3.0` verlangt `sass-embedded < 2.0`, der Bruch kann nicht per `bundle update` einziehen. Fällig wird die Migration erst, wenn eine neue Converter-Generation erscheint — dann via `sass-migrator`. |
| **Eigenes Plugin wird von einer anderen Build-Umgebung ignoriert** | ✅ **abgesichert** (Restrisiko niedrig) | `_plugins/image_attributes.rb` (AP 4) läuft nur beim Actions-Build. Der klassische Pages-Build und `--safe` überspringen es **ohne Fehlermeldung**: die Seite baut, sieht fast gleich aus, hat aber keine Bildmaße und kein Lazy-Loading mehr. Seit AP 6 bricht der Workflow ab, sobald auch nur ein `<img>` ohne `width`/`height` im Build steht (Wächter 2) — ein stiller Ausfall ist damit ausgeschlossen. |
| ~~Prüflauf meldet Erfolg, obwohl er Fehler gefunden hat~~ | ✅ **geklärt** | Befund M: Der AP-3-Bericht schrieb „0 Fehler", tatsächlich waren es 4. Ursache war die Auswertung der Ausgabe statt des Exit-Codes. Behoben, Exit-Code-Verhalten in AP 4 gegengeprüft, als Vorgabe in AP 6 verankert. |
| `.gitignore`-Muster greifen tiefer als gedacht | niedrig, aber unsichtbar | Befund K: `vendor/` hätte 38 Theme-Dateien verschluckt, sichtbar erst im CI. Behoben. **Regel für künftige Einträge:** Werkzeug-Ordner auf den Root verankern (`/vendor/`), Sicherheitsmuster (`logs/`, `*.log`, `.htaccess`) absichtlich nicht. Neue Einträge mit `git check-ignore -v` gegenprüfen. |
| **Sketchfab-iframes übertragen die Besucher-IP in die USA** | mittel, bewusst getragen | Befund N. Vier Anleitungsseiten binden 3D-Modelle per iframe ein; entfernen hieße Inhalt entfernen. In AP 5 vollständig offengelegt (Abschnitt 5 der Datenschutzerklärung, mit Nennung der betroffenen Seiten). Restrisiko bleibt: Aufsichtsbehörden verlangen für solche Einbindungen zunehmend eine Einwilligung. Härtere Option ist dokumentiert (Klick-zum-Laden, ~1 h). |
| **Prüfwerkzeug ist für die eigene Kernfrage blind** | ✅ **abgesichert** (Restrisiko niedrig) | Befund Q: html-proofer löst `src="/assets/…"` gegen die `_site`-Wurzel auf und meldet einen fehlenden `baseurl` deshalb **nicht** — obwohl genau das der Blocker aus Befund D war. Seit AP 6 sucht der Workflow zusätzlich stumpf nach `(src\|href)="/assets/` im Build (Wächter 1) und bricht bei jedem Treffer ab. |
| Bild-Optimierung zerstört Bildqualität | niedrig | Originale liegen im Backup (nicht im Repo), Stichproben visuell prüfen |
| Personenbezogene Daten im öffentlichen Repo | niedrig, aber gravierend | `logs/` liegt bereits nur im Backup; vor dem ersten Push manuell prüfen und Git-History kontrollieren |
| Kündigung vor funktionierendem Ersatz | niedrig | Reihenfolge in AP 7 strikt einhalten: erst Site live und geprüft, dann kündigen |
| **Links auf CAD-Dateien brechen durch den `model/`-Umbau** | mittel, teilweise abgefedert | Folge der Umwidmung. Die 14 Forks behalten die alte Struktur und sind nicht erreichbar. Seit AP 7.3 erklärt die `README.md` den Umbau ausdrücklich und sagt, dass alte Pfade ein `model/` davor brauchen — mehr ist von hier aus nicht möglich. Der Umzug ist von Git als Rename erfasst, die Historie bleibt nachvollziehbar. |
| Repo-Root vermischt Website und Modelldaten | niedrig | `exclude:` in `_config.yml` hält `model/` aus dem Build; bei jedem neuen Root-Element nachziehen. `htmlproofer` im CI deckt Fehlkonfigurationen auf. |

---

## 6. Kurzcheckliste

- [x] Backup Ionos-Webspace gezogen (`2026_Backup_Website_Cindymill_Ionos`)
- [x] Arbeitsordner auf Server-Artefakte geprüft, `.gitignore` gesetzt
- [x] Bestehendes Repo angebunden, Branch `website-migration`, Modelldaten nach `model/`
- [x] Website-Quellcode committet (ohne `assets/`), `exclude:` gesetzt
- [x] `gh` installiert
- [x] `gh auth login` ausgeführt (Konto `culturalheritagedigital`, Scopes u. a. `repo`, `workflow`)
- [ ] Ionos-Vertragsdaten/Zugänge gesichert
- [x] `_gallery_fancy.md` und `_about_us.md` (tote Entwürfe) gelöscht
- [x] 340 verwaiste Assets (708 MB) entfernt, alle 11 Videos gelöscht
- [x] 115 Bilder optimiert (183 MB gespart), `assets/` committet → 62 MB
- [x] 199 Asset-Referenzen normalisiert (172 Body auf `relative_url`, 27 Front Matter) + 17 interne Seitenlinks
- [x] `site.webmanifest` / `browserconfig.xml` `baseurl`-fest gemacht (Befund H)
- [x] Tote Links `milling1.mp4` / `stuff1.jpg` samt auskommentierter Blöcke entfernt
- [x] html-proofer-Lauf über den Build: **0 Fehler**, auch unter `--baseurl /Cindymill`
- [x] Jekyll 4.4.1 + sass-embedded, `Gemfile.lock` auf macOS neu aufgelöst, `.ruby-version` 3.4
- [x] Theme vendort (`_layouts/` 12, `_sass/` 81, `main.scss`, `main.js`), Theme-Gem und `theme:`-Zeile entfernt
- [x] Suche restlos entfernt (Includes, `_search.scss`, Layout-Blöcke), Algolia-Key aus `_config.yml`
- [x] `main.css.map` wird nicht mehr ausgeliefert (`sass: sourcemap: never`)
- [x] `.gitignore` verankert (`/vendor/`) — sonst wären 38 Theme-Dateien aus dem Commit gefallen
- [ ] Algolia `search_only_api_key` im Algolia-Konto widerrufen (steht noch in der Git-Historie)
- [x] MathJax-Block gelöscht, GA4-Snippet gelöscht, Google Fonts self-hosted (Quelle: `_data/theme.yml`)
- [x] `google_analytics` aus `_config.yml`, `scripts.html`-Block und `google-analytics.html` entfernt — Produktionsbuild trackt nicht
- [x] IE-Altlasten raus (`X-UA-Compatible`, „cut the mustard", `no-js`), eBay-Tag `value=` → `content=`
- [x] Fira Sans als 8 WOFF2 in `assets/fonts/` (OFL-Text dabei), `font-display: swap`, Regular per `rel=preload`
- [x] `loading`/`decoding` an allen 181 `<img>`, `width`+`height` an 176 (`_plugins/image_attributes.rb`), Intro-Bild `fetchpriority="high"`
- [x] Bildmaße gegen `sips` gegengeprüft: 151 Rasterbilder, 0 Abweichungen
- [x] `url` + `baseurl: /Cindymill` gesetzt, sitemap/canonical/OG/robots/atom korrekt
- [x] Kein Mixed Content mehr (4 CC-Lizenzlinks auf `https://`, Befund M)
- [x] Datenschutzerklärung: Analytics-Abschnitt raus, Hosting auf GitHub Inc. (ergänzt, Ionos stand nie drin), 25 Nennungen von cindymill.xyz ersetzt
- [x] LinkedIn-Abschnitt gestrichen (nie eine LinkedIn-Komponente eingebunden), Facebook geprüft: nur Links, kein Plug-in
- [x] Neue Abschnitte: keine Cookies/kein Tracking, Sketchfab-iframes, Affiliate-Links; Nummerierung 1–14 durchgezählt
- [x] Impressum: sichtbare E-Mail-Adresse an das `mailto:` angeglichen (Befund O)
- [x] Fünf Fremd-Badges lokal ausgeliefert (Befund L) → `assets/images/badges/`, 3 Dateien, `README.txt` mit Herkunft
- [x] `width`/`height` jetzt an 181 von 181 `<img>` (die 5 Badges waren die Lücke aus AP 4)
- [x] Affiliate-Kennzeichnung: 4 von 8 Seiten hatten keine, ergänzt — 8/8 im Build gegengeprüft
- [x] Keine Fremdserver-Bilder, -Skripte oder -Schriften mehr im Build; verbleibend: 4 Sketchfab-iframes (Befund N)
- [ ] **Entscheidung offen:** Klick-zum-Laden für die vier Sketchfab-Einbindungen statt Direktladen (~1 h)
- [x] `.github/workflows/pages.yml` angelegt: Build (`JEKYLL_ENV=production`) → html-proofer → 2 Wächter → Deploy nur von `main`
- [x] Wächter 1 (`(src|href)="/assets/` = 0) und Wächter 2 (kein `<img>` ohne `width`/`height`) lokal grün **und** per Gegentest auf Ansprechen geprüft
- [x] **Settings → Pages → Source: „GitHub Actions"** im Repo gesetzt (`build_type: workflow` bestätigt)
- [x] Vor dem ersten Push: gesamte Historie auf `logs/`, `.htaccess`, Rohlogs, Keys geprüft — 0 Treffer; einzige echte IP ist die Ionos-Server-IP in diesem Dokument
- [x] Probelauf AP 7.0: `website-migration` gepusht, Workflow **2× grün** (`30525990144`, `30526171441`), Deploy korrekt übersprungen
- [x] Auf dem Runner belegt: `_plugins/` greift (181/181 `<img>` mit Maßen), Lockdatei nicht nachgelöst, 0 Annotationen nach dem Action-Bump
- [x] GitHub-Actions-Workflow deployt (`30527607219`: build 36 s, deploy 10 s), htmlproofer meldet 0 tote interne Links
- [x] Merge nach `main` als `--no-ff` (Commit `edd7de9`) — in einem Schritt zurückdrehbar
- [x] Live geprüft: 27/27 Seiten 200, **53/53 Galeriebilder**, beide CAD-Downloads, `atom.xml`/`sitemap.xml`/`robots.txt`, eigenes 404
- [x] Live gegengeprüft: 0 Tracking, 0 Mixed Content, 0 Asset-Pfade ohne `baseurl`, 0 Backslash-Pfade, einziger ladender Fremdserver ist `sketchfab.com`
- [x] HTTP/2, gzip, `cache-control`, gültiges Let's-Encrypt-Zertifikat + HSTS — alle vier Ionos-Defekte aus Abschnitt 1.1 erledigt
- [ ] Site visuell durchgeklickt (Bildqualität nach der Optimierung, Galerie-Layout, Blog-Paginierung — das prüft kein `curl`)
- [x] `README.md` neu gefasst (Website + `model/`, Pages-URL, Fork-Hinweis, `http://`-CC-Link und ungenutzte Shield-Referenz raus)
- [ ] Externe Verweise auf cindymill.xyz umgebogen — Repo-Website-Feld (ist **leer**, nicht falsch gesetzt), Zenodo-Metadaten, Profile, Foren
- [x] Die drei `Readme.md` unter `model/` umgebogen; toter `/addons`-Link auf `accessories.html` korrigiert
- [x] `git grep` über das ganze Repo: **0** verbliebene `cindymill.xyz`-Links (die eine Textnennung im `README.md` ist Absicht)
- [ ] Fehlleitender Link „join our facebook group!" in `SpeedsAndFeeds` (aus AP 5 an AP 8.4 gegeben)
- [ ] Ionos-Hosting-Paket gekündigt
- [ ] Ionos-Domain `cindymill.xyz` gekündigt
