culturalheritagedigital/Cindymill/assets/images/addons/limitswitches/limitswitch1.jpg

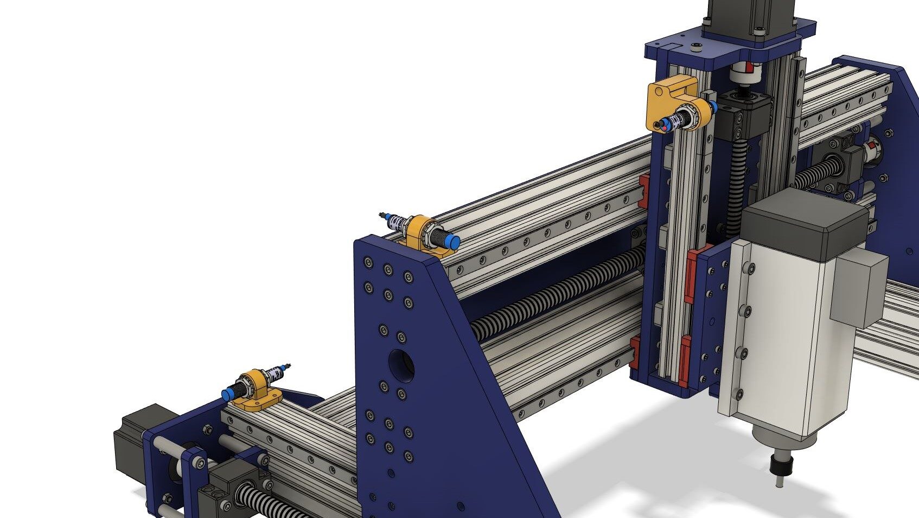
assets/images/addons/limitswitches/limitswitch1.jpg
