culturalheritagedigital/Cindymill/assets/images/addons/limitswitches/limitswitch5.jpg

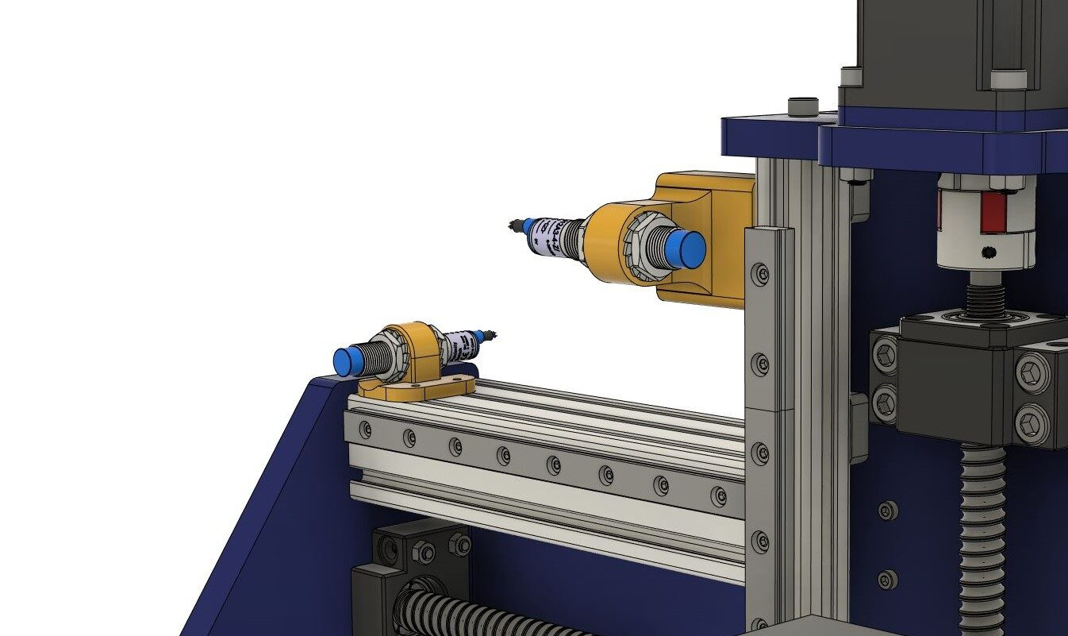
assets/images/addons/limitswitches/limitswitch5.jpg
