culturalheritagedigital/Cindymill/assets/images/comparison/images/indymill_X_displacement1.jpg

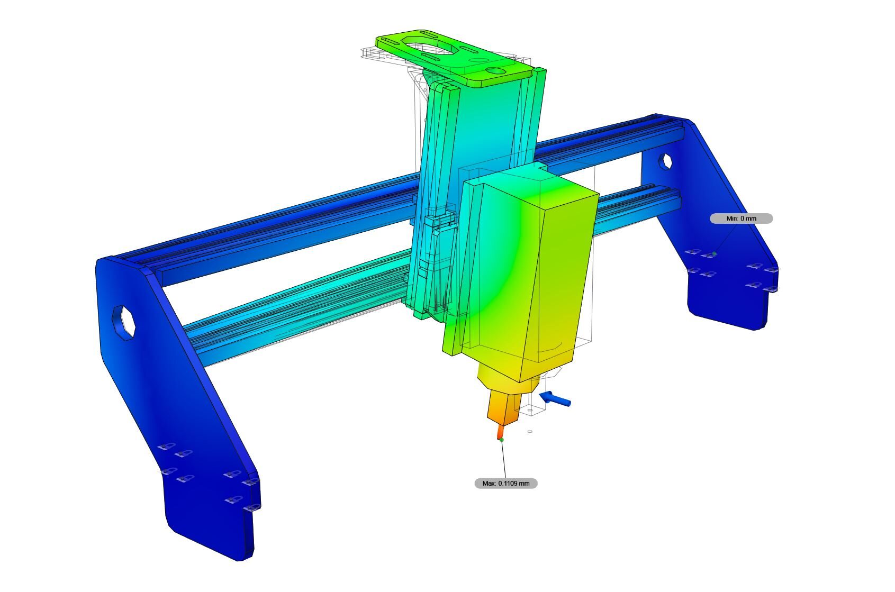
assets/images/comparison/images/indymill_X_displacement1.jpg
