culturalheritagedigital/Cindymill/assets/images/comparison/images/indymill_Y_displacement1.jpg

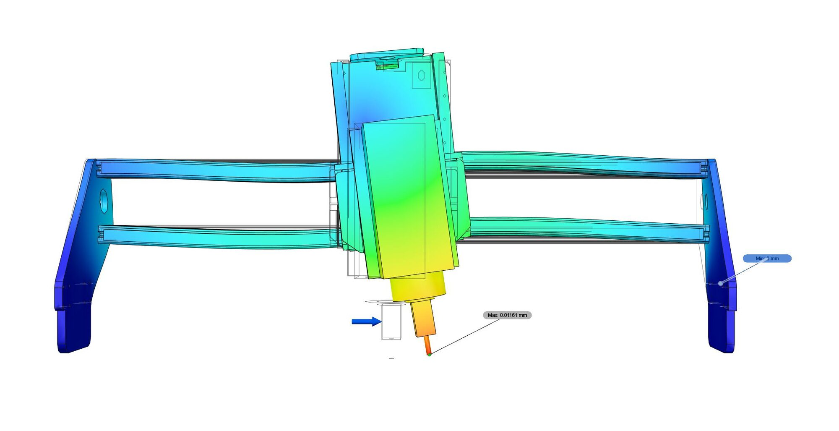
assets/images/comparison/images/indymill_Y_displacement1.jpg
