culturalheritagedigital/Cindymill/assets/images/comparison/images/indymill_Y_displacement_backplate1.jpg

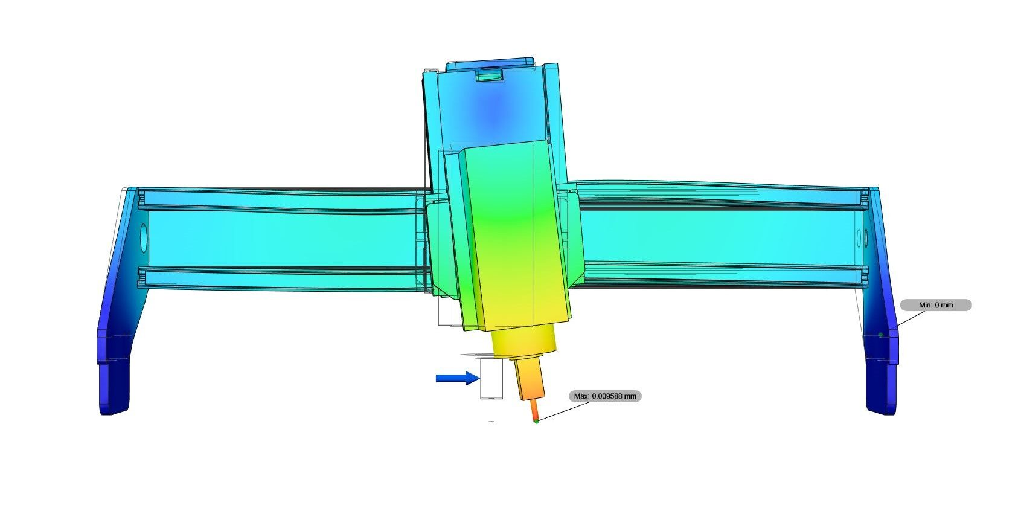
assets/images/comparison/images/indymill_Y_displacement_backplate1.jpg
