culturalheritagedigital/Cindymill/assets/images/comparison/images/indymill_Z_displacement_backplate1.jpg

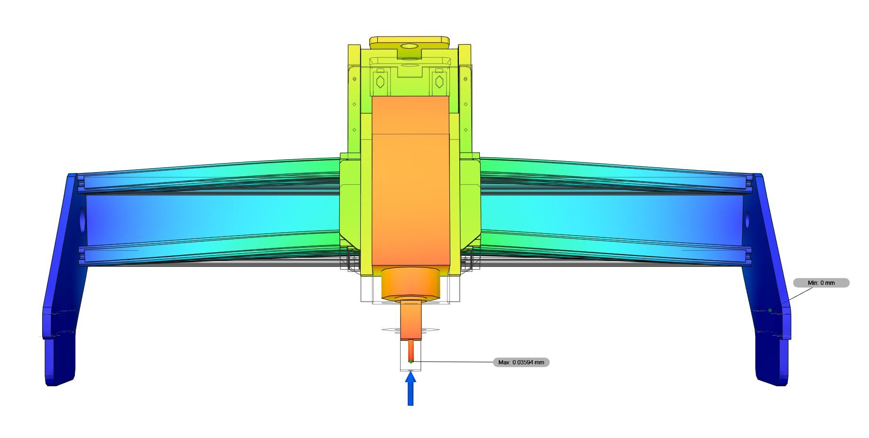
assets/images/comparison/images/indymill_Z_displacement_backplate1.jpg
