culturalheritagedigital/Cindymill/assets/images/comparison/videos/indymill_Y.gif

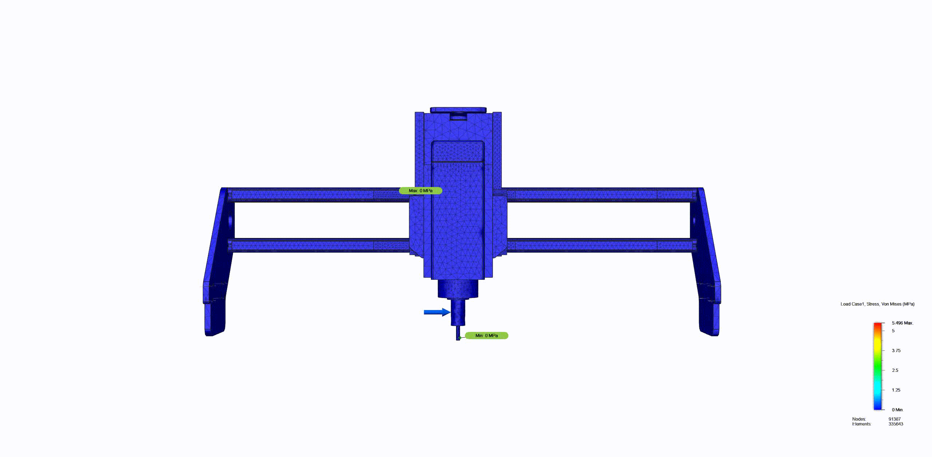
assets/images/comparison/videos/indymill_Y.gif
