culturalheritagedigital/Cindymill/assets/images/front.jpg

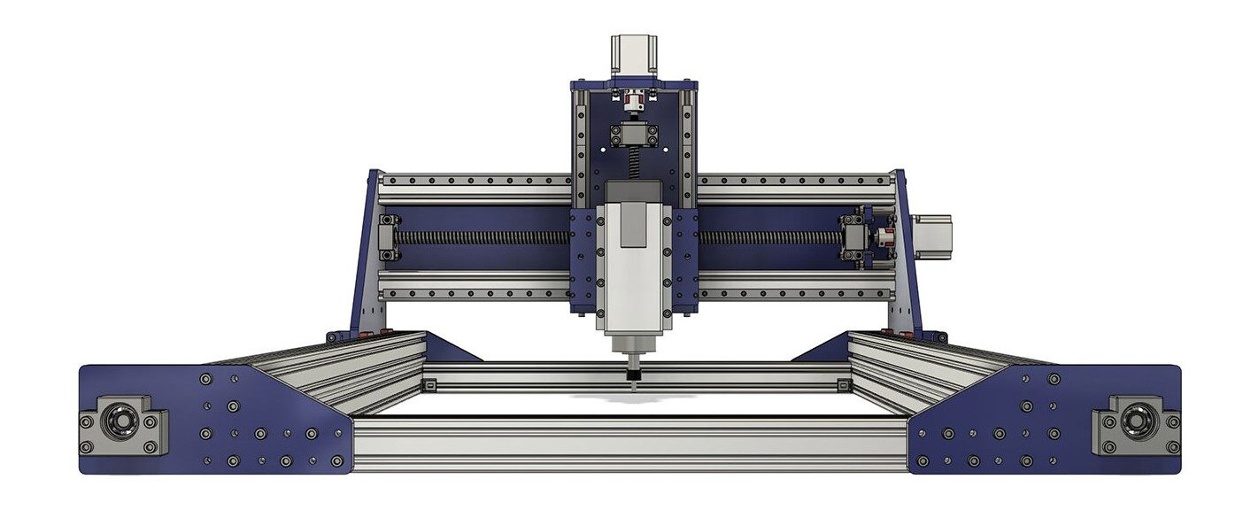
assets/images/front.jpg
