culturalheritagedigital/Cindymill/assets/images/gallery/portal/portal3.jpg

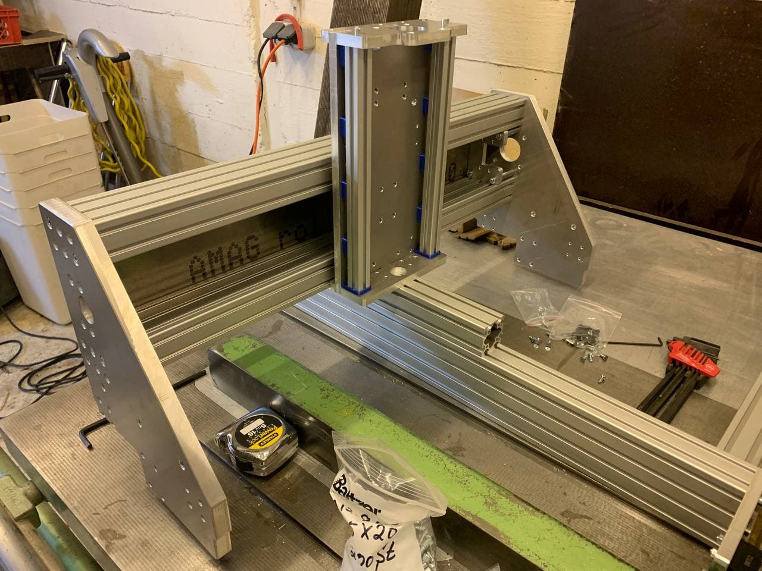
assets/images/gallery/portal/portal3.jpg
