culturalheritagedigital/Cindymill/assets/images/gallery/zaxis/zaxis3.jpg

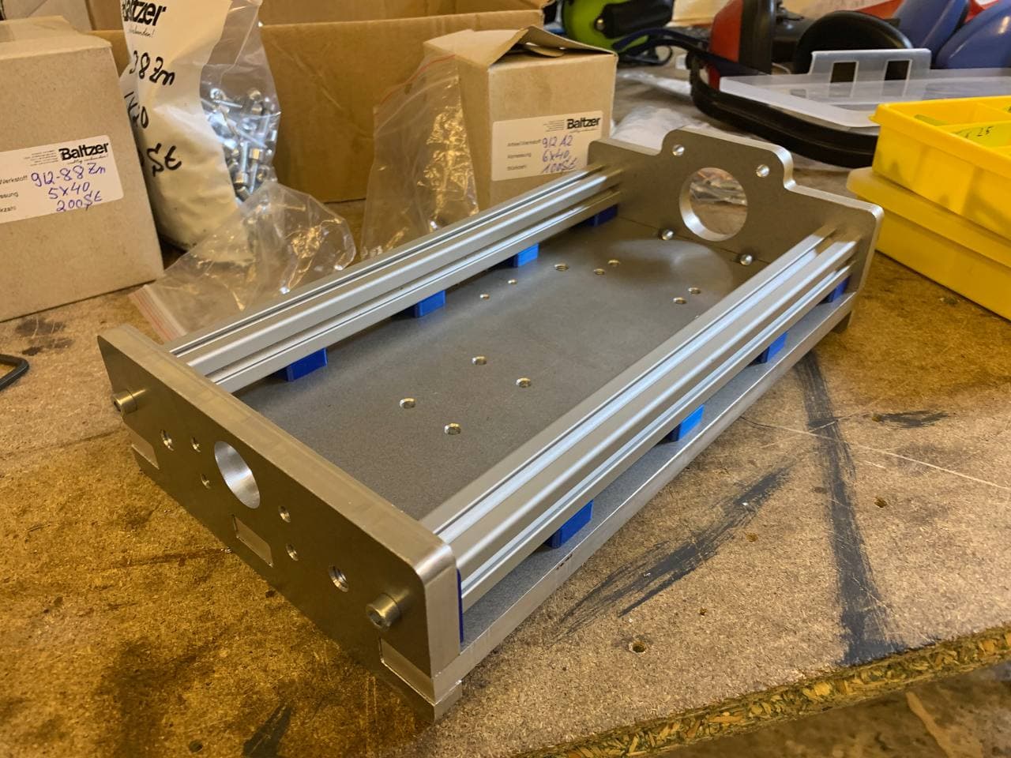
assets/images/gallery/zaxis/zaxis3.jpg
