culturalheritagedigital/Cindymill/assets/images/itype5.jpg

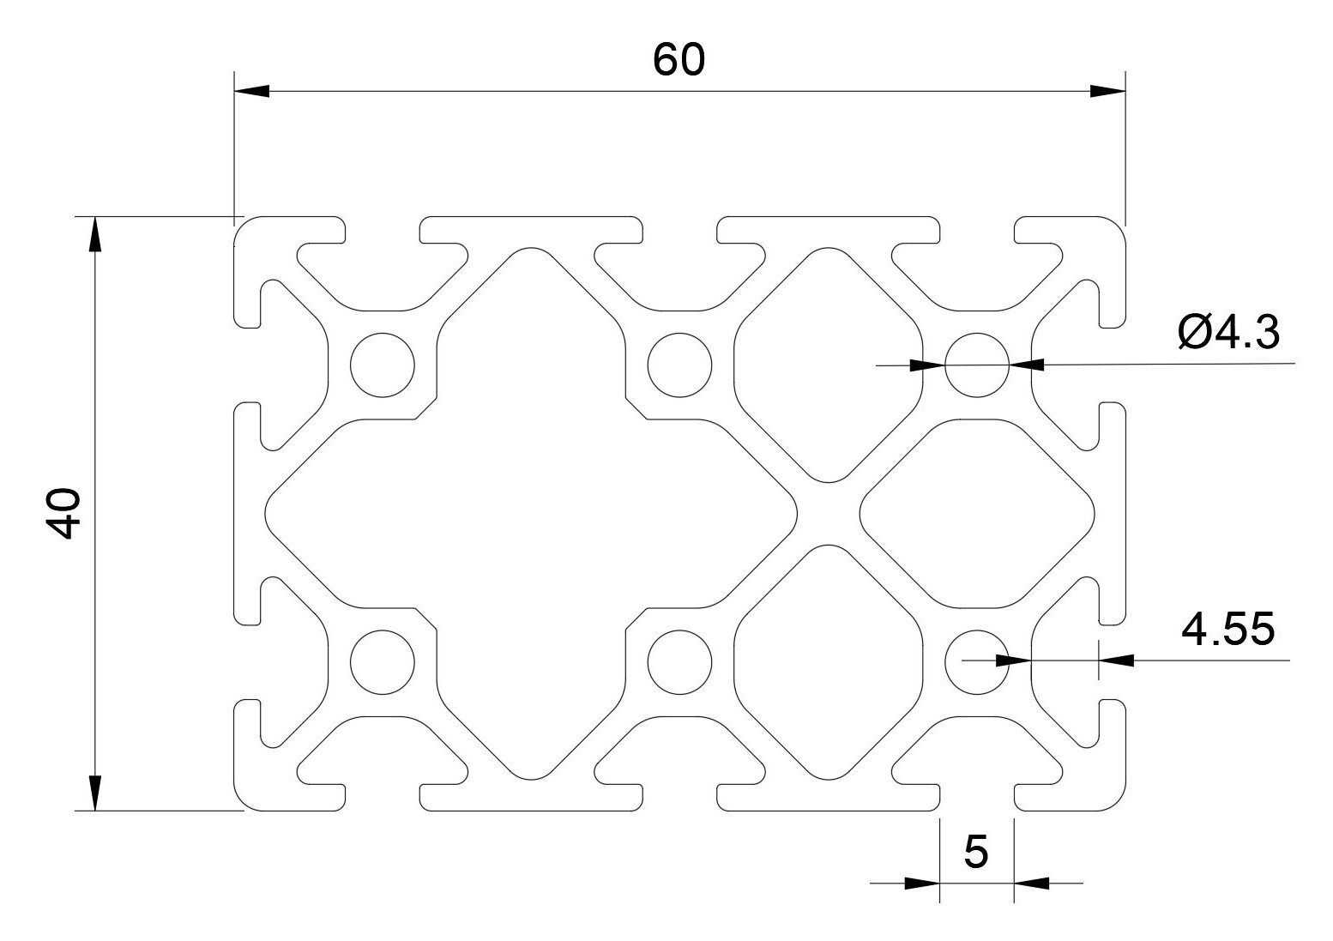
assets/images/itype5.jpg
