culturalheritagedigital/Cindymill/assets/images/mechanicalparts_title.jpg

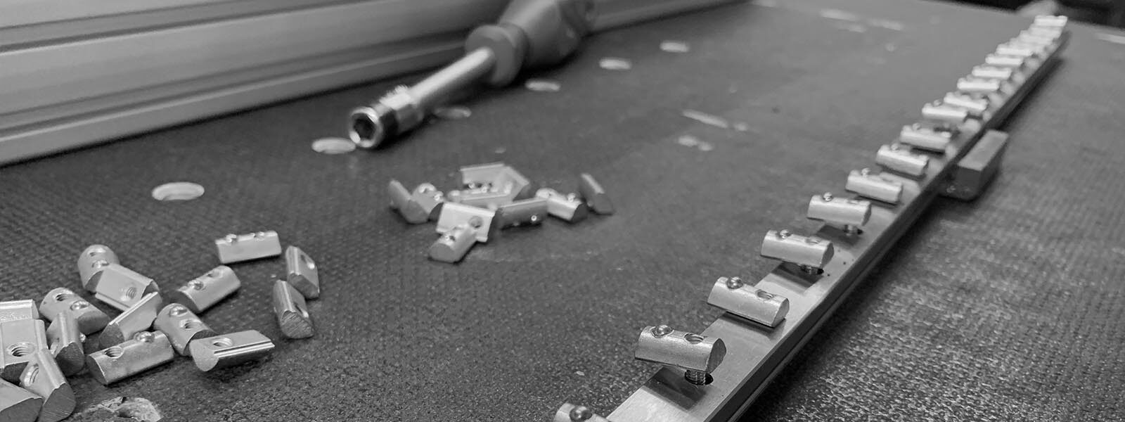
assets/images/mechanicalparts_title.jpg
