culturalheritagedigital/Cindymill/assets/images/rend5.png

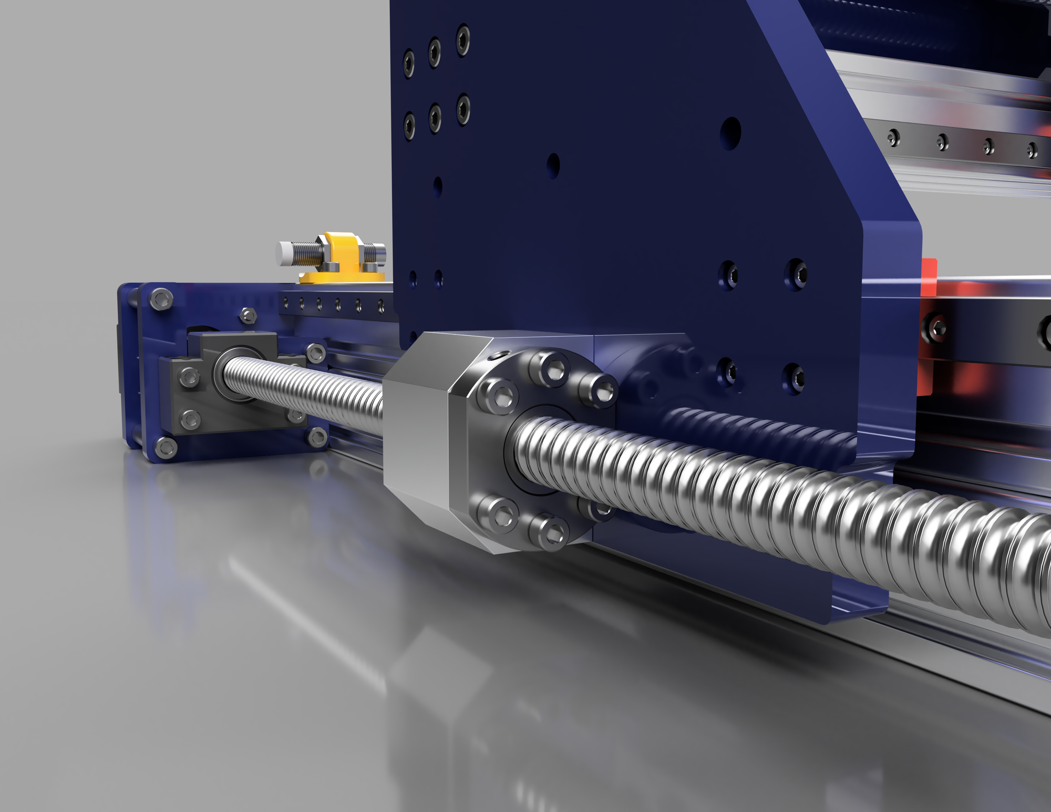
assets/images/rend5.png
