culturalheritagedigital/Cindymill/assets/images/rend10.png

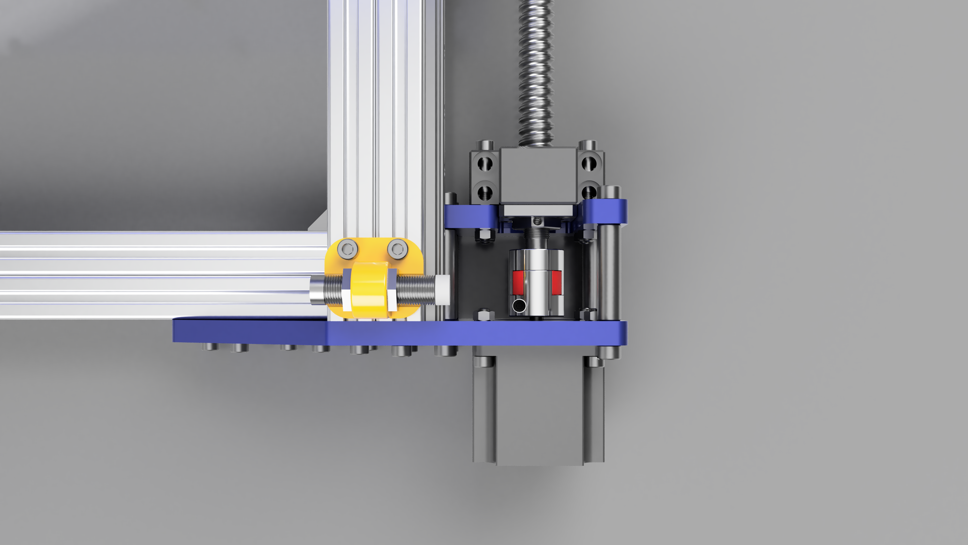
assets/images/rend10.png
