culturalheritagedigital/Cindymill/assets/images/screws1.png

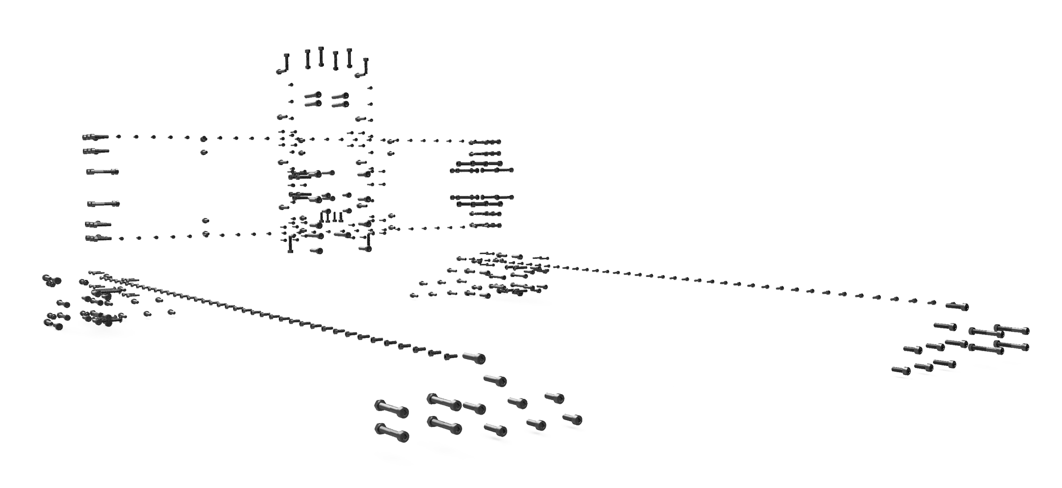
assets/images/screws1.png
