culturalheritagedigital/Cindymill/assets/images/steel/Cindymill_6mm_Steel_Plates2.jpg

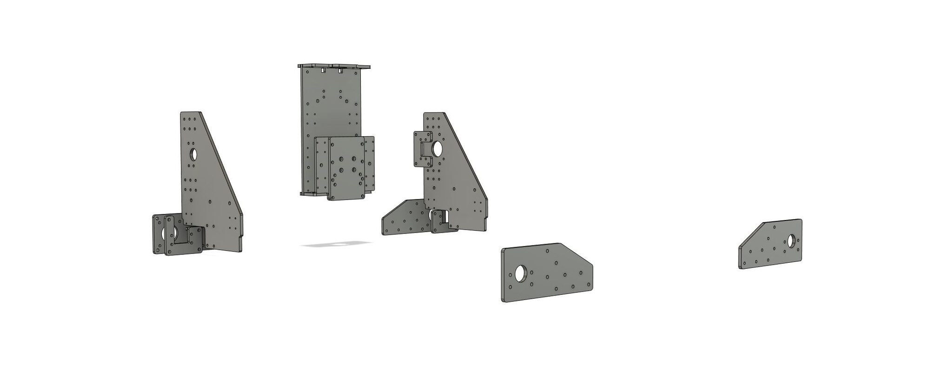
assets/images/steel/Cindymill_6mm_Steel_Plates2.jpg
