culturalheritagedigital/Cindymill/assets/images/tools.jpg

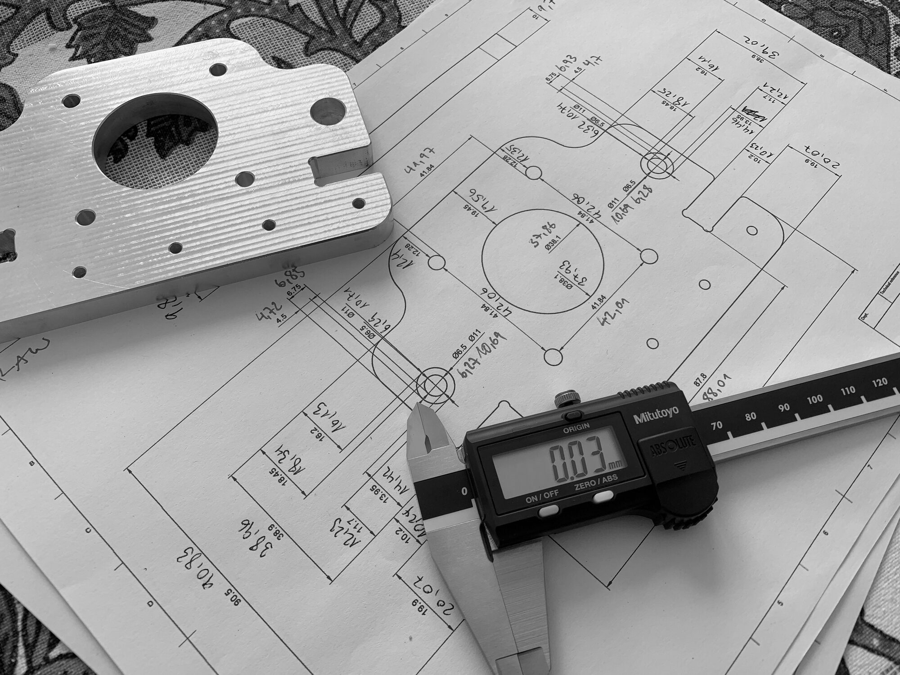
assets/images/tools.jpg
