culturalheritagedigital/Cindymill/assets/images/upgrade_indymill_title1.jpg

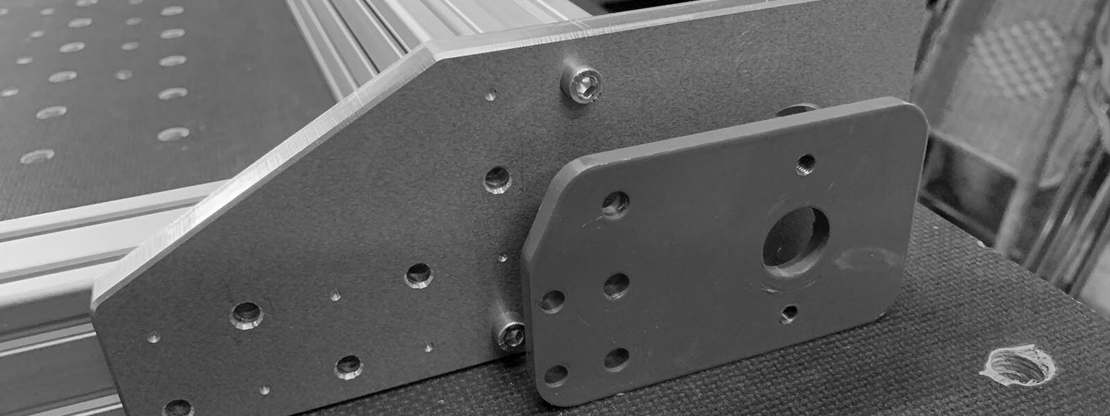
assets/images/upgrade_indymill_title1.jpg
