culturalheritagedigital/Cindymill/parts.md

---
title: Parts
layout: collection
permalink: /parts/
collection: parts
entries_layout: list
show_excerpts: false # (default), false
sort_by: title
introduction: |
  This section covers all needed parts and provides links to the usual marketplaces. 
  Most parts can be ordered in China via Banggood and Aliexpress, however, depending on your country it could be that import taxes (over)compensate the low price and it is then wiser to choose the fast delivery time via a local dealer on eBay or Amazon.
  For some parts I will give an inexpensive and more expensive alternatives and try to explain the pros and cons of each variant.
  I will also try to address the frequently asked questions from our Facebook group - Which voltage to choose for the power supply? Which motors? Milling bits to start with for wood and aluminum?
---
