culturalheritagedigital/Cindymill/10mm_Milled_Aluminum_Version/Milled_Plates/Cindymill_Aluminum_Plates_Complete.step

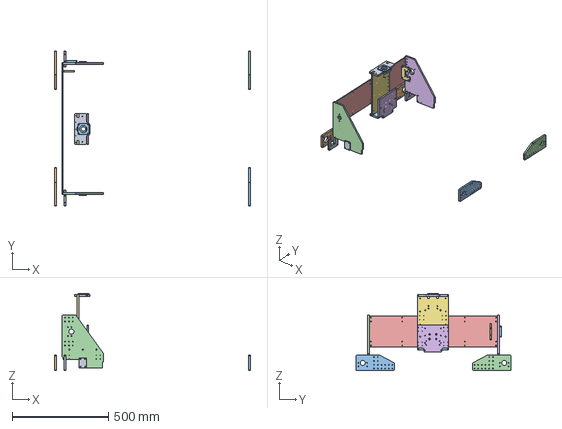
[picture p53: CAD file, 2021-07-16]
10mm_Milled_Aluminum_Version/Milled_Plates/Cindymill_Aluminum_Plates_Complete.step
1020.0 x 808.2 x 401.1 mm
Frame
NutBlock
