culturalheritagedigital/Cindymill/10mm_Milled_Aluminum_Version/Milled_Plates/Cindymill_Aluminum_Sideplates_15mm.step

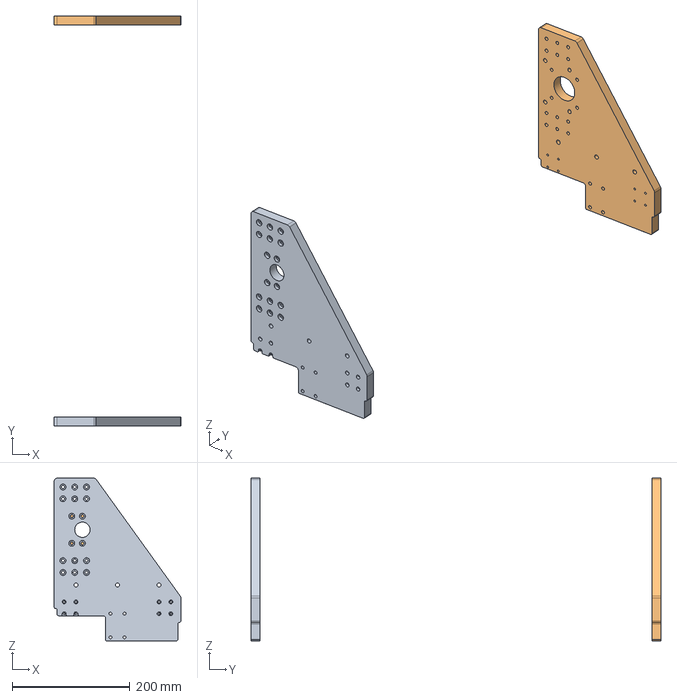
[picture p54: CAD file, 2021-08-07]
10mm_Milled_Aluminum_Version/Milled_Plates/Cindymill_Aluminum_Sideplates_15mm.step
215.2 x 696.0 x 276.1 mm
