culturalheritagedigital/Cindymill/10mm_Milled_Aluminum_Version/Milled_Plates/Frame/1x_Cindymill_Aluminum_Frame_Plate_L_B_10mm.dxf

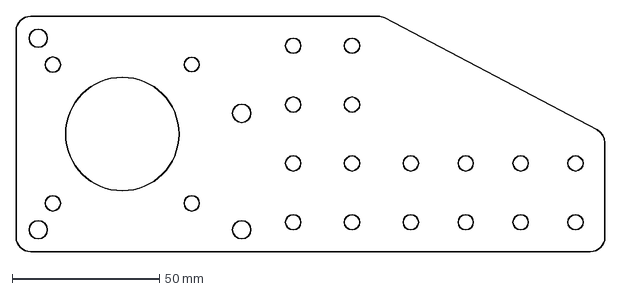
[picture p55: CAD file, 2021-07-19]
10mm_Milled_Aluminum_Version/Milled_Plates/Frame/1x_Cindymill_Aluminum_Frame_Plate_L_B_10mm.dxf
200.0 x 80.0 mm
