culturalheritagedigital/Cindymill/10mm_Milled_Aluminum_Version/Milled_Plates/ZAxis/1x_Cindymill_Aluminum_Z_Axis_Spindle_Plate_Spacer_3mm.dxf

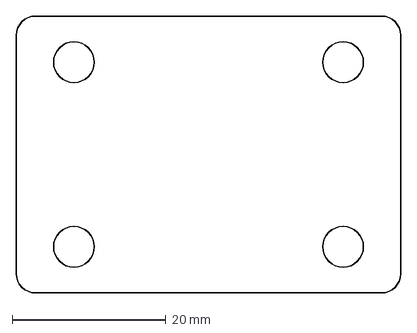
[picture p56: CAD file, 2021-07-19]
10mm_Milled_Aluminum_Version/Milled_Plates/ZAxis/1x_Cindymill_Aluminum_Z_Axis_Spindle_Plate_Spacer_3mm.dxf
50.0 x 36.0 mm
