culturalheritagedigital/Cindymill/10mm_Milled_Aluminum_Version/Spacers/1x_Cindymill_Z_Axis_Motor_Spacer_5mm.stl

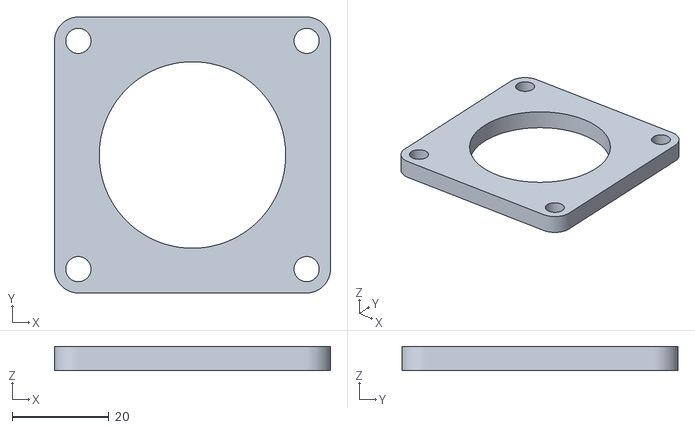
[picture p57: CAD file, 2021-07-12]
10mm_Milled_Aluminum_Version/Spacers/1x_Cindymill_Z_Axis_Motor_Spacer_5mm.stl
57.0 x 57.0 x 5.00
