culturalheritagedigital/Cindymill/6.35mm_Lasercut_Steel_Version/Lasercut_Plates/Frame/2x_Cindymill_Steel_Frame_Plate_Front_6.35mm.dxf

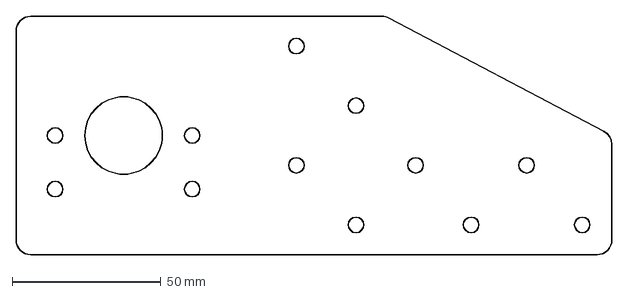
[picture p58: CAD file, 2021-10-28]
6.35mm_Lasercut_Steel_Version/Lasercut_Plates/Frame/2x_Cindymill_Steel_Frame_Plate_Front_6.35mm.dxf
200.0 x 80.0 mm
