culturalheritagedigital/Cindymill/6.35mm_Lasercut_Steel_Version/Lasercut_Plates/Portal/1x_Cindymill_Steel_Portal_Sideplate_Left_6.35mm.dxf

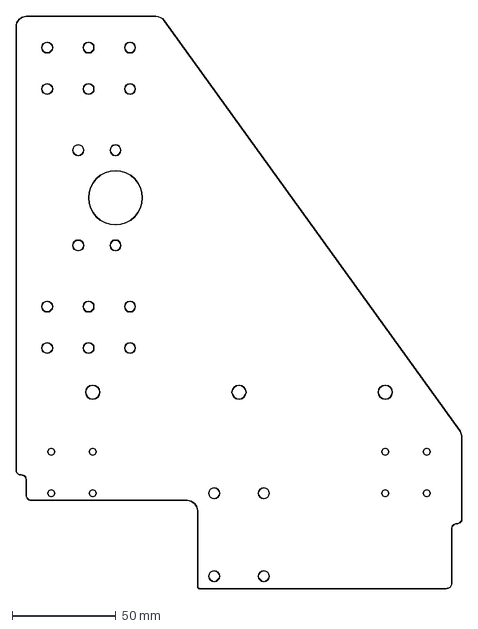
[picture p59: CAD file, 2021-10-28]
6.35mm_Lasercut_Steel_Version/Lasercut_Plates/Portal/1x_Cindymill_Steel_Portal_Sideplate_Left_6.35mm.dxf
215.2 x 276.1 mm
