culturalheritagedigital/Cindymill/6.35mm_Lasercut_Steel_Version/Spacers/2x_Cindymill_Steel_Spacer_Frame_Motor.stl

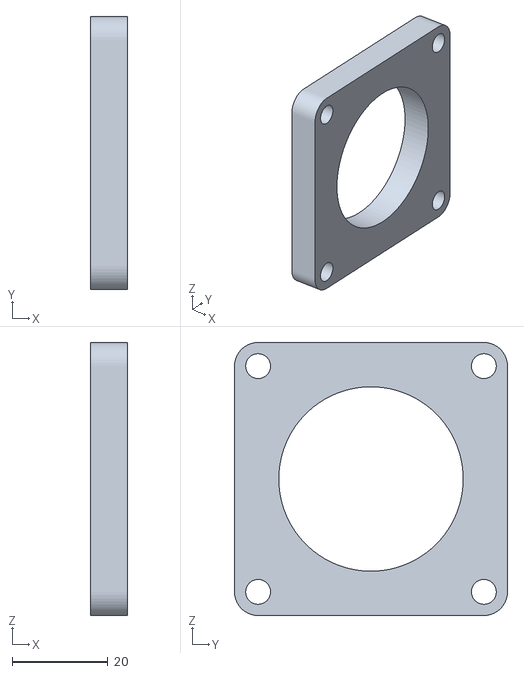
[picture p61: CAD file, 2022-01-19]
6.35mm_Lasercut_Steel_Version/Spacers/2x_Cindymill_Steel_Spacer_Frame_Motor.stl
7.65 x 57.0 x 57.0
