culturalheritagedigital/Cindymill/6mm_Lasercut_Steel_Version/Lasercut_Plates/Portal/1x_Cindymill_Steel_Portal_Block_Plate_6mm.dxf

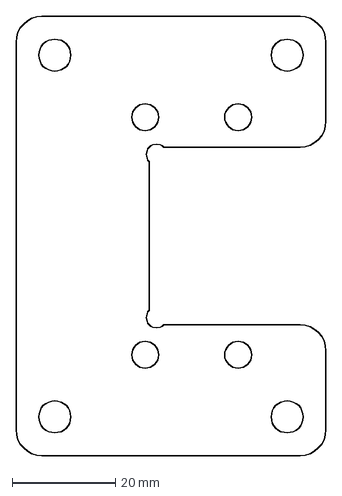
[picture p62: CAD file, 2021-10-28]
6mm_Lasercut_Steel_Version/Lasercut_Plates/Portal/1x_Cindymill_Steel_Portal_Block_Plate_6mm.dxf
60.0 x 85.0 mm
