culturalheritagedigital/Cindymill/Accessories/Cable_Chain/Cindymill_ZAxis_CableChain_Holder.step

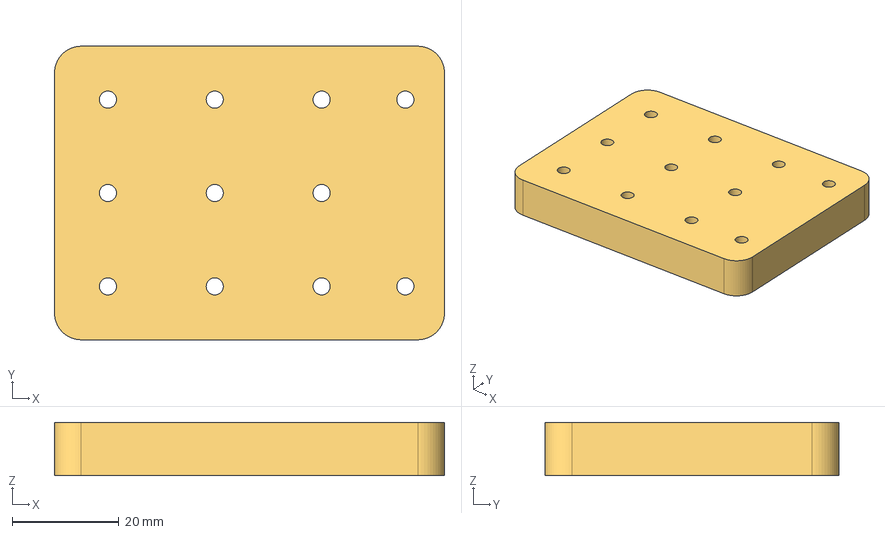
[picture p64: CAD file, 2021-09-26]
Accessories/Cable_Chain/Cindymill_ZAxis_CableChain_Holder.step
73.0 x 55.0 x 10.0 mm
