culturalheritagedigital/Cindymill/Accessories/Limit_Switch/Cindymill_LimitSwitchHolder_Z_Axis.stl

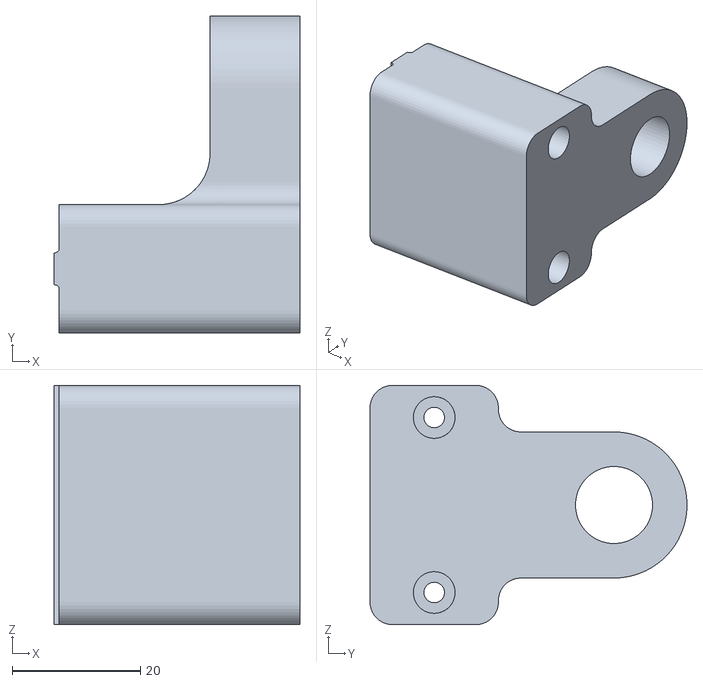
[picture p65: CAD file, 2021-09-26]
Accessories/Limit_Switch/Cindymill_LimitSwitchHolder_Z_Axis.stl
38.3 x 49.4 x 37.2
