culturalheritagedigital/Cindymill/Accessories/Vacuum_Cleaner/Cindymill_Vacuum_Cleaner_Holder_1.5kW_Spindle.step

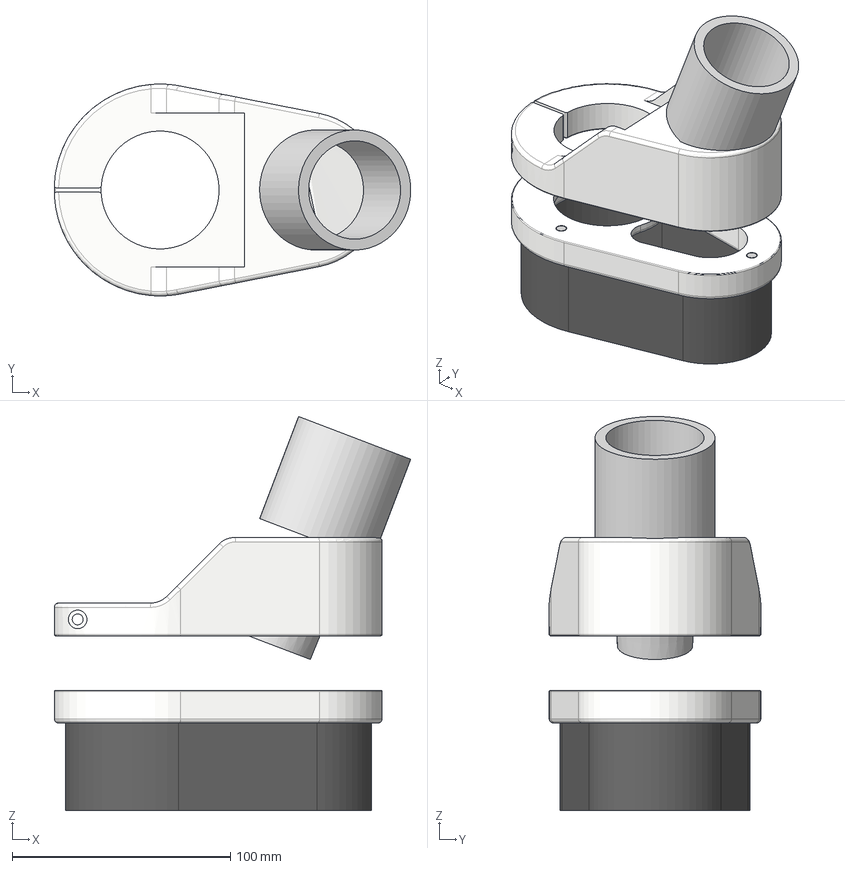
[picture p66: CAD file, 2021-09-26]
Accessories/Vacuum_Cleaner/Cindymill_Vacuum_Cleaner_Holder_1.5kW_Spindle.step
163.2 x 97.0 x 180.4 mm
Sauger
Absaugung_Oberteil
Absaugung_Unterteil
