culturalheritagedigital/Cindymill/model/10mm_Milled_Aluminum_Version/Milled_Plates/Portal/1x_Cindymill_Aluminum_Portal_Motor_Spacer_10mm.dxf

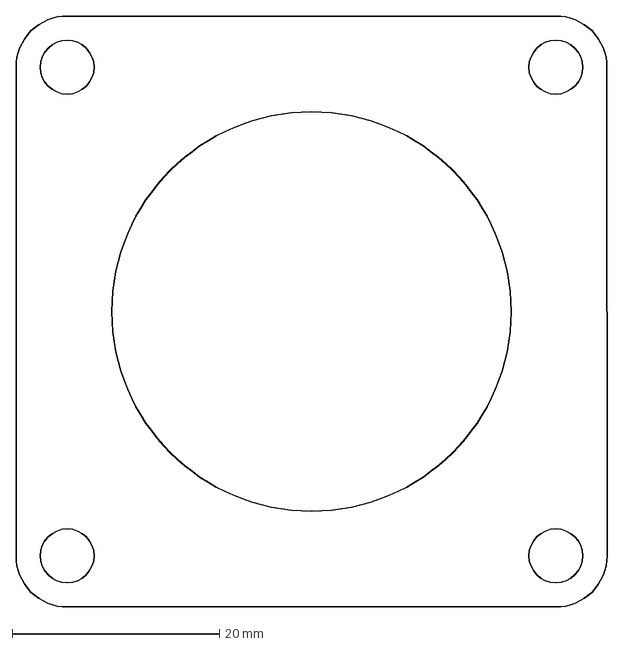
[picture p67: CAD file, 2021-07-19]
model/10mm_Milled_Aluminum_Version/Milled_Plates/Portal/1x_Cindymill_Aluminum_Portal_Motor_Spacer_10mm.dxf
57.0 x 57.0 mm
