culturalheritagedigital/Cindymill/model/10mm_Milled_Aluminum_Version/Milled_Plates/ZAxis/1x_Cindymill_Aluminum_Z_Axis_Spindle_Plate_10mm.dxf

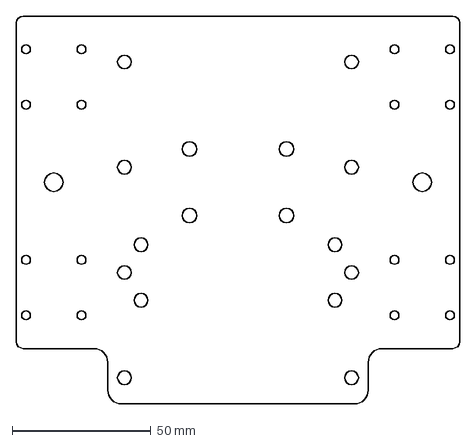
[picture p68: CAD file, 2021-07-19]
model/10mm_Milled_Aluminum_Version/Milled_Plates/ZAxis/1x_Cindymill_Aluminum_Z_Axis_Spindle_Plate_10mm.dxf
160.0 x 140.0 mm
