culturalheritagedigital/Cindymill/model/10mm_Milled_Aluminum_Version/Spacers/8x_Z_Axis_Frame_Spacer.stl

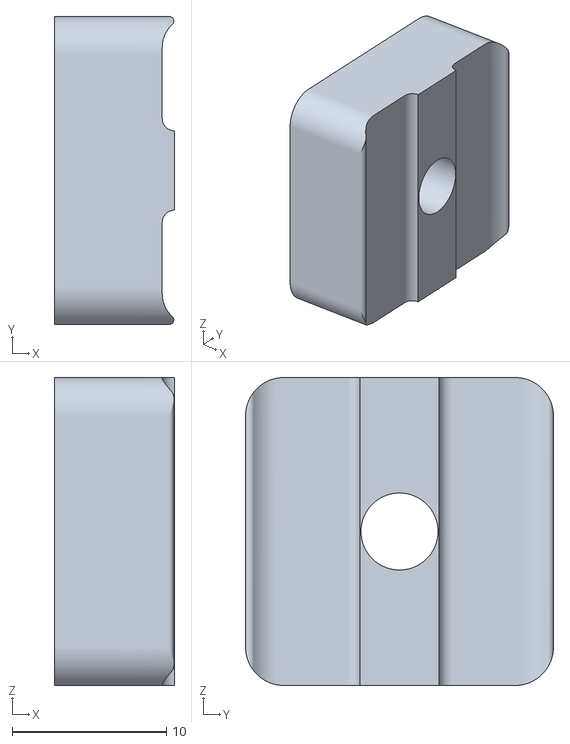
[picture p69: CAD file, 2021-07-06]
model/10mm_Milled_Aluminum_Version/Spacers/8x_Z_Axis_Frame_Spacer.stl
7.80 x 20.0 x 20.0
