culturalheritagedigital/Cindymill/model/6.35mm_Lasercut_Steel_Version/Lasercut_Plates/Portal/1x_Cindymill_Steel_Portal_Block_Plate_6.35mm.dxf

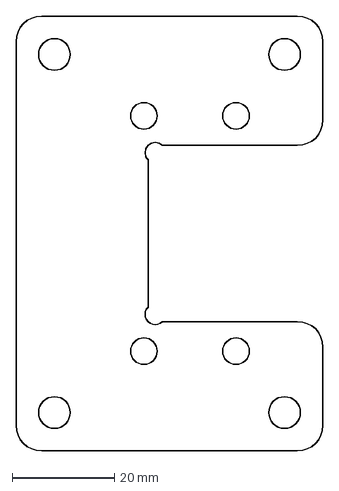
[picture p70: CAD file, 2022-01-19]
model/6.35mm_Lasercut_Steel_Version/Lasercut_Plates/Portal/1x_Cindymill_Steel_Portal_Block_Plate_6.35mm.dxf
60.0 x 85.0 mm
