culturalheritagedigital/Cindymill/model/6.35mm_Lasercut_Steel_Version/Lasercut_Plates/ZAxis/1x_Cindymill_Steel_Z_Axis_Backplate_6.35mm.dxf

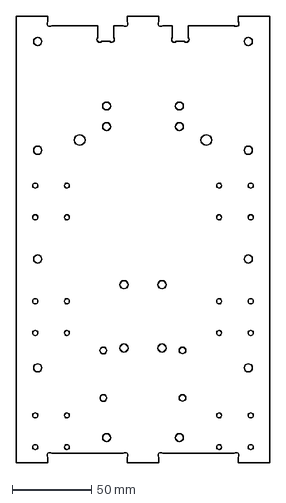
[picture p71: CAD file, 2022-01-19]
model/6.35mm_Lasercut_Steel_Version/Lasercut_Plates/ZAxis/1x_Cindymill_Steel_Z_Axis_Backplate_6.35mm.dxf
160.0 x 282.0 mm
