culturalheritagedigital/Cindymill/model/6.35mm_Lasercut_Steel_Version/Spacers/1x_Cindymill_Steel_Spacer_Portal_Motor.stl

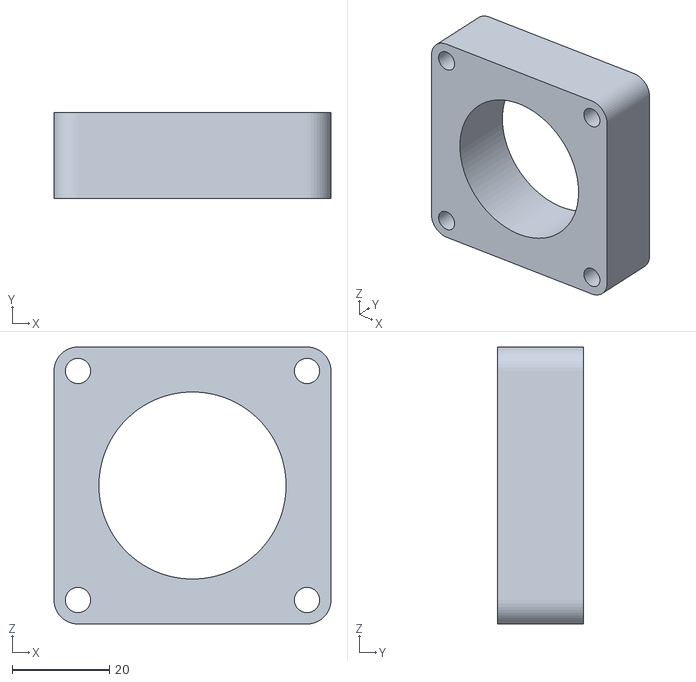
[picture p72: CAD file, 2022-01-19]
model/6.35mm_Lasercut_Steel_Version/Spacers/1x_Cindymill_Steel_Spacer_Portal_Motor.stl
57.0 x 17.7 x 57.0
