culturalheritagedigital/Cindymill/model/6mm_Lasercut_Steel_Version/Lasercut_Plates/ZAxis/1x_Cindymill_Steel_Z_Axis_Spindle_Plate2_6mm.dxf

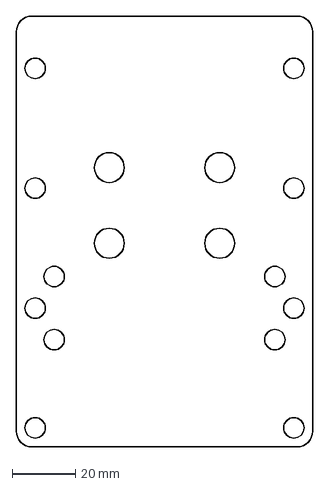
[picture p73: CAD file, 2021-10-28]
model/6mm_Lasercut_Steel_Version/Lasercut_Plates/ZAxis/1x_Cindymill_Steel_Z_Axis_Spindle_Plate2_6mm.dxf
94.0 x 136.6 mm
