culturalheritagedigital/Cindymill/model/Tools/Cindymill_Dial_Indicator_Plate_Connection.stl

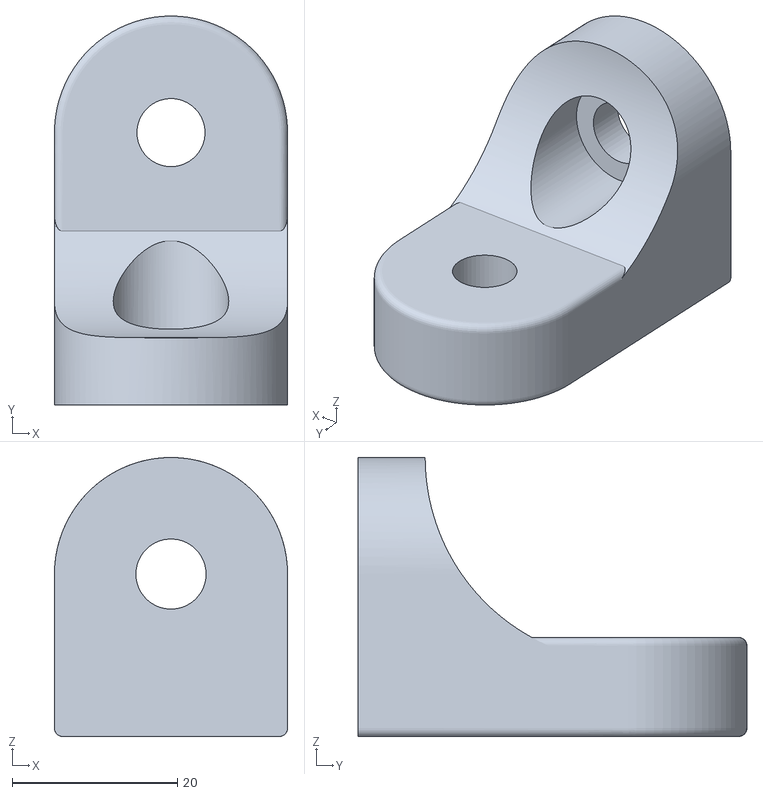
[picture p74: CAD file, 2021-09-18]
model/Tools/Cindymill_Dial_Indicator_Plate_Connection.stl
28.2 x 47.1 x 33.8
