culturalheritagedigital/Cindymill/Tools/Cindymill_MGN12_M8_Holder.stl

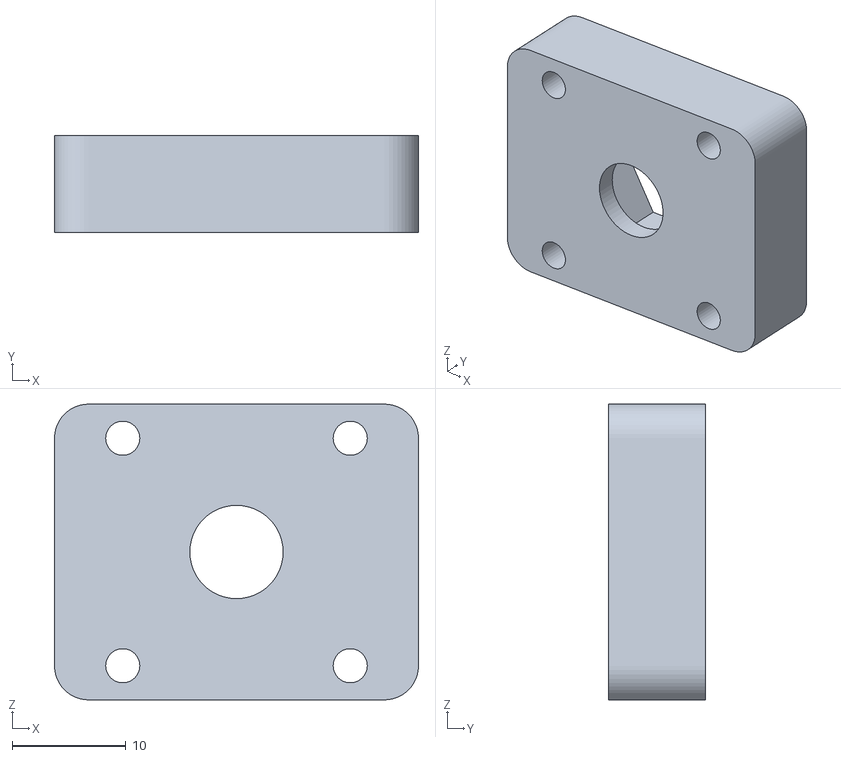
[picture p75: CAD file, 2021-09-18]
Tools/Cindymill_MGN12_M8_Holder.stl
32.0 x 8.50 x 26.0
