culturalheritagedigital/Cindymill/10mm_Milled_Aluminum_Version/Milled_Plates/Frame/1x_Cindymill_Aluminum_Frame_Block_Plate_L_10mm.dxf

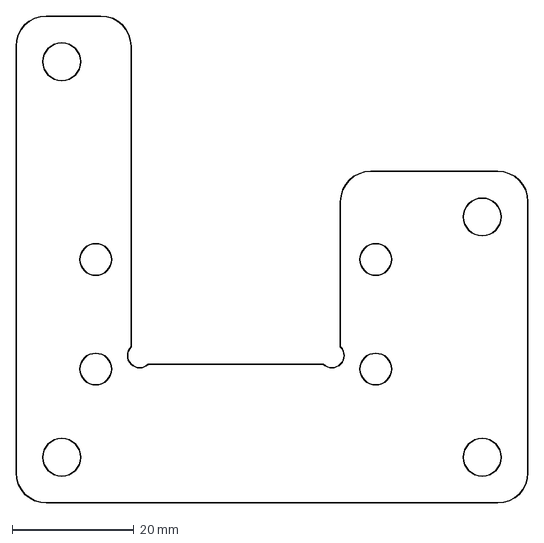
[picture p76: CAD file, 2021-07-19]
10mm_Milled_Aluminum_Version/Milled_Plates/Frame/1x_Cindymill_Aluminum_Frame_Block_Plate_L_10mm.dxf
84.1 x 80.0 mm
