culturalheritagedigital/Cindymill/10mm_Milled_Aluminum_Version/Milled_Plates/Portal/2x_Cindymill_Aluminum_Portal_Sideplate_Spacer_5-0mm.dxf

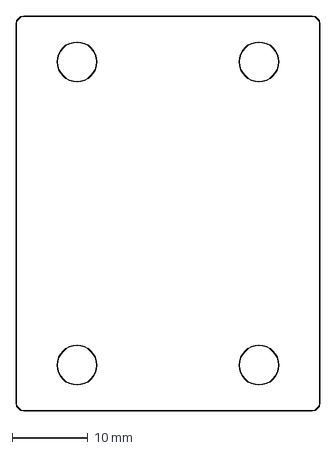
[picture p77: CAD file, 2021-07-19]
10mm_Milled_Aluminum_Version/Milled_Plates/Portal/2x_Cindymill_Aluminum_Portal_Sideplate_Spacer_5-0mm.dxf
40.0 x 52.0 mm
