culturalheritagedigital/Cindymill/10mm_Milled_Aluminum_Version/Milled_Plates/ZAxis/1x_Cindymill_Aluminum_Z_Axis_Backplate_10mm.dxf

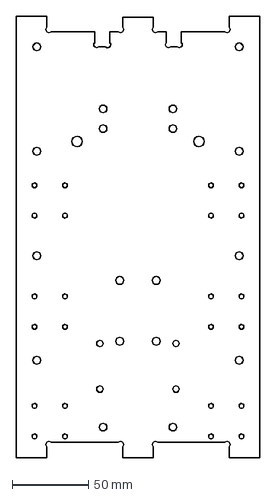
[picture p78: CAD file, 2021-07-19]
10mm_Milled_Aluminum_Version/Milled_Plates/ZAxis/1x_Cindymill_Aluminum_Z_Axis_Backplate_10mm.dxf
160.0 x 290.0 mm
