culturalheritagedigital/Cindymill/10mm_Milled_Aluminum_Version/Spacers/2x_Cindymill_Portal_Sideplate_Spacer_5-0mm.stl

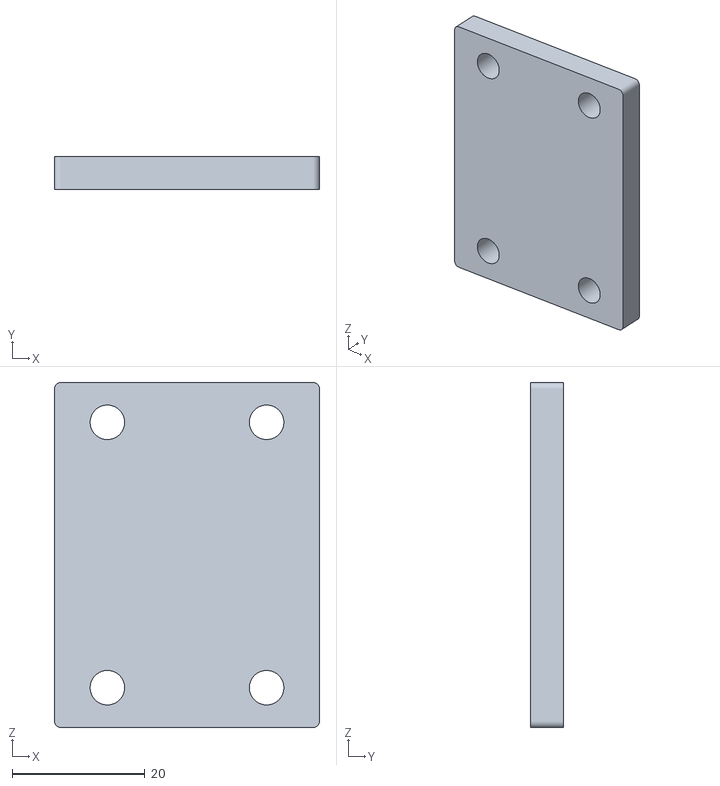
[picture p79: CAD file, 2021-07-12]
10mm_Milled_Aluminum_Version/Spacers/2x_Cindymill_Portal_Sideplate_Spacer_5-0mm.stl
40.0 x 5.00 x 52.0
