culturalheritagedigital/Cindymill/6.35mm_Lasercut_Steel_Version/Lasercut_Plates/Frame/2x_Cindymill_Steel_Frame_Block_Plate_6.35mm.dxf

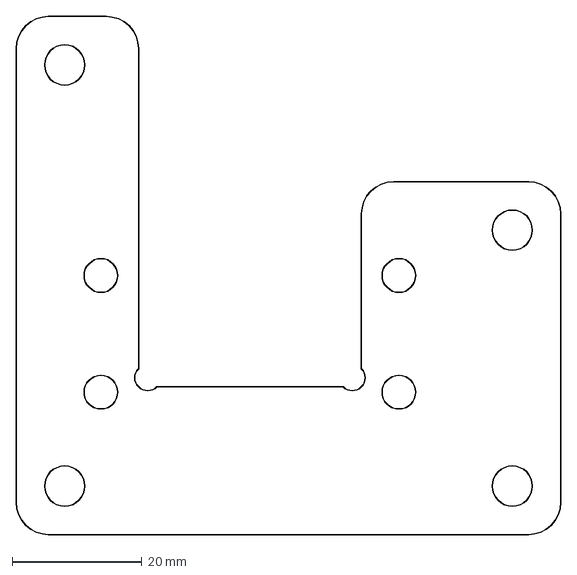
[picture p80: CAD file, 2021-10-28]
6.35mm_Lasercut_Steel_Version/Lasercut_Plates/Frame/2x_Cindymill_Steel_Frame_Block_Plate_6.35mm.dxf
84.1 x 80.0 mm
