culturalheritagedigital/Cindymill/6mm_Lasercut_Steel_Version/Lasercut_Plates/ZAxis/1x_Cindymill_Steel_Z_Axis_Topplate_6mm.dxf

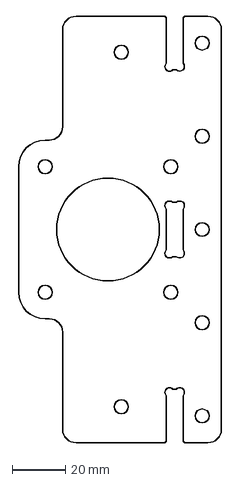
[picture p82: CAD file, 2021-10-28]
6mm_Lasercut_Steel_Version/Lasercut_Plates/ZAxis/1x_Cindymill_Steel_Z_Axis_Topplate_6mm.dxf
76.0 x 160.0 mm
