culturalheritagedigital/Cindymill/Accessories/Cable_Chain/Cindymill_Cable_Chain_Fixature.stl

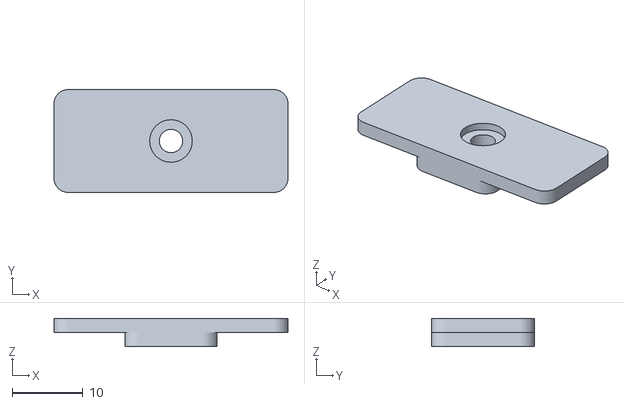
[picture p83: CAD file, 2021-09-26]
Accessories/Cable_Chain/Cindymill_Cable_Chain_Fixature.stl
33.0 x 14.5 x 4.00
