culturalheritagedigital/Cindymill/Accessories/Limit_Switch/Cindymill_LimitSwitchHolder_X_Y_Axis.stl

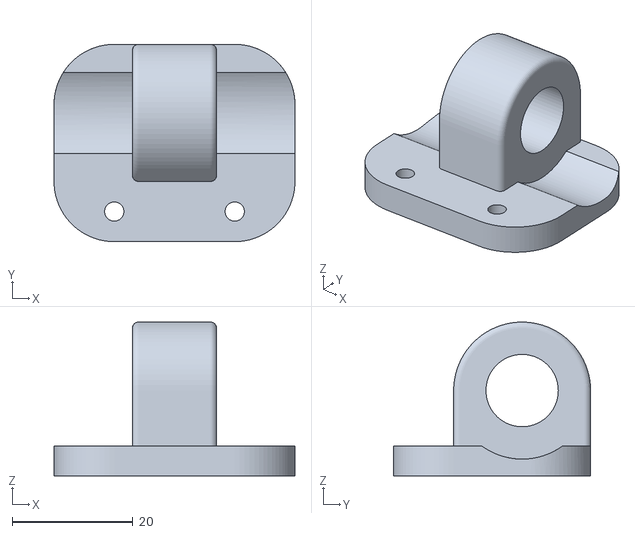
[picture p84: CAD file, 2021-09-26]
Accessories/Limit_Switch/Cindymill_LimitSwitchHolder_X_Y_Axis.stl
40.0 x 32.8 x 25.5
