culturalheritagedigital/Cindymill/Accessories/Vacuum_Cleaner/Cindymill_Vacuum_Holder_Top.stl

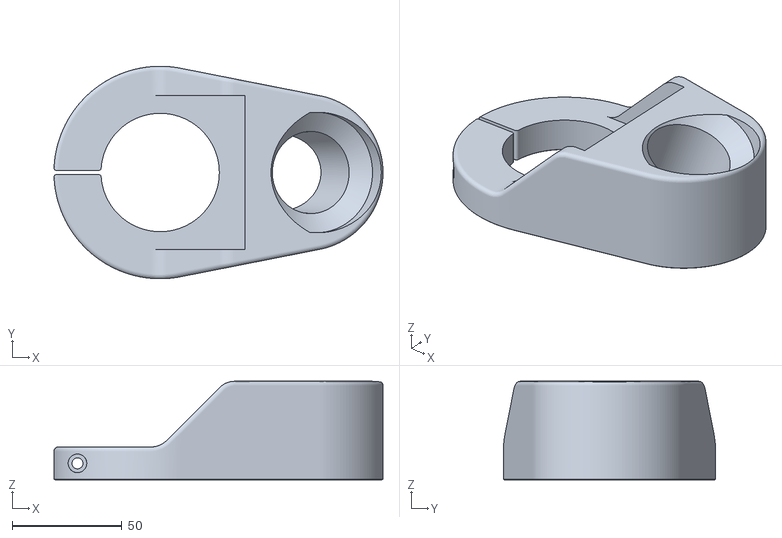
[picture p85: CAD file, 2021-09-26]
Accessories/Vacuum_Cleaner/Cindymill_Vacuum_Holder_Top.stl
150.2 x 97.0 x 45.0
