culturalheritagedigital/Cindymill/Tools/Cindymill_Z_Axis_Rail_Alignment_Tool.stl

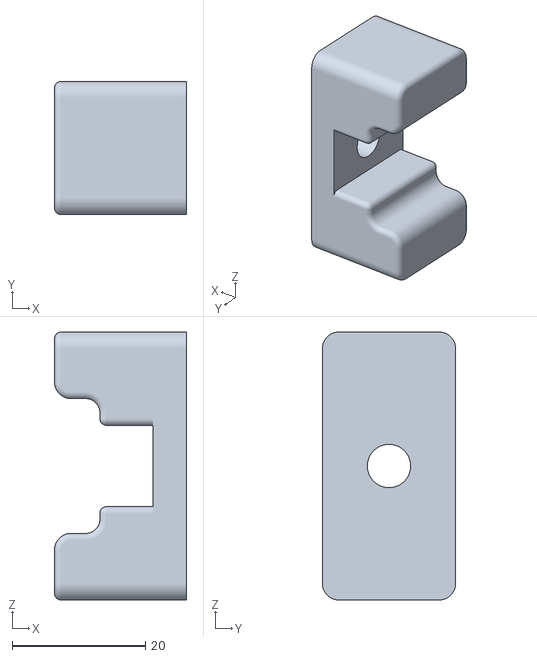
[picture p87: CAD file, 2021-07-12]
Tools/Cindymill_Z_Axis_Rail_Alignment_Tool.stl
19.8 x 20.0 x 40.2
