culturalheritagedigital/Cindymill/10mm_Milled_Aluminum_Version/Milled_Plates/Portal/1x_Cindymill_Aluminum_Portal_Block_Plate_10mm.dxf

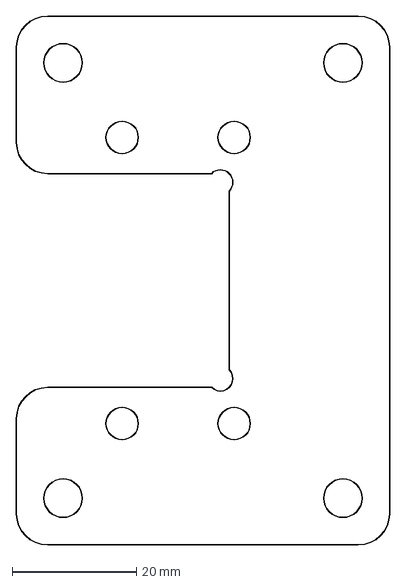
[picture p89: CAD file, 2021-07-19]
10mm_Milled_Aluminum_Version/Milled_Plates/Portal/1x_Cindymill_Aluminum_Portal_Block_Plate_10mm.dxf
60.0 x 85.0 mm
