culturalheritagedigital/Cindymill/10mm_Milled_Aluminum_Version/Milled_Plates/ZAxis/1x_Cindymill_Aluminum_Z_Axis_Motor_Spacer_5mm.dxf

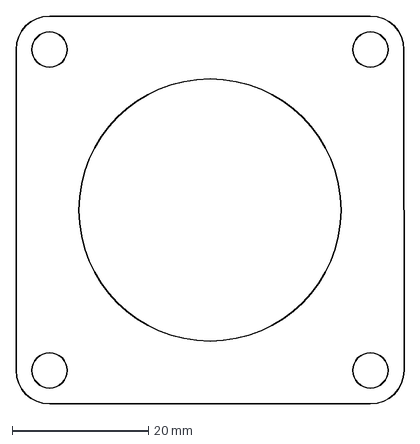
[picture p90: CAD file, 2021-07-19]
10mm_Milled_Aluminum_Version/Milled_Plates/ZAxis/1x_Cindymill_Aluminum_Z_Axis_Motor_Spacer_5mm.dxf
57.0 x 57.0 mm
