culturalheritagedigital/Cindymill/6.35mm_Lasercut_Steel_Version/Lasercut_Plates/ZAxis/1x_Cindymill_Steel_Z_Axis_Bottomplate_6.35mm.dxf

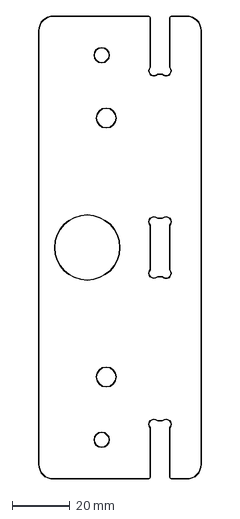
[picture p92: CAD file, 2022-01-19]
6.35mm_Lasercut_Steel_Version/Lasercut_Plates/ZAxis/1x_Cindymill_Steel_Z_Axis_Bottomplate_6.35mm.dxf
56.0 x 160.0 mm
