culturalheritagedigital/Cindymill/6.35mm_Lasercut_Steel_Version/Spacers/1x_Cindymill_Steel_Spacer_ZAxis_Motor.stl

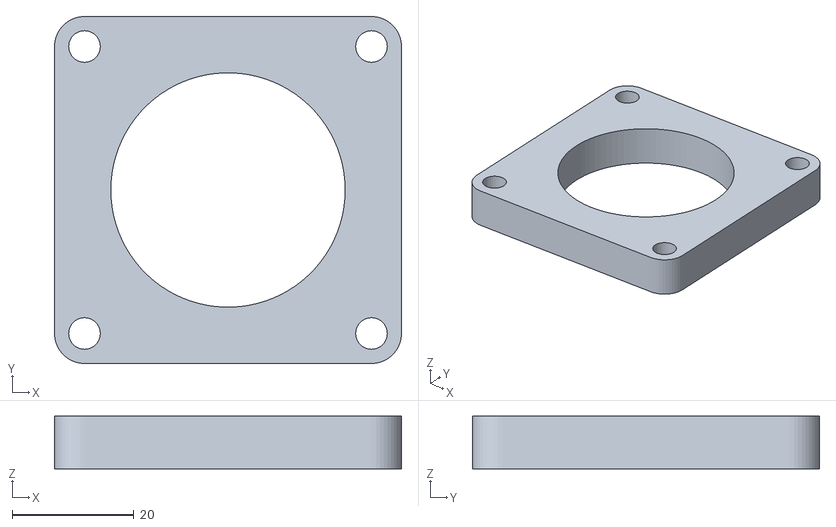
[picture p93: CAD file, 2022-01-19]
6.35mm_Lasercut_Steel_Version/Spacers/1x_Cindymill_Steel_Spacer_ZAxis_Motor.stl
57.0 x 57.0 x 8.65
