culturalheritagedigital/Cindymill/6mm_Lasercut_Steel_Version/Lasercut_Plates/ZAxis/1x_Cindymill_Steel_Z_Axis_Backplate_6mm.dxf

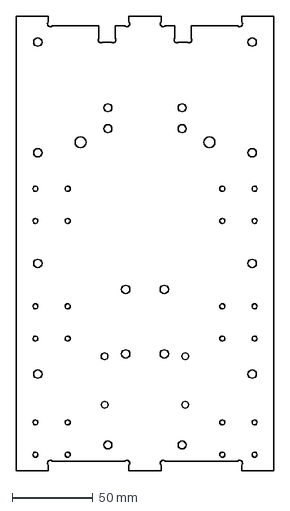
[picture p94: CAD file, 2021-10-28]
6mm_Lasercut_Steel_Version/Lasercut_Plates/ZAxis/1x_Cindymill_Steel_Z_Axis_Backplate_6mm.dxf
160.0 x 282.0 mm
