culturalheritagedigital/Cindymill/Accessories/Vacuum_Cleaner/Cindymill_Vacuum_Holder_Bottom.stl

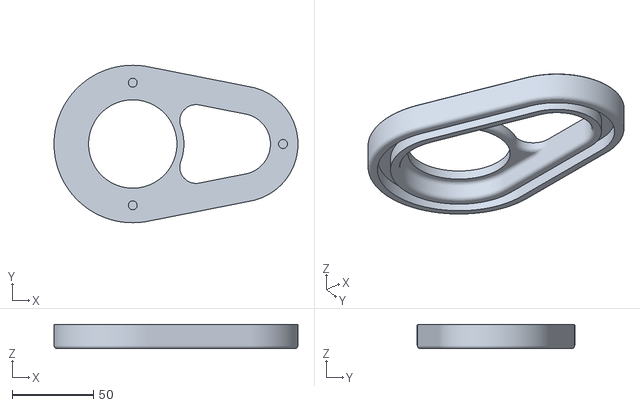
[picture p95: CAD file, 2021-09-26]
Accessories/Vacuum_Cleaner/Cindymill_Vacuum_Holder_Bottom.stl
150.2 x 97.0 x 15.0
