culturalheritagedigital/Cindymill/Tools/Cindymill_Portal_Rail_Alignment_Tool.stl

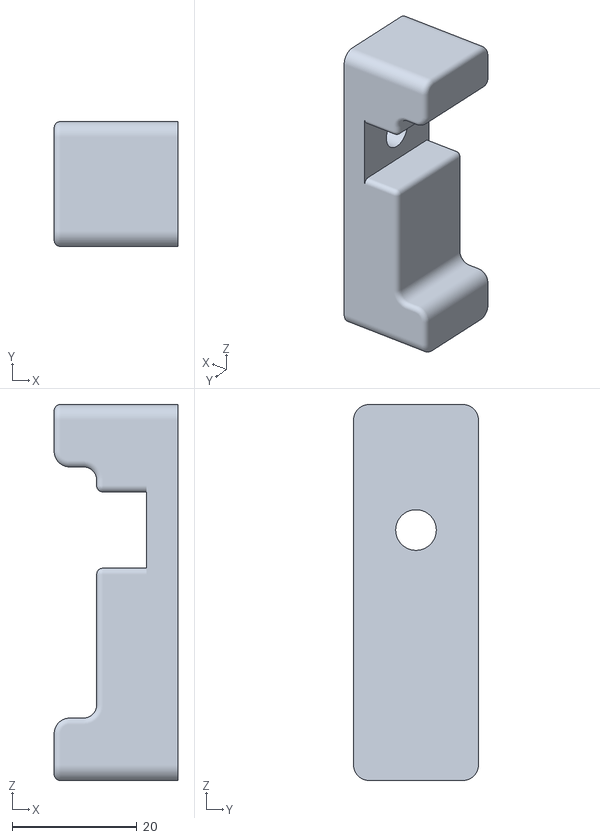
[picture p96: CAD file, 2021-07-12]
Tools/Cindymill_Portal_Rail_Alignment_Tool.stl
19.8 x 20.0 x 60.2
