culturalheritagedigital/Cindymill/10mm_Milled_Aluminum_Version/Milled_Plates/Portal/1x_Cindymill_Aluminum_Portal_Backplate_5-10mm.dxf

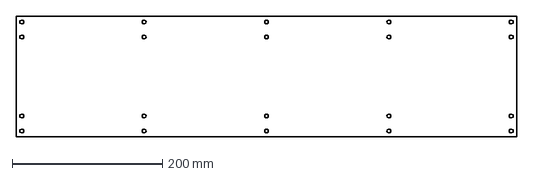
[picture p98: CAD file, 2021-07-19]
10mm_Milled_Aluminum_Version/Milled_Plates/Portal/1x_Cindymill_Aluminum_Portal_Backplate_5-10mm.dxf
666.0 x 160.0 mm
