culturalheritagedigital/Cindymill/10mm_Milled_Aluminum_Version/Spacers/1x_Cindymill_Portal_Motor_Spacer_10mm.stl

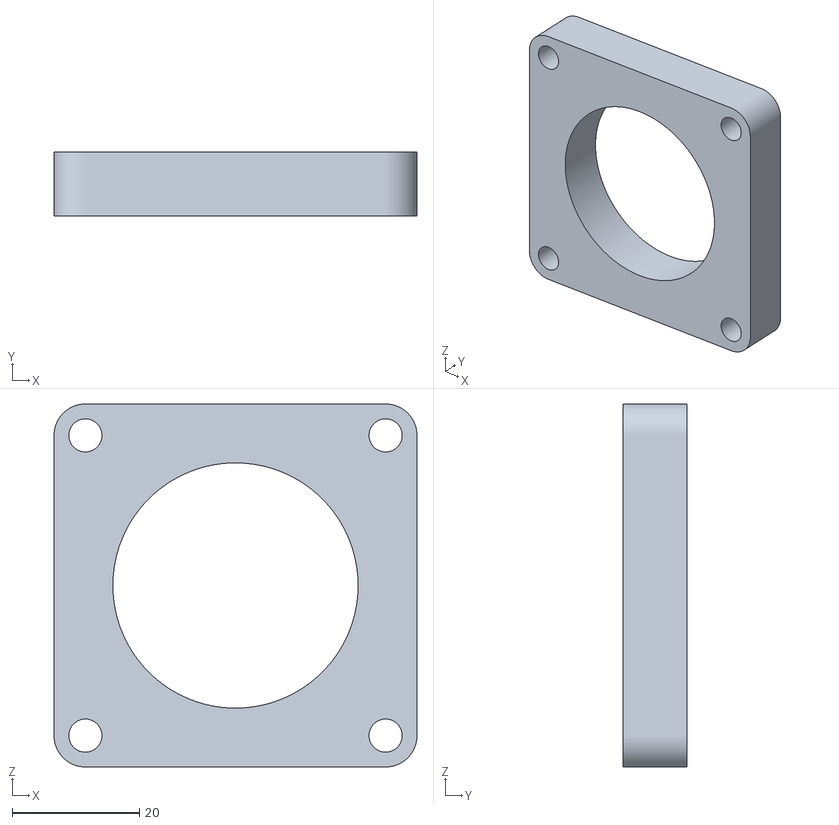
[picture p100: CAD file, 2021-07-12]
10mm_Milled_Aluminum_Version/Spacers/1x_Cindymill_Portal_Motor_Spacer_10mm.stl
57.0 x 10.0 x 57.0
