culturalheritagedigital/Cindymill/6.35mm_Lasercut_Steel_Version/Lasercut_Plates/ZAxis/1x_Cindymill_Steel_Z_Axis_Spindle_Plate2_6.35mm.dxf

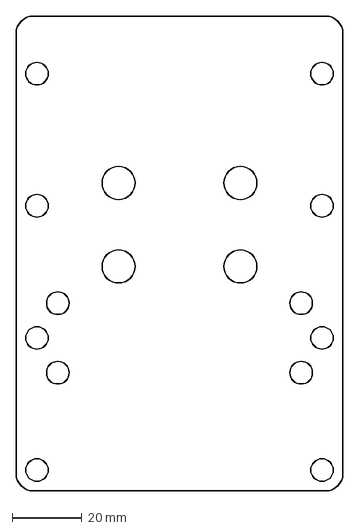
[picture p101: CAD file, 2022-01-19]
6.35mm_Lasercut_Steel_Version/Lasercut_Plates/ZAxis/1x_Cindymill_Steel_Z_Axis_Spindle_Plate2_6.35mm.dxf
94.0 x 136.6 mm
