culturalheritagedigital/Cindymill/6mm_Lasercut_Steel_Version/Lasercut_Plates/ZAxis/1x_Cindymill_Steel_Z_Axis_Spindle_Plate1_6mm.dxf

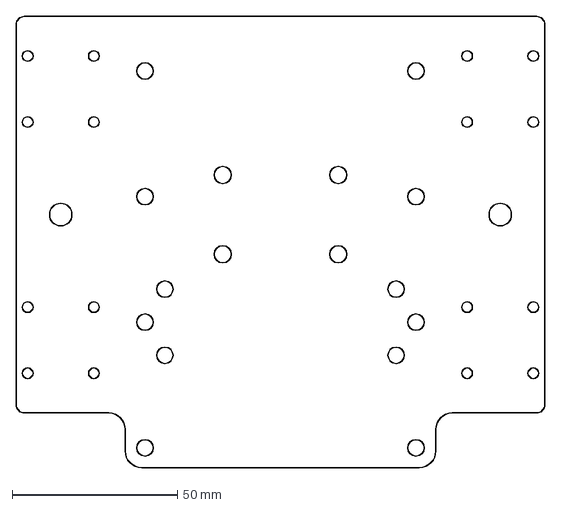
[picture p102: CAD file, 2021-10-28]
6mm_Lasercut_Steel_Version/Lasercut_Plates/ZAxis/1x_Cindymill_Steel_Z_Axis_Spindle_Plate1_6mm.dxf
160.0 x 136.6 mm
