culturalheritagedigital/Cindymill/10mm_Milled_Aluminum_Version/Milled_Plates/ZAxis/1x_Cindymill_Aluminum_Z_Axis_Bottomplate_10mm.dxf

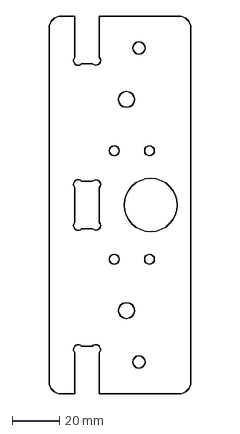
[picture p105: CAD file, 2021-07-19]
10mm_Milled_Aluminum_Version/Milled_Plates/ZAxis/1x_Cindymill_Aluminum_Z_Axis_Bottomplate_10mm.dxf
60.0 x 160.0 mm
