culturalheritagedigital/Cindymill/10mm_Milled_Aluminum_Version/Spacers/1x_Cindymill_Z_Axis_Spindle_Plate_Spacer_3mm.stl

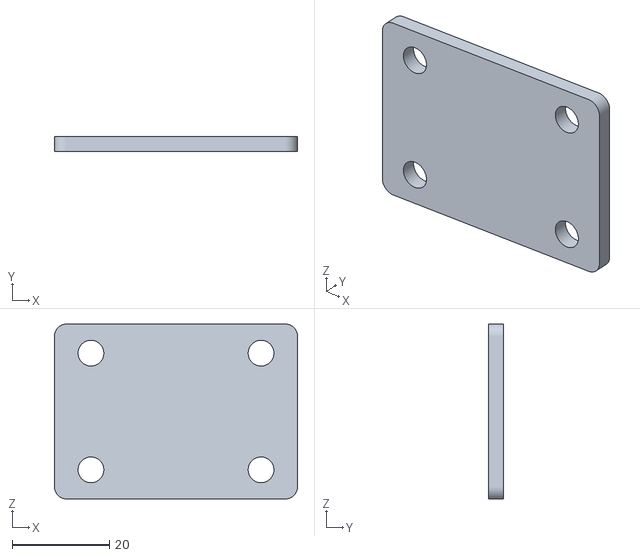
[picture p106: CAD file, 2021-07-12]
10mm_Milled_Aluminum_Version/Spacers/1x_Cindymill_Z_Axis_Spindle_Plate_Spacer_3mm.stl
50.0 x 3.00 x 36.0
