culturalheritagedigital/Cindymill/10mm_Milled_Aluminum_Version/Milled_Plates/Portal/1x_Cindymill_Aluminum_Portal_Sideplate_L_10-15mm.dxf

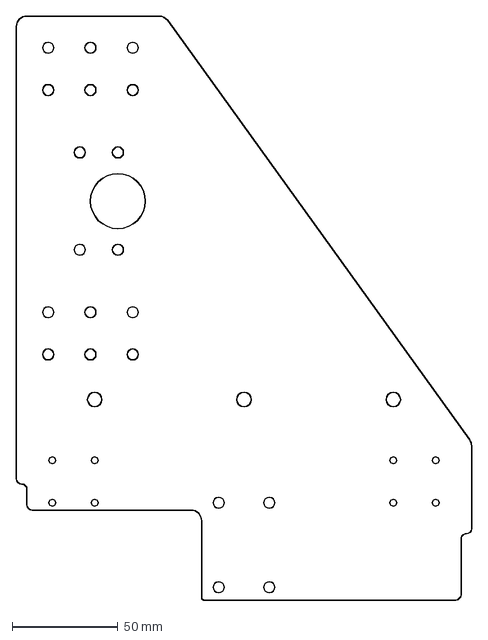
[picture p108: CAD file, 2021-07-19]
10mm_Milled_Aluminum_Version/Milled_Plates/Portal/1x_Cindymill_Aluminum_Portal_Sideplate_L_10-15mm.dxf
215.2 x 276.1 mm
