culturalheritagedigital/Cindymill/(list of files, cad)

Other CAD files:
6mm_Lasercut_Steel_Version/Spacers/1x_Cindymill_Steel_Spacer_Portal_Motor.stl
6.35mm_Lasercut_Steel_Version/Spacers/1x_Cindymill_Steel_Spacer_ZAxis_Spindelplate.stl
6.35mm_Lasercut_Steel_Version/Spacers/8x_Cindymill_Steel_Spacer_ZAxis_Frame.stl
10mm_Milled_Aluminum_Version/Milled_Plates/Portal/1x_Cindymill_Aluminum_Portal_Nut_Spacer_10mm.dxf
10mm_Milled_Aluminum_Version/Spacers/1x_Cindymill_Portal_Nut_Spacer_10mm.stl
6.35mm_Lasercut_Steel_Version/Spacers/1x_Cindymill_Steel_Spacer_ZAxis_Ballscrew.stl
6.35mm_Lasercut_Steel_Version/Spacers/2x_Cindymill_Steel_Spacer_Portal_Ballscrew.stl
6mm_Lasercut_Steel_Version/Spacers/1x_Cindymill_Steel_Spacer_ZAxis_Motor.stl
6mm_Lasercut_Steel_Version/Spacers/2x_Cindymill_Steel_Spacer_Frame_Motor.stl
6mm_Lasercut_Steel_Version/Spacers/2x_Cindymill_Steel_Spacer_Portal_Ballscrew.stl
model/Accessories/Cable_Chain/Cindymill_ZAxis_CableChain_Holder.stl
