culturalheritagedigital/Cindymill/assets/images/assembly/assembly_frame0.jpg

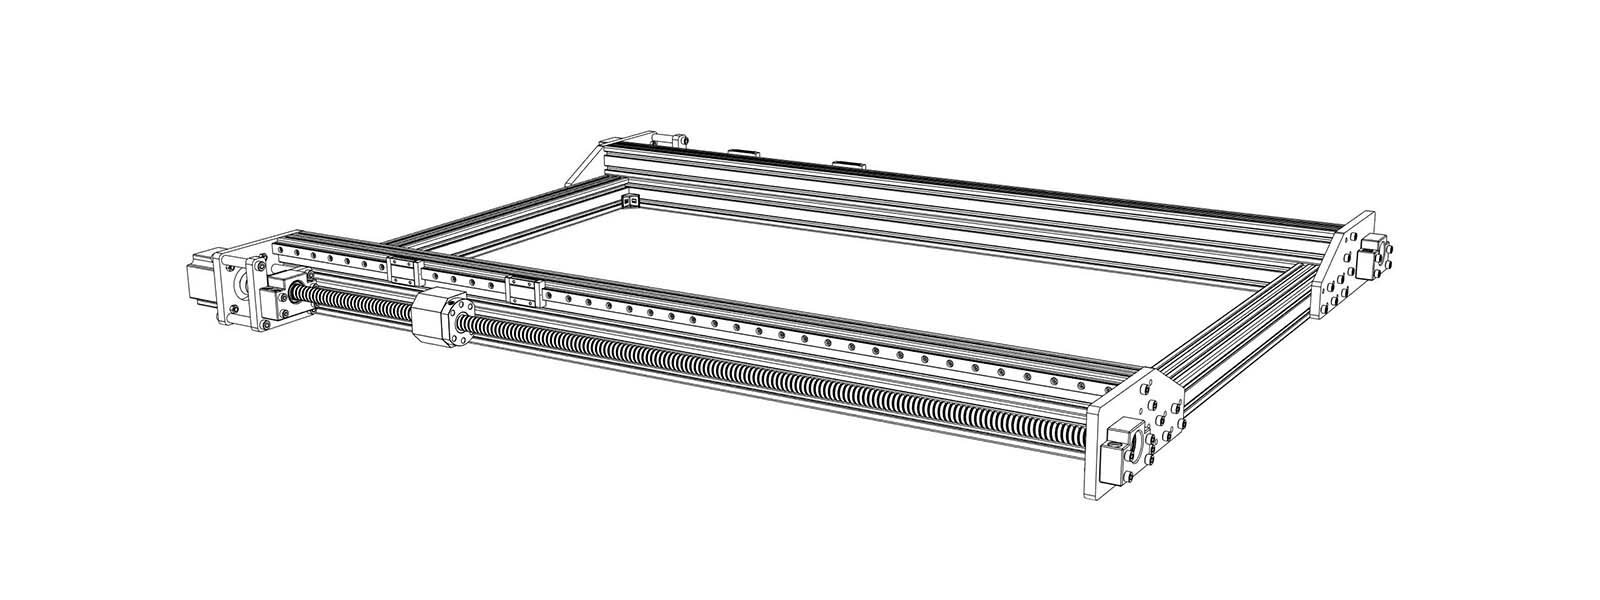
assets/images/assembly/assembly_frame0.jpg
