culturalheritagedigital/Cindymill/assets/images/assembly/assembly_zaxis0.jpg

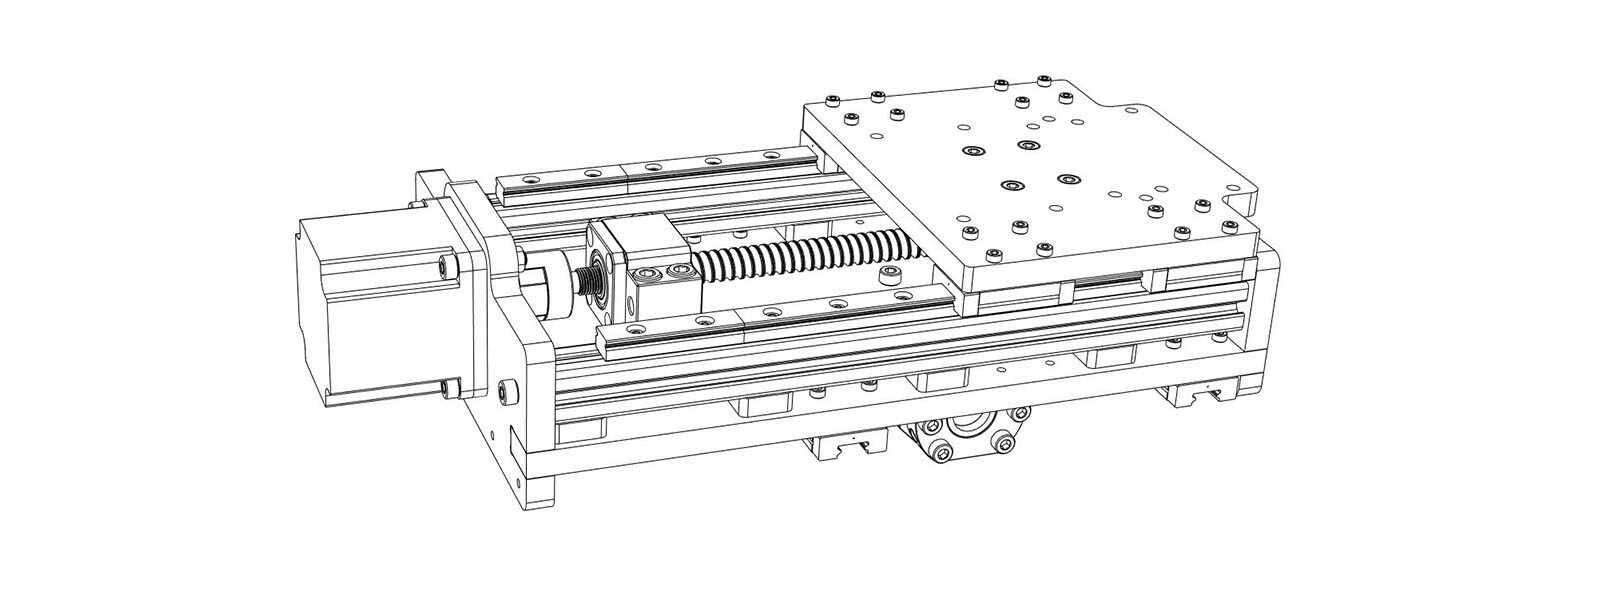
assets/images/assembly/assembly_zaxis0.jpg
