culturalheritagedigital/Cindymill/assets/images/soldering.jpg

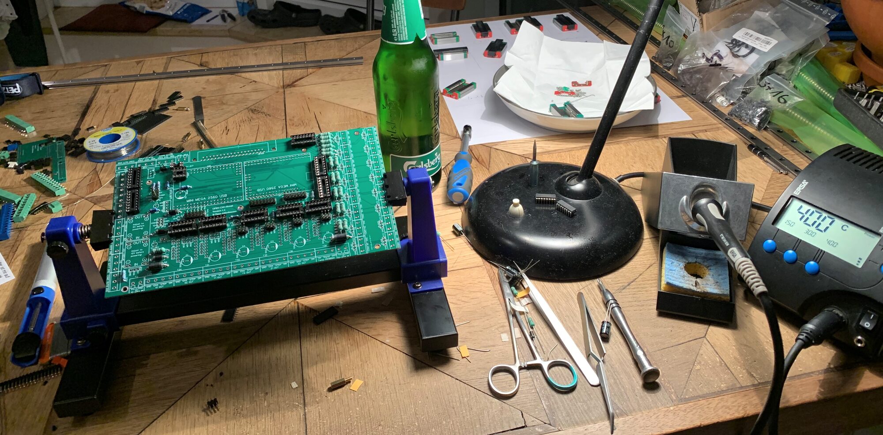
assets/images/soldering.jpg
