culturalheritagedigital/Cindymill/(threads)

Thread 1 (2022-11-15):

Incorrect limit switch holder step files

alw1746, 2022-11-15:
I think the STEP files for XY and Z axis limit switch holders refer to spindle mounts. See attached pics. The STL files are fine.
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

alw1746, 2022-11-16:
Ah right, had no idea they looked like that. Thanks.

Closed 2022-11-16.
