culturalheritagedigital/Cindymill/(commit log)

2021-07-12 Uploaded more printable parts
    [1x_Cindymill_Portal_Motor_Spacer_10mm.stl, 1x_Cindymill_Portal_Nut_Spacer_10mm.stl, 1x_Cindymill_Z_Axis_Motor_Spacer_5mm.stl, 1x_Cindymill_Z_Axis_Spindle_Plate_Spacer_3mm.stl, 2x_Cindymill_Portal_Sideplate_Spacer_5-0mm.stl, Cindymill_Portal_Rail_Alignment_Tool.stl, Cindymill_Z_Axis_Rail_Alignment_Tool.stl]
2021-07-16 Update DXF FIles
    [1x_CIndymill_Z_Axis_Spindle_Plate_10mm.dxf, 1x_Cindymill_Frame_Block_Plate_L_10mm.dxf, 1x_Cindymill_Frame_Block_Plate_R_10mm.dxf, 1x_Cindymill_Frame_Plate_L_B_10mm.dxf, 1x_Cindymill_Frame_Plate_R_B_10mm.dxf, 1x_Cindymill_Portal_Backplate_5-10mm.dxf, 1x_Cindymill_Portal_Block_Plate_10mm.dxf, 1x_Cindymill_Portal_Motor_Spacer_10mm.dxf]
2021-09-26 Created "Addons" section
    [CIndymill_LimitSwitchHolder_Z_Axis.stl, Cindymill_LimitSwitchHolder_X_Y_Axis.stl]
2021-09-26 Created "Spacers" folder
    [1x_Cindymill_Portal_Motor_Spacer_10mm.stl, 1x_Cindymill_Portal_Nut_Spacer_10mm.stl, 1x_Cindymill_Z_Axis_Motor_Spacer_5mm.stl, 1x_Cindymill_Z_Axis_Spindle_Plate_Spacer_3mm.stl, 2x_Cindymill_Portal_Sideplate_Spacer_5-0mm.stl, 8x_Z_Axis_Frame_Spacer.stl]
2021-09-26 Rename Folders
    [Cindymill_LimitSwitchHolder_X_Y_Axis.stl, Cindymill_LimitSwitchHolder_Z_Axis.stl]
2021-09-26 Add stl files
    [Cindymill_Cable_Chain_Fixature.stl, Cindymill_Vacuum_Cleaner_Holder_1.5kW_Spindle.step, Cindymill_Vacuum_Holder_Bottom.stl, Cindymill_Vacuum_Holder_Top.stl, Cindymill_ZAxis_CableChain_Holder.step, Cindymill_ZAxis_CableChain_Holder.stl]
2021-10-28 Steel version added
    [1x_Cindymill_Aluminum_Frame_Block_Plate_L_10mm.dxf, 1x_Cindymill_Aluminum_Frame_Block_Plate_R_10mm.dxf, 1x_Cindymill_Aluminum_Frame_Plate_L_B_10mm.dxf, 1x_Cindymill_Aluminum_Frame_Plate_L_F_10mm.dxf, 1x_Cindymill_Aluminum_Frame_Plate_R_B_10mm.dxf, 1x_Cindymill_Aluminum_Frame_Plate_R_F_10mm.dxf, 1x_Cindymill_Aluminum_Portal_Backplate_5-10mm.dxf, 1x_Cindymill_Aluminum_Portal_Block_Plate_10mm.dxf]
2022-01-19 Added 1/4" steel version.
    [1x_Cindymill_Steel_Portal_Block_Plate_6.35mm.dxf, 1x_Cindymill_Steel_Portal_Sideplate_Left_6.35mm.dxf, 1x_Cindymill_Steel_Portal_Sideplate_Right_6.35mm.dxf, 1x_Cindymill_Steel_Spacer_Portal_Motor.stl, 1x_Cindymill_Steel_Spacer_ZAxis_Ballscrew.stl, 1x_Cindymill_Steel_Spacer_ZAxis_Motor.stl, 1x_Cindymill_Steel_Spacer_ZAxis_Spindelplate.stl, 1x_Cindymill_Steel_Z_Axis_Backplate_6.35mm.dxf]
2026-07-29 Modelldaten nach model/ verschieben
    Vorbereitung der Umwidmung: Das Repository nimmt künftig zusätzlich
    den Quellcode der Website auf, die von Ionos zu GitHub Pages umzieht.
    Damit der Repo-Root der Jekyll-Wurzel entspricht, wandern die fünf
    CAD-Ordner in den Unterordner model/. README.md, LICENSE und das
    Titelbild bleiben im Root.
2026-07-29 Website-Quellcode aufnehmen (Jekyll, ohne assets/)
    Quellcode der Website cindymill.xyz, die von Ionos zu GitHub Pages
    umzieht. Die Jekyll-Wurzel ist der Repo-Root; die Modelldaten unter
    model/ sowie README, LICENSE und das Titelbild sind in _config.yml
    per exclude: vom Build ausgenommen.
    assets/ (955 MB, davon 708 MB verwaist) fehlt bewusst noch und wird
    erst nach der Asset-Diaet (AP 1) aufgenommen, damit die verworfenen
    Dateien nicht dauerhaft in der Historie liegen.
2026-07-29 Planung auf Rev. 3 ziehen: Repo-Entscheidung und AP 0
    Die Website zieht in das bestehende Repo culturalheritagedigital/Cindymill
    statt in ein neues. Daraus folgen im Plan: baseurl /Cindymill statt
    /cindymill-website, exclude: fuer model/, angepasste Links in Impressum
    und README, zwei neue Risiken.
    AP 0 ist als erledigt dokumentiert; offen bleiben gh auth login und das
    Sichern der Ionos-Vertragsdaten.
    Ausserdem den Ionos-Serverpfad und Systembenutzernamen aus Abschnitt 1.5
    entfernt - das Dokument liegt jetzt in einem oeffentlichen Repository.
2026-07-29 AP 1: Asset-Diaet - 913 MB auf 62 MB
    - 340 verwaiste Dateien geloescht (708 MB), darunter alle 11 Videos
    (0 davon waren eingebunden) und Cindymill_Plates.zip.
    - Tote Entwuerfe _gallery_fancy.md und _about_us.md entfernt. Beide
    beginnen mit Unterstrich und wurden von Jekyll nie gebaut; ihre
    Asset-Referenzen haetten die Verwaisungspruefung verfaelscht.
    - 115 Bilder neu kodiert: Kantenlaenge max. 1600 px (Galerie) bzw.
    2000 px (Detailfotos), JPEG q82, EXIF entfernt, auto-orient vor dem
    Strippen. 183 MB eingespart. 40 Bilder blieben unveraendert, weil das
    Original bereits kleiner war als die Neukodierung.
    Referenzen wurden gegen das gebaute _site/ geprueft, inklusive
    site.webmanifes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
2026-07-29 Planung: AP 1 als erledigt dokumentiert
    Ergebniszahlen, die beiden verbliebenen Groessenhebel und zwei
    vorbestehende tote Links in gallery.md, die bei der Assetpruefung
    aufgefallen sind und in AP 2 gehoeren.
2026-07-29 AP 2: Asset-Pfade auf relative_url normalisieren
    - 172 Body-Referenzen in .md/.html auf {{ '...' | relative_url }} umgestellt
    - 75 davon hatten Windows-Backslashes (Galerie und CAD-Download waren live 404)
    - 27 Front-Matter-Pfade normalisiert (kein Liquid; die _includes wenden
    relative_url bereits selbst an)
    - 7 Favicon-Pfade in _includes/head.html
    - site.webmanifest und browserconfig.xml: Front Matter ergaenzt, Icon-Pfade
    auf relative_url (waeren unter /Cindymill/ still ins Leere gelaufen)
    - 17 interne Seitenlinks auf die tatsaechlich gebauten URLs gezogen
    - zwei tote Referenzen (milling1.mp4, stuff1.jpg) samt auskommentierter
    Bloecke entfernt
    - legal_notice.md: schemaloser Link www.c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
2026-07-29 AP 3: Toolchain aktualisieren, Theme vendorn
    - Gemfile.lock geloescht und auf macOS/arm64 neu aufgeloest (war x64-mingw32)
    - Jekyll auf ~> 4.4 gepinnt (4.4.1), jekyll-sass-converter ~> 3.0 (3.1.0,
    sass-embedded statt des auf Ruby 3.4 nicht baubaren sassc)
    - jekyll-algolia und wdm entfernt, html-proofer in Test-Gruppe ergaenzt
    - .ruby-version auf 3.4 gesetzt
    - Theme basically-basic 1.4.5 vendort: _layouts/ (12), _sass/ (80),
    assets/stylesheets/main.scss, assets/javascripts/main.js; theme:-Zeile
    und Theme-Gem entfernt, Gemspec-Artefakt geloescht
    - Suche entfernt (search: false): search/-Includes, search-form.html,
    _search.scss samt Import, Such-Bloecke in default.html und scripts.html;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
2026-07-29 AP 4: _config.yml und head.html modernisieren
    url/baseurl gesetzt (https://culturalheritagedigital.github.io + /Cindymill),
    damit canonical, og:url, og:image, sitemap.xml und robots.txt erstmals
    korrekt absolut sind.
    Aus head.html entfernt: MathJax (CDN seit 2017 abgeschaltet, http://),
    GA4-Tag G-6J78SX32JE, X-UA-Compatible, "cut the mustard"-Script (samt
    no-js-Klasse in default.html). eBay-Verifizierung: value= -> content=.
    Analytics restlos raus: google_analytics aus _config.yml und der
    Produktions-Block aus scripts.html; _includes/google-analytics.html
    gelöscht. Gegengeprüft mit JEKYLL_ENV=production - keine ID im Build.
    Fira Sans wird selbst ausgeliefert (assets/fonts/, 8 WOFF2 mit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
2026-07-29 AP 5: Datenschutz und Rechtstexte
    Rechtstext (legal_notice.md):
    - Google-Analytics-Abschnitt (Universal Analytics, _gat._anonymizeIp,
    Opt-out-Add-on) ersatzlos gestrichen - er beschrieb weder GA4 noch die
    Realitaet. Der technische Teil war schon in AP 4 entfernt.
    - LinkedIn-Abschnitt gestrichen: es ist keine LinkedIn-Komponente
    eingebunden, der Abschnitt war schlicht falsch. Facebook: nur
    gewoehnliche Links plus lokal ausgeliefertes Logo, kein Plug-in.
    - Hosting-Angabe ergaenzt (Impressum + Abschnitt 3): GitHub, Inc. als
    Auftragsverarbeiter, Server-Logs mit IP-Adressen ohne unseren Zugriff,
    Drittlandtransfer.
    - Neuer Abschnitt 4: keine Cookies, kein Tracking, kein Consent-Banner.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
2026-07-29 Planung: AP 5 als erledigt dokumentiert (Rev. 7)
    Neue Befunde N (vier Sketchfab-iframes - die Badge-Zaehlung in Befund L
    sah nur <img>), O (LinkedIn-Abschnitt ohne Komponente, E-Mail-Adresse im
    Impressum, fehlende Affiliate-Hinweise), P (Front Matter `introduction`
    war nicht baseurl-fest) und Q (html-proofer meldet einen fehlenden
    baseurl in src="/assets/..." nicht - Grenze der Absicherung aus AP 2/3).
    Korrektur der Tabelle in Befund L: zwei Fundorte waren falsch zugeordnet,
    eine fuenfte shields.io-URL war eine nie gerenderte Referenzdefinition.
    Punkt AP 5.4 war um Faktor 8 unterschaetzt: 25 Nennungen, nicht 3.
2026-07-30 AP 6: GitHub-Actions-Workflow fuer Build und Pages-Deployment
    Baut mit Jekyll 4.4 und JEKYLL_ENV=production, prueft und veroeffentlicht.
    Die vier Vorgaben aus AP 4/AP 5 sind umgesetzt:
    - html-proofer mit --swap-urls '^/Cindymill/:/' (baseurl steht seit AP 4
    dauerhaft in _config.yml)
    - kein --safe und kein klassischer Pages-Build, sonst faellt
    _plugins/image_attributes.rb still aus
    - Abbruch ueber den Exit-Code, nicht ueber die Ausgabe (Befund M)
    - zwei grep-Waechter fuer die Fehlerklassen, fuer die html-proofer blind
    ist: Asset-Pfade ohne baseurl (Befund Q) und fehlende Bildmasse
    Deployt wird nur von main. Push auf website-migration und Pull Requests
    durchlaufen Build und Pruefung oh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
2026-07-30 Planung: AP 6 als erledigt dokumentiert (Rev. 8)
    Ergebnisbericht zu AP 6, zwei Abweichungen begruendet (weiter gefasster
    Trigger, schaerferer Waechter 2), Korrektur zu AP 3.1 (die Lockdatei
    enthaelt zehn Plattformen inkl. x86_64-linux-gnu, nicht nur zwei).
    Zwei Risiken sind damit abgesichert statt nur benannt: stiller Ausfall
    von _plugins/ und die Blindheit von html-proofer fuer fehlende baseurls.
    Neuer Schritt AP 7.0: Probelauf auf website-migration vor dem Merge.
2026-07-30 AP 6: Actions auf aktuelle Majors, Node-20-Deprecation weg
    Der erste Lauf (30525990144) war gruen, meldete aber eine Annotation:
    actions/checkout@v4 und das intern genutzte upload-artifact zielen auf
    Node.js 20 und wurden auf Node 24 gezwungen.
    checkout v4->v7, upload-pages-artifact v3->v5, deploy-pages v4->v5.
    upload-pages-artifact nimmt seit v4 keine Dotfiles mehr ins Artefakt.
    Vor dem Bump geprueft: der Build enthaelt keine (0 von 217 Dateien).
    Als Kommentar im Workflow vermerkt, samt Ausweg (include-hidden-files).
2026-07-30 Planung: AP 7.0 ausgefuehrt, Doku auf Rev. 9
    gh auth login und Pages-Source sind gesetzt, damit war AP 7.0 sofort
    moeglich. Branch gepusht, Workflow zweimal gruen gelaufen.
    Dokumentiert: die Vorab-Kontrolle auf personenbezogene Daten (Historie
    sauber, einzige echte IP ist die Ionos-Server-IP aus diesem Dokument),
    beide Laeufe mit ihren Kennzahlen, der Action-Bump gegen die Node-20-
    Annotation und der dabei beinahe eingebaute Dotfile-Verlust.
    Die drei nach AP 6 offenen Unbekannten sind beantwortet - vor allem
    greift _plugins/image_attributes.rb auf dem Runner (181/181 <img>).
    AP 0.10 abgehakt, AP 7.0 abgehakt, offen ab AP 7.1.
2026-07-30 AP 7.3: die vier Readme-Dateien auf die neue Adresse umbiegen
    Das waren die letzten vier cindymill.xyz-Links im Repo; die Jekyll-
    Quellen sind seit AP 5 sauber.
    model/Tools, model/.../Spacers: Link auf die Pages-URL.
    model/Accessories: Linktext und Linkziel waren verschieden - der Text
    sagte /accessories, das Ziel zeigte auf /addons. Eine Seite "addons"
    hat es im Build nie gegeben, der Link war also schon auf der alten
    Seite tot. Zeigt jetzt auf accessories.html.
    README.md neu gefasst: beschrieb bisher nur die Maschine. Jetzt mit
    Abschnitt zum Repository-Aufbau (Website im Root, CAD-Daten unter
    model/) und einem Hinweis fuer die 14 Forks, dass Pfade von vor dem
    Umbau ein model/ davor brauc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
2026-07-30 Planung: AP 7.3 (Readme-Dateien) dokumentiert, Doku auf Rev. 10
    Ergebnisbericht zu den vier umgebogenen Readme-Dateien, inkl. der
    Aufloesung des /addons-Widerspruchs und der Begruendung, warum die
    Fremd-Badges im README anders als auf der Website remote bleiben
    (GitHub-Camo-Proxy - das Argument aus Befund L greift dort nicht).
    Korrektur zu AP 7.3: das "Website"-Feld des Repos zeigt nicht auf
    cindymill.xyz, es ist leer. Bleibt zu setzen, sinnvoll erst nach dem
    ersten Deployment.
    Die beiden Weitergaben aus AP 4 und AP 5 sind damit abgeschlossen.
2026-07-30 Planung: AP 7.1 und 7.2 dokumentiert - die Site ist live (Rev. 11)
    Merge-Commit edd7de9, Deployment-Lauf 30527607219 (build 36 s,
    deploy 10 s). Der deploy-Job lief damit zum ersten Mal ueberhaupt.
    Ergebnisbericht mit der Pruefung gegen die Live-Site statt gegen
    _site/: 27/27 Seiten, 53/53 Galeriebilder, beide CAD-Downloads,
    0 Tracking, 0 Mixed Content, 0 Asset-Pfade ohne baseurl, einziger
    ladender Fremdserver ist sketchfab.com. Dazu die Gegenprobe zu
    Abschnitt 1.1: HTTP/2, gzip, Caching und gueltiges Zertifikat.
    Befund A ist damit nach rund 3,8 Jahren behoben.
    Offen bleibt der visuelle Durchgang - Bildqualitaet und Layout
    prueft kein curl.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
2026-07-30 Impressum: Anschrift und Telefonnummer aktualisiert
    Neue Anschrift an beiden Stellen, an denen sie steht: im Impressum
    (Section 5 TMG) und als Verantwortlicher in Abschnitt 2 der
    Datenschutzerklaerung.
    Die Telefonnummer stand bisher in zwei Formaten da (+4940858878 im
    Impressum, 040858878 beim Verantwortlichen). Beide tragen jetzt die
    internationale Schreibweise - dieselbe Vereinheitlichung, die AP 5
    schon bei der E-Mail-Adresse noetig hatte (Befund O.2).
2026-07-30 Sidebar: Subscribe-Eintrag entfernt
    Der Eintrag verwies auf atom.xml und lieferte damit rohes Atom-XML
    aus - im Browser sieht das aus wie eine Fehlerseite. Auf Wunsch des
    Betreibers ersatzlos raus.
    Mit entfernt, weil danach tot: der Uebersetzungsschluessel
    t.subscribe in _data/theme.yml und _includes/icon-rss.svg, das von
    keiner anderen Stelle eingebunden wird. Dieselbe Aufraeumung wie bei
    der Suche in AP 3.
    Der Feed selbst bleibt: atom.xml wird weiter erzeugt und ist ueber
    <link rel="alternate"> im Kopf auffindbar, damit Feed-Reader die
    Blogbeitraege weiter finden. Nur der sichtbare Eintrag ist weg.
2026-07-30 Sidebar: die zwei Dateien nachreichen, die der Vorgaenger verloren hat
    Der Commit davor hat nur die Loeschung von _includes/icon-rss.svg
    mitgenommen: ein "git add" mit dem bereits per "git rm" entfernten
    Pfad in der Liste bricht ab und stellt gar nichts bereit, der
    anschliessende Commit nahm daher nur den vorgestagten Loeschvorgang.
    Damit stand auf main kurzzeitig ein Zustand, in dem
    contact-list.html eine geloeschte Datei einbindet - der Build musste
    scheitern. Genau dafuer gibt es den Workflow.
